TobyBorland/HydroTurbineBlade/docs/20120709_SaleD_pres_HARP_Opt.pdf

## HARP_Opt: An Optimization Code for System Design of Axial Flow Turbines

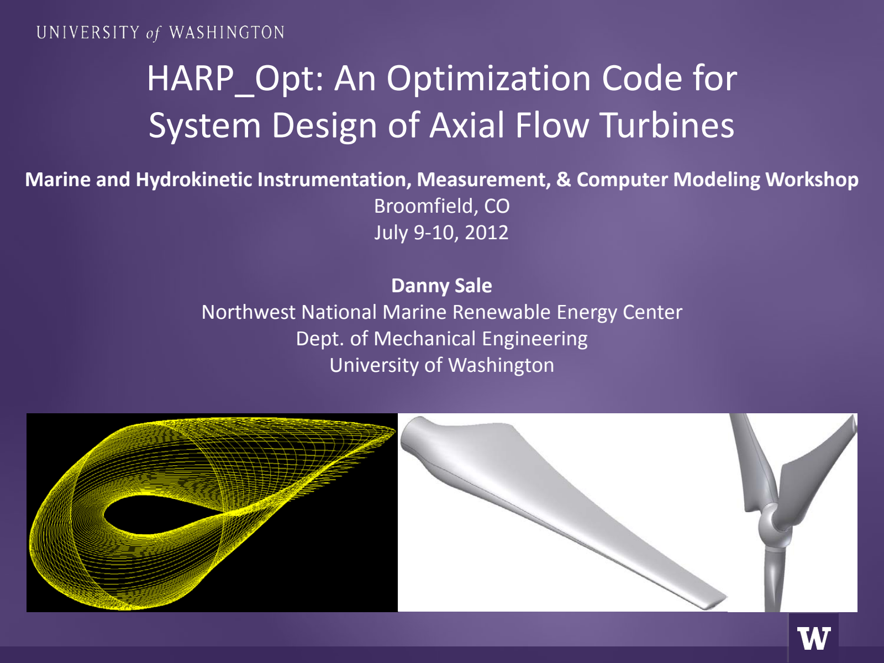
[picture p20: page 1]

Danny Sale
Northwest National Marine Renewable Energy Center Dept. of Mechanical Engineering University of Washington

Marine and Hydrokinetic Instrumentation, Measurement, & Computer Modeling Workshop Broomfield, CO
July 9-10, 2012

Objective
Develop a design tool for wind & hydrokinetic turbines rotors, combining
- aerodynamic models
- structural models
- multi-objective optimization

Motivation
- Difficult problem considering many variables & constraints
- Optimization leads to improved designs beyond our intuition
- Accelerate design process

Applications
- Sizing of new machines
- Modifications to existing designs

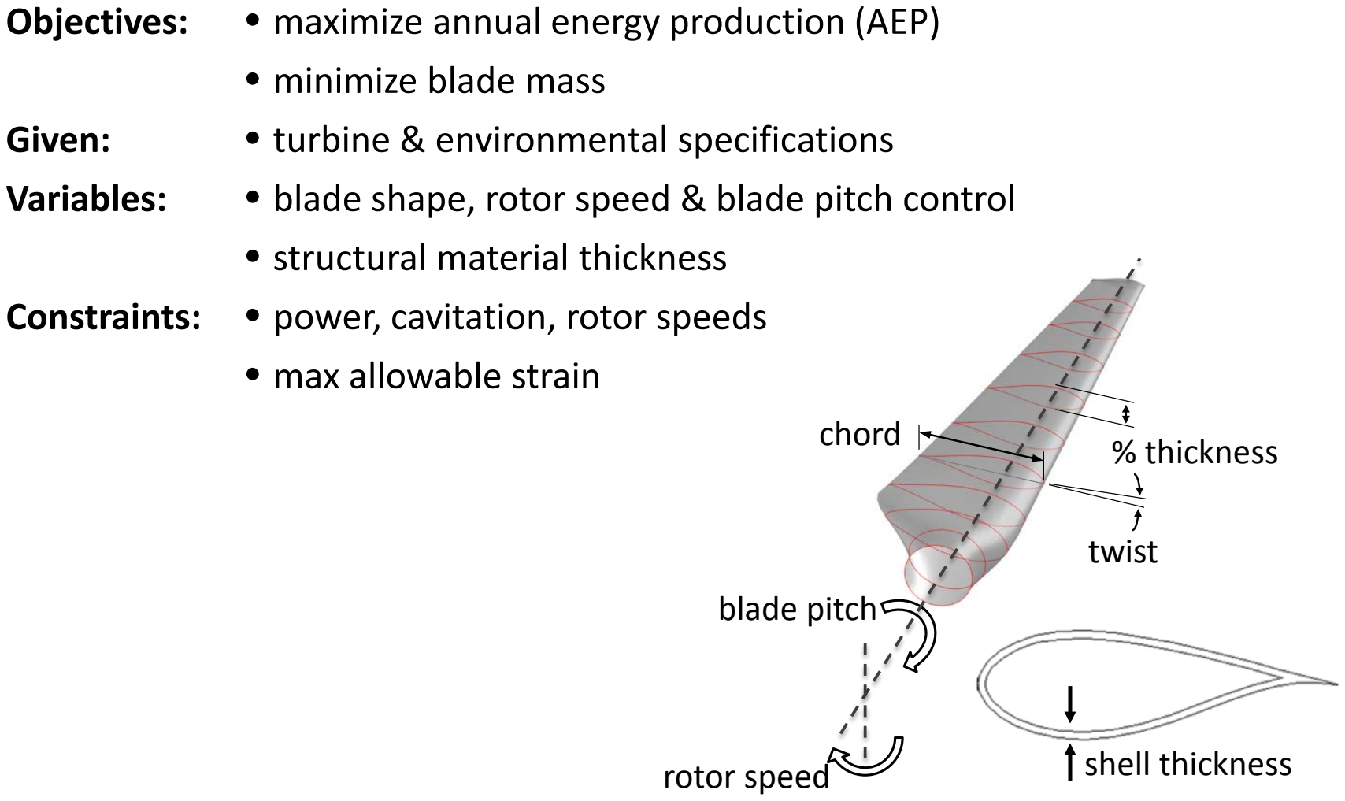
[picture p21: figure]
Objectives:; Given: Variables:; Constraints:; • minimize blade mass • turbine & environmental specifications; • structural material thickness • power, cavitation, rotor speeds • max allowable strain; chord; twist; % thickness; shell thickness; blade pitch; rotor speed

- maximize annual energy production (AEP)
- blade shape, rotor speed & blade pitch control

## Intro: HARP_Opt code

HARP_Opt (Horizontal Axis Rotor Performance Optimization)
An optimization code for the design of horizontal-axis wind and hydrokinetic turbines

## Technical Approach: Hydrodynamics

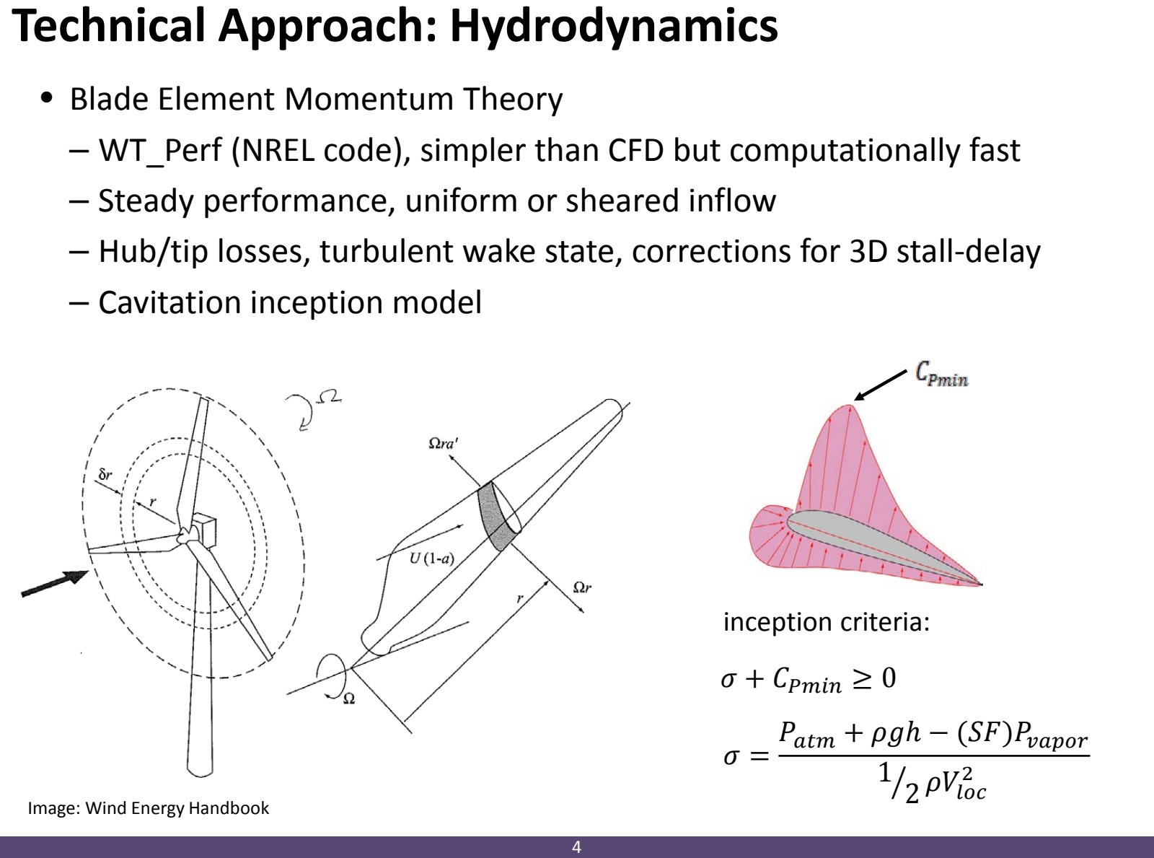
[picture p22: page 4]

Image: Wind Energy Handbook

- Blade Element Momentum Theory
– WT_Perf (NREL code), simpler than CFD but computationally fast – Steady performance, uniform or sheared inflow
– Hub/tip losses, turbulent wake state, corrections for 3D stall-delay – Cavitation inception model

# σ + CPPPP ≥ 0

σ =

# Paa + ρρρ − (SS)Pv vvv

1

# 2 ρρl l

2

inception criteria:

## Technical Approach: Structural Mechanics

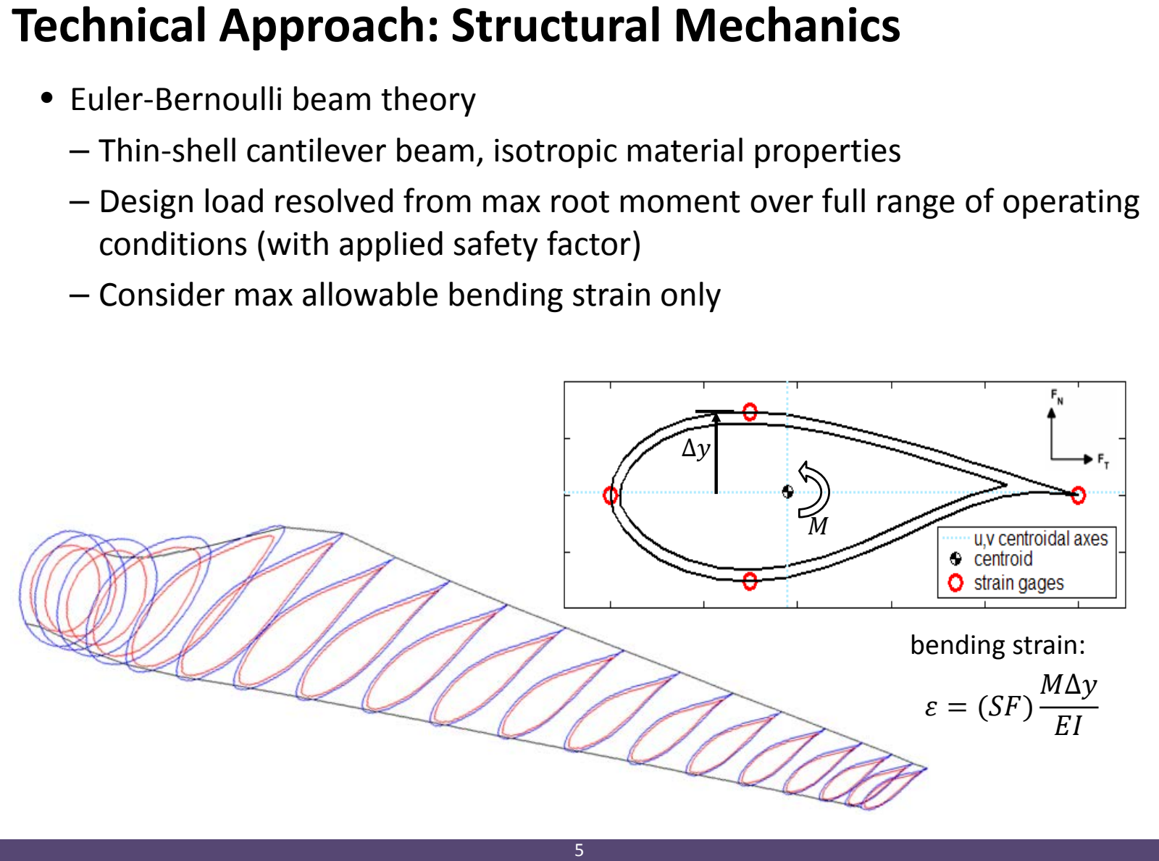
[picture p23: page 5]

bending strain:

# ε = (SS)

# MΔy

EE

M

Δy

- Euler-Bernoulli beam theory
– Thin-shell cantilever beam, isotropic material properties
– Design load resolved from max root moment over full range of operating conditions (with applied safety factor)
– Consider max allowable bending strain only

## Technical Approach: Optimization

Optimization Algorithm
- Multi-Objective Genetic Algorithm
– Mimics biological evolution, i.e. “survival of the fittest”
– Slow convergence, good for multi-optima problems, no gradient info required Objectives and Fitness Function
- Penalty method (a constrained problem becomes unconstrained)

# AAA ∗ p

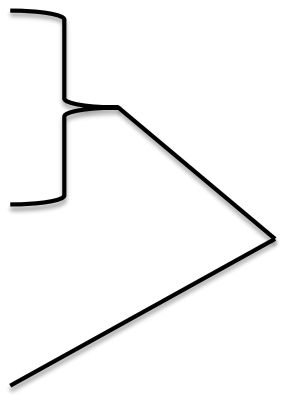
[picture p24: figure]

# bbbbb m mm ∗ p

## p pp

p

# p tt

# p t t tt

Maximize:

Minimize:

Penalty factors are proportional to the violation of constraints

## Technical Approach: Blade Geometry

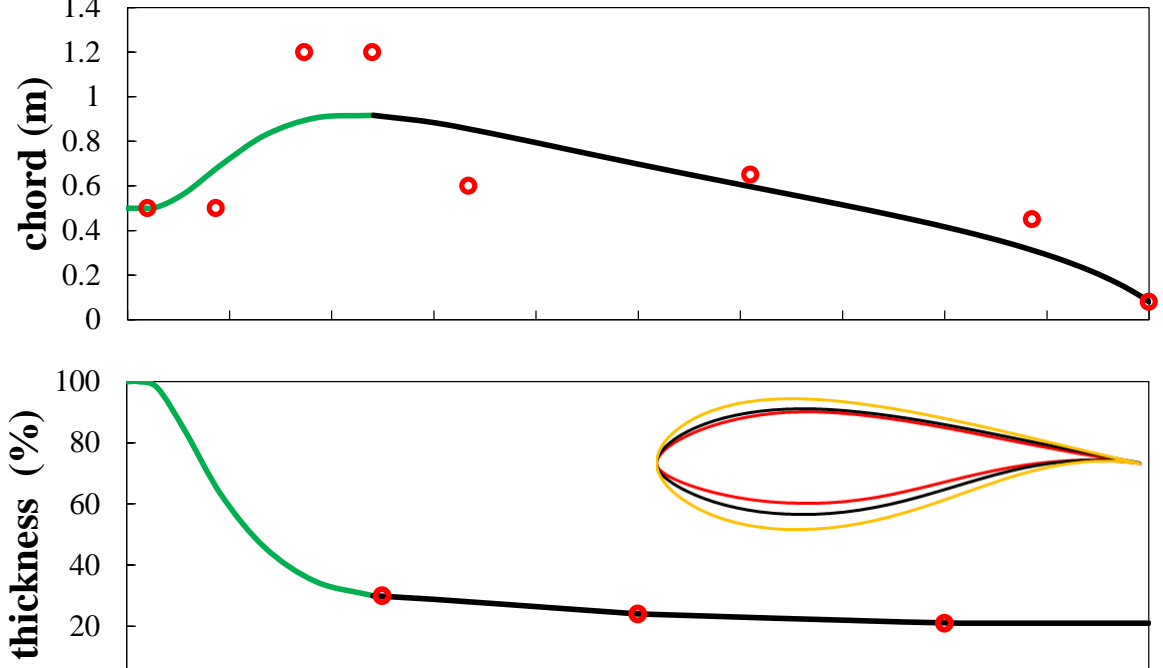
[picture p25: figure]
chord (m); thickness (%)
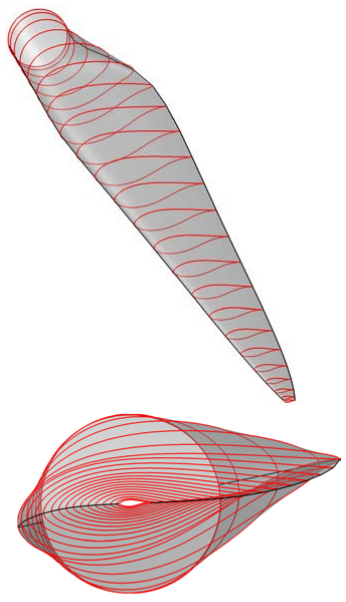
[picture p26: figure]

•Bézier curves define twist and chord distributions
•% thickness denotes airfoil placement
•Great degree of freedom in possible blade shapes

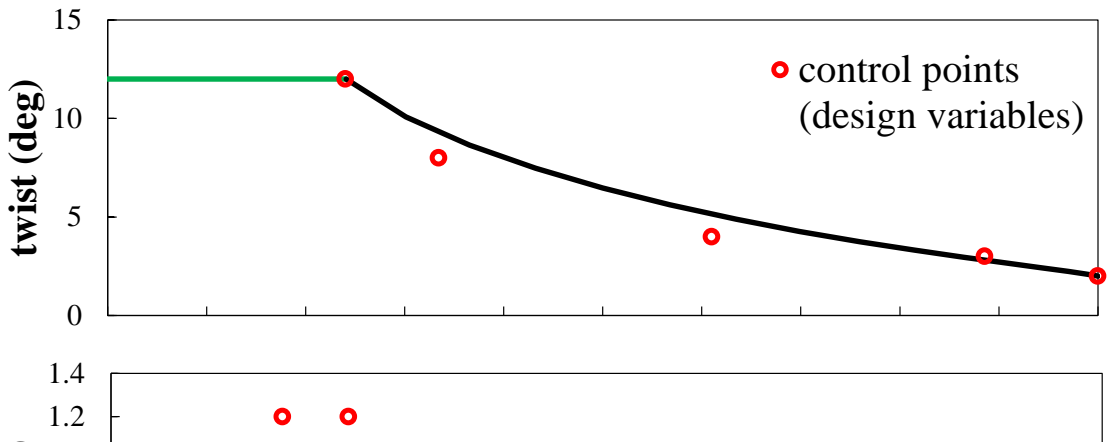
[picture p27: figure]
twist (deg); control points (design variables)
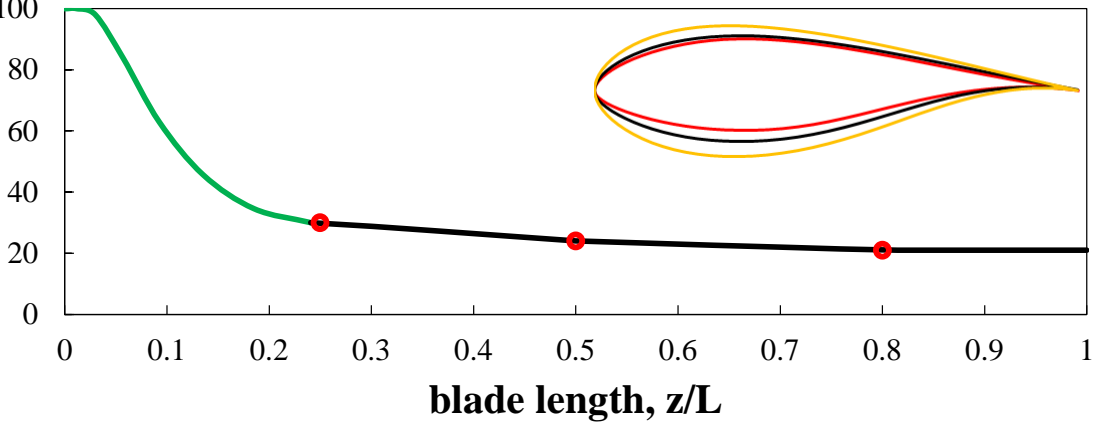
[picture p28: figure]
blade length, z/L

## Technical Approach: Design Algorithm

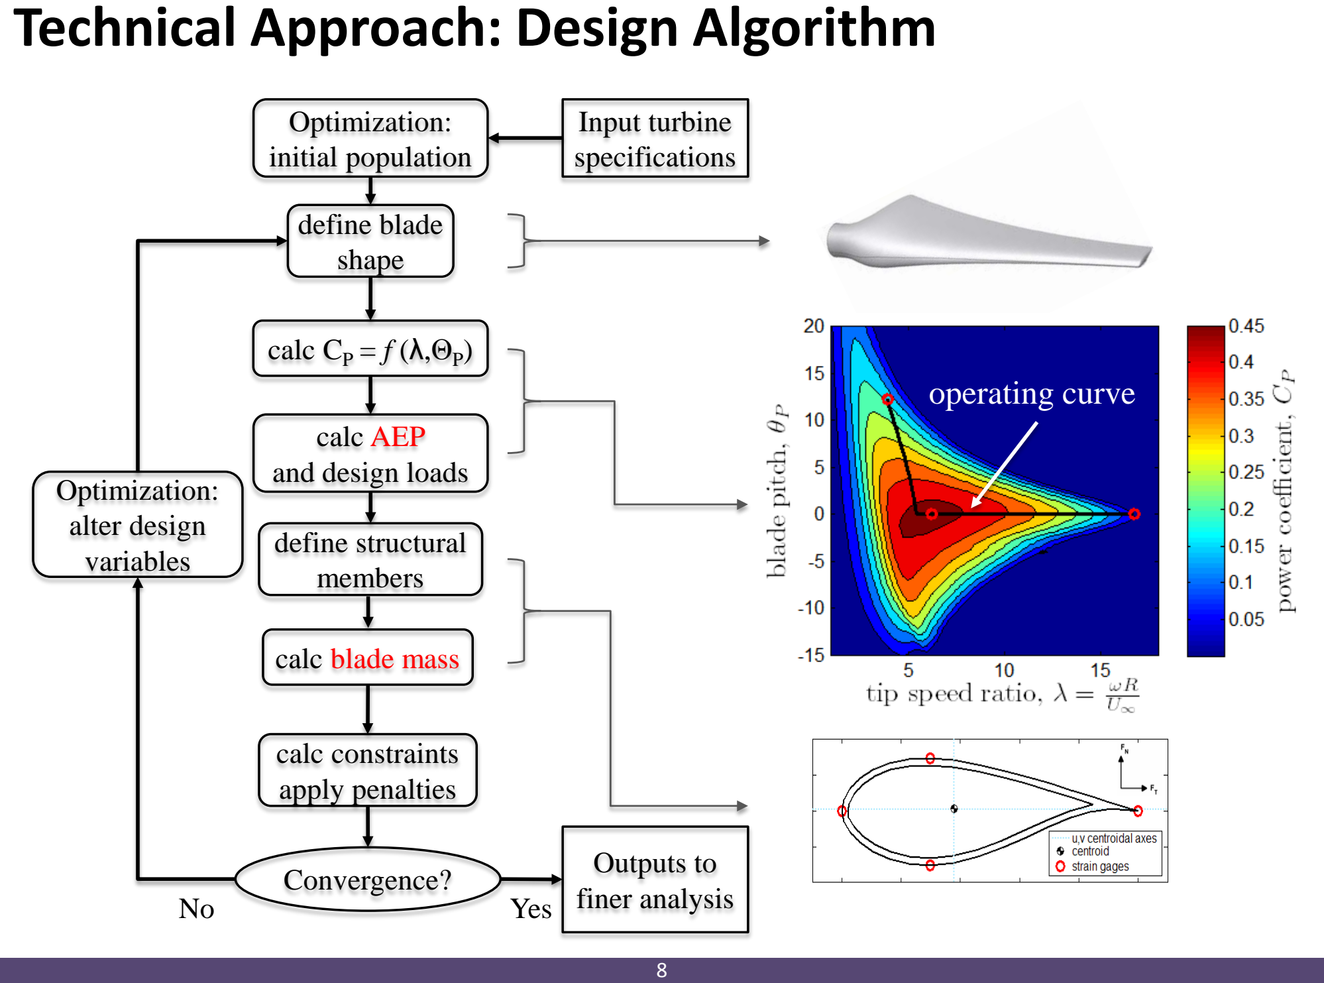
[picture p29: page 8]

Input turbine
specifications

Optimization:
initial population
define blade
shape

calc CP = f (λ,ΘP)

calc AEP
and design loads

define structural
members

calc blade mass

calc constraints
apply penalties

Convergence?

Optimization:
alter design
variables

Outputs to
No | Yes finer analysis

operating curve

## Applications: Example #1

Design of 5m dia., 72 kW MHK turbine: investigate various control schemes
- Fixed-Speed Fixed-Pitch
- Fixed-Speed Variable-Pitch
- Variable-Speed Variable-Pitch
- Variable-Speed Fixed-Pitch

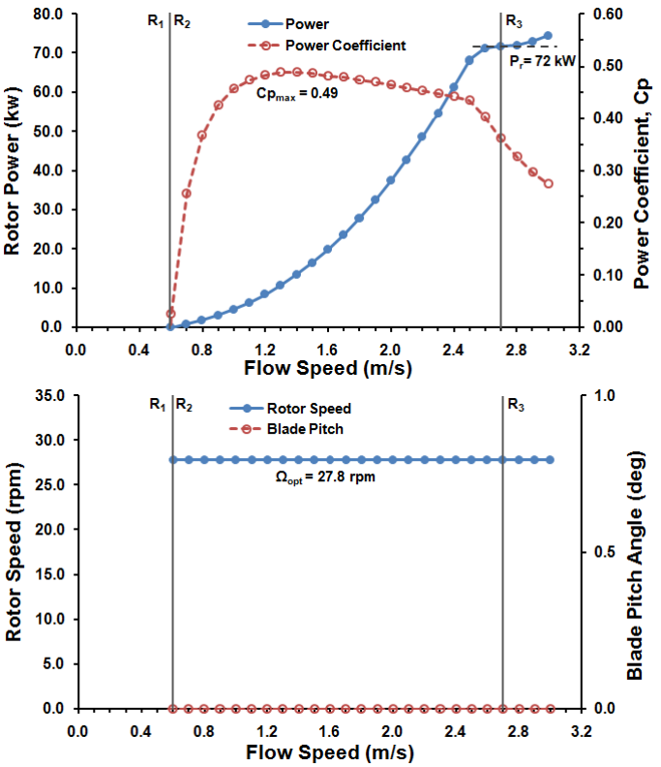
[picture p30: figure]

## Applications: Example #1

Design of 5m dia., 72 kW MHK turbine: investigate various control schemes
- Fixed-Speed Fixed-Pitch
- Fixed-Speed Variable-Pitch
- Variable-Speed Variable-Pitch
- Variable-Speed Fixed-Pitch

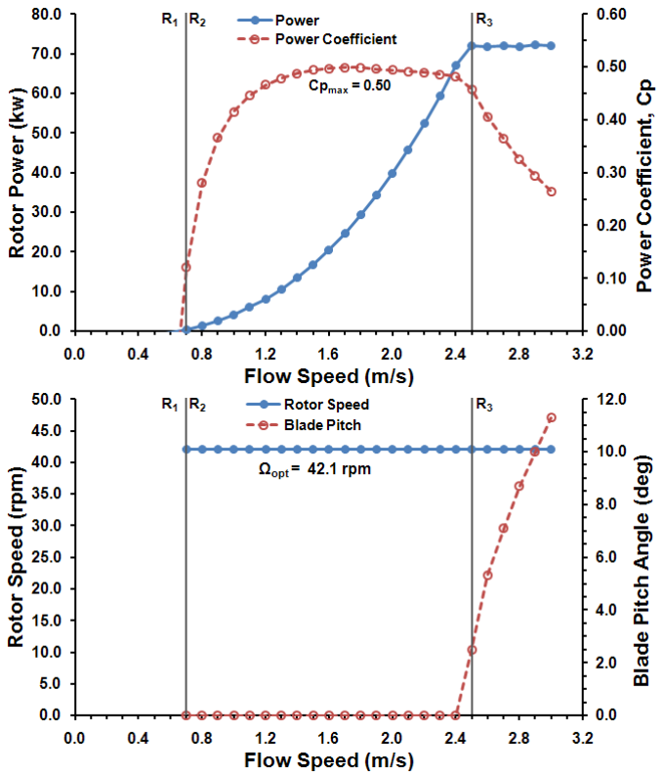
[picture p31: figure]

## Applications: Example #1

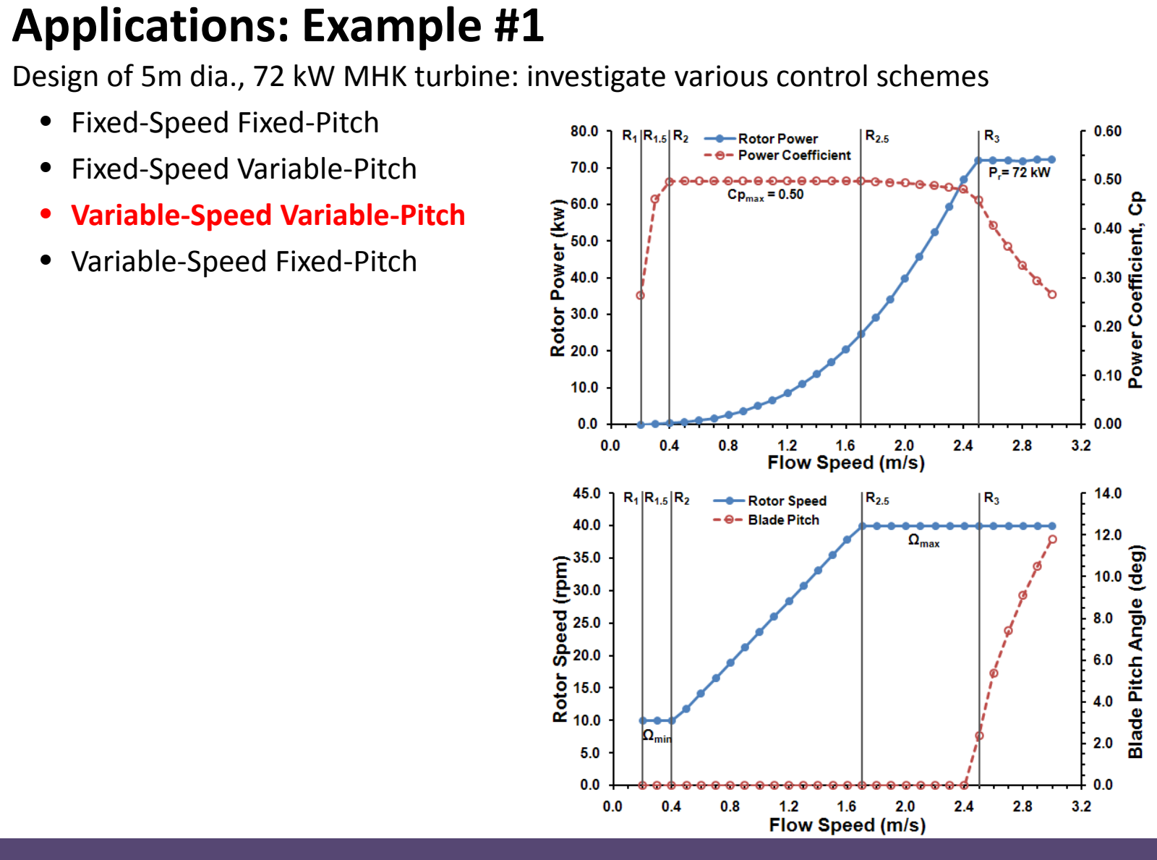
[picture p32: page 11]

Design of 5m dia., 72 kW MHK turbine: investigate various control schemes
- Fixed-Speed Fixed-Pitch
- Fixed-Speed Variable-Pitch
- Variable-Speed Variable-Pitch
- Variable-Speed Fixed-Pitch

## Applications: Example #1

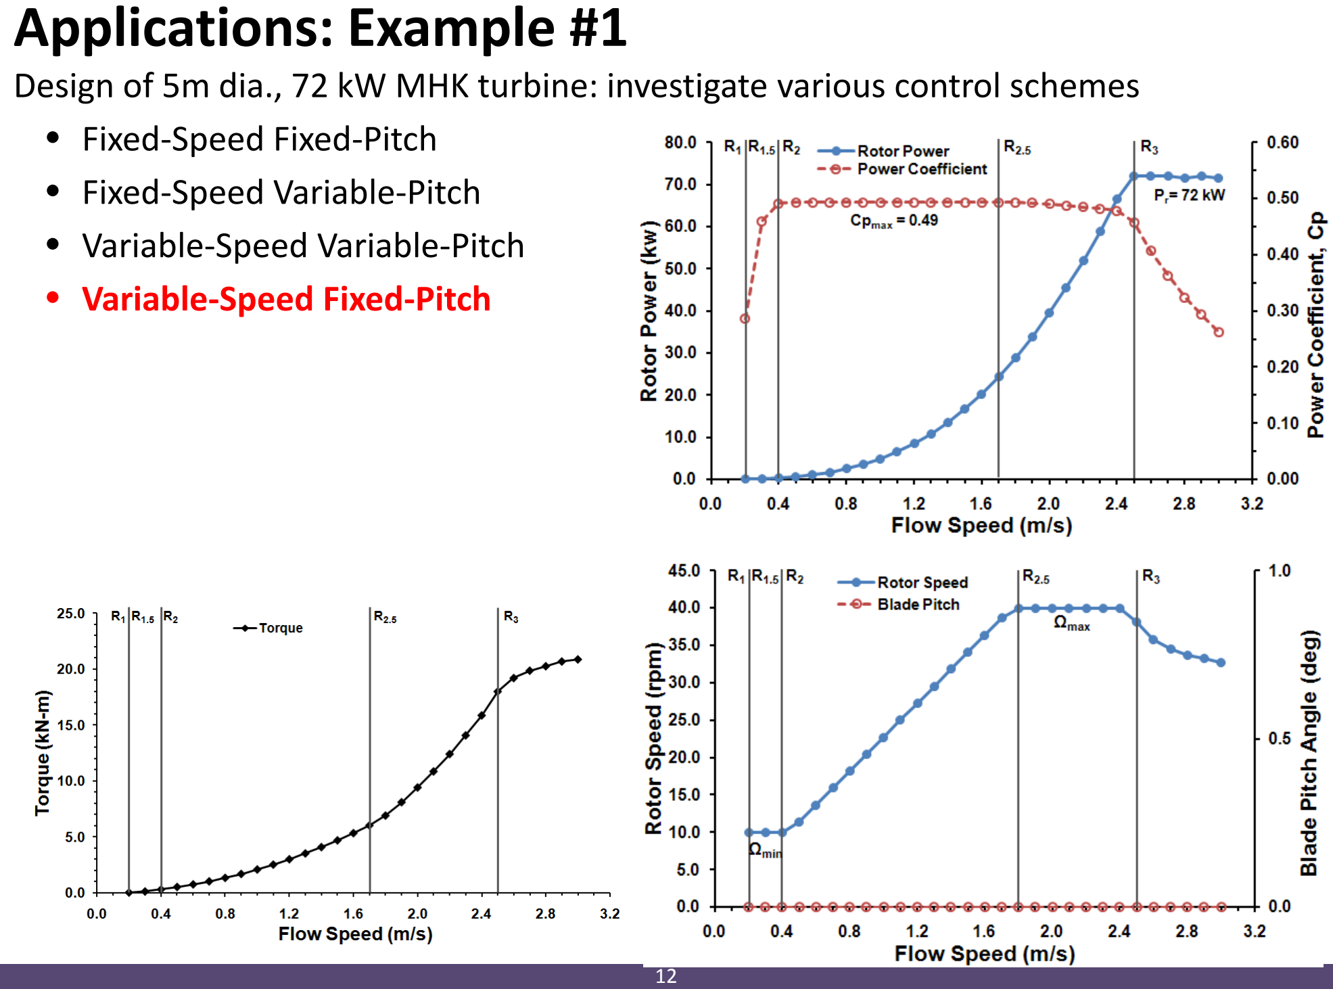
[picture p33: page 12]
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

## Applications: Example #1

Summary of Performance Data
Vrated | Cpmax | AEP | Max Flap | Max Torque | Max Thrust
(m/s) | (-) | (kW-hr/yr) | (kN-m) | (kN-m) | (kN)
FS-FP | 2.7 | 0.49 | 148000 | 21.7 | 25.6 | 47.0
FS-VP | 2.5 | 0.50 | 152000 | 21.4 | 16.4 | 46.0
VS-VP | 2.5 | 0.50 | 155000 | 21.5 | 17.3 | 45.7
VS-FP | 2.5 | 0.49 | 154000 | 22.0 | 20.9 | 45.8

## Applications: Example #2

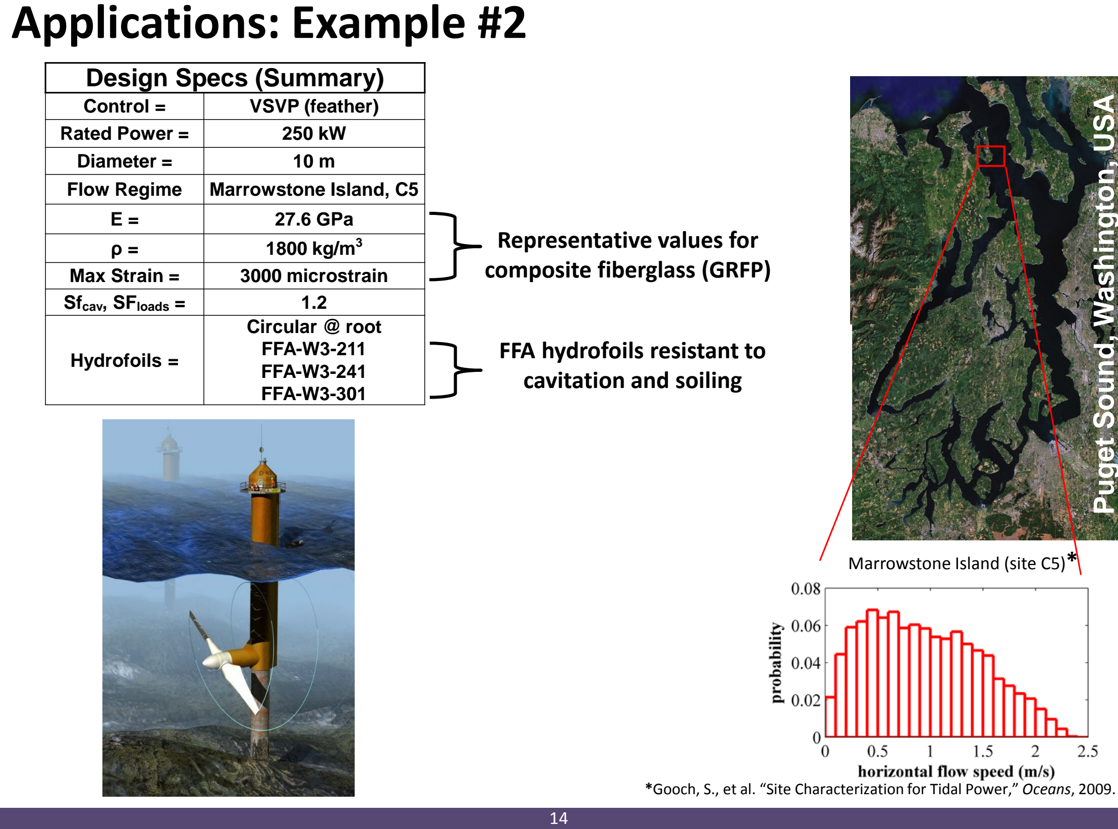
[picture p34: page 14]

Design Specs (Summary)
Control = | VSVP (feather)
Rated Power = | 250 kW
Diameter = | 10 m
Flow Regime | Marrowstone Island, C5
E = | 27.6 GPa
ρ = | 1800 kg/m³
Max Strain = | 3000 microstrain
Sfcav, SFloads = | 1.2
Hydrofoils = | Circular @ root FFA-W3-211 FFA-W3-241 FFA-W3-301

Marrowstone Island (site C5)*

*Gooch, S., et al. “Site Characterization for Tidal Power,” Oceans, 2009.Puget Sound, Washington, USA

Representative values for
composite fiberglass (GRFP)

FFA hydrofoils resistant to cavitation and soiling

## Applications: Example #2

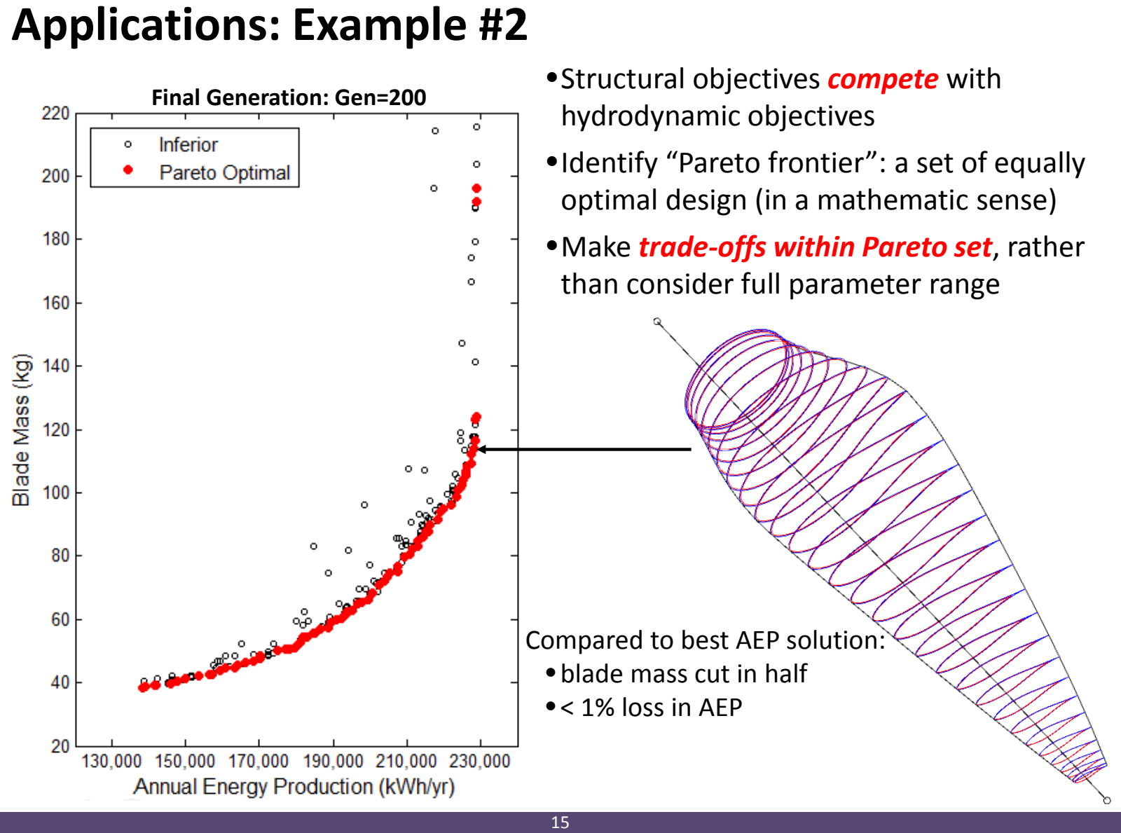
[picture p35: page 15]

•Mass = ? kg
•AEP = ? kWh/yr
•Cost: fiberglass = ? $/kg •Cost = ? $

Final Generation: Gen=200

•Structural objectives compete with hydrodynamic objectives
•Identify “Pareto frontier”: a set of equally optimal design (in a mathematic sense) •Make trade-offs within Pareto set, rather than consider full parameter range

Compared to best AEP solution:
- blade mass cut in half
- < 1% loss in AEP

## Moving Forward:

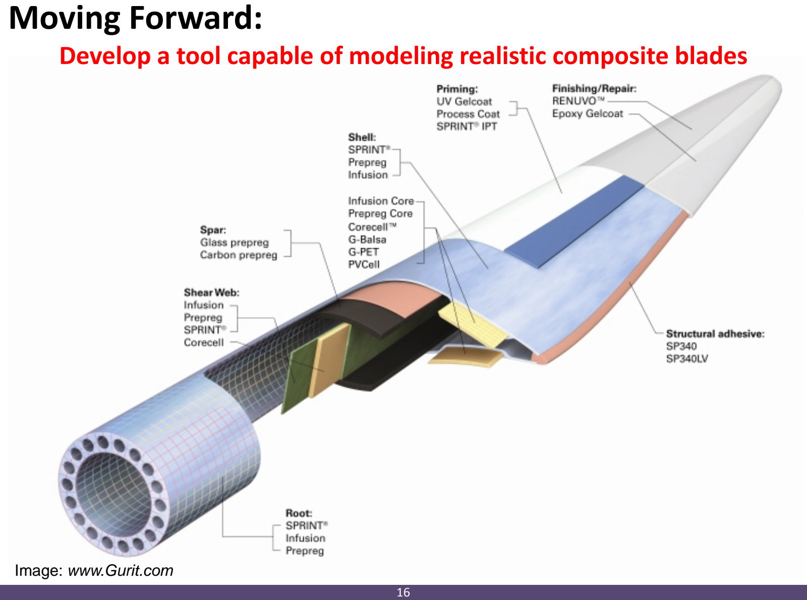
[picture p36: page 16]

### Develop a tool capable of modeling realistic composite blades

Image: www.Gurit.com

## Future Direction: Advanced Structural Optimization

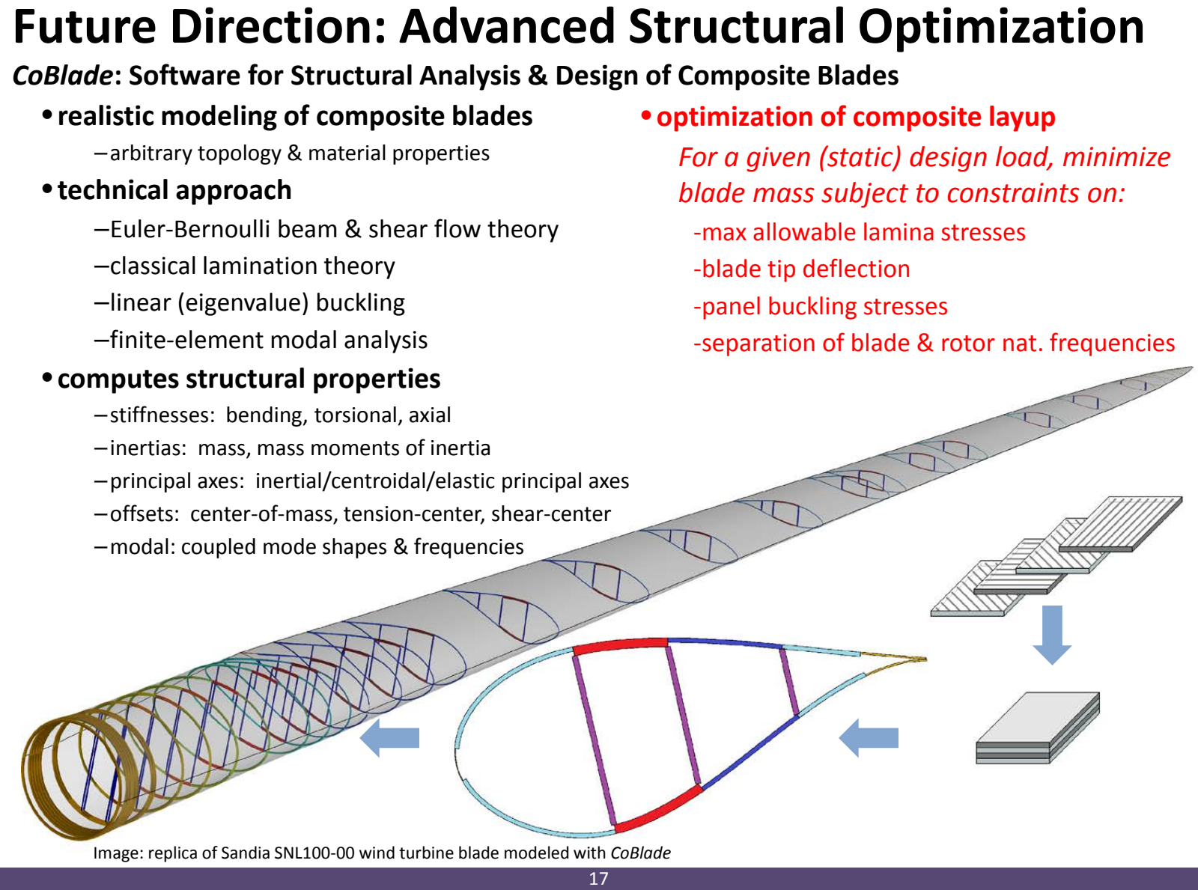
[picture p37: page 17]

CoBlade: Software for Structural Analysis & Design of Composite Blades •realistic modeling of composite blades
–arbitrary topology & material properties
•technical approach
–Euler-Bernoulli beam & shear flow theory –classical lamination theory
–linear (eigenvalue) buckling –finite-element modal analysis
- computes structural properties
–stiffnesses: bending, torsional, axial
–inertias: mass, mass moments of inertia
–principal axes: inertial/centroidal/elastic principal axes –offsets: center-of-mass, tension-center, shear-center –modal: coupled mode shapes & frequencies

Image: replica of Sandia SNL100-00 wind turbine blade modeled with CoBlade

- optimization of composite layup
For a given (static) design load, minimize blade mass subject to constraints on: -max allowable lamina stresses
-blade tip deflection
-panel buckling stresses
-separation of blade & rotor nat. frequencies

## Future Direction: Advanced Structural Optimization

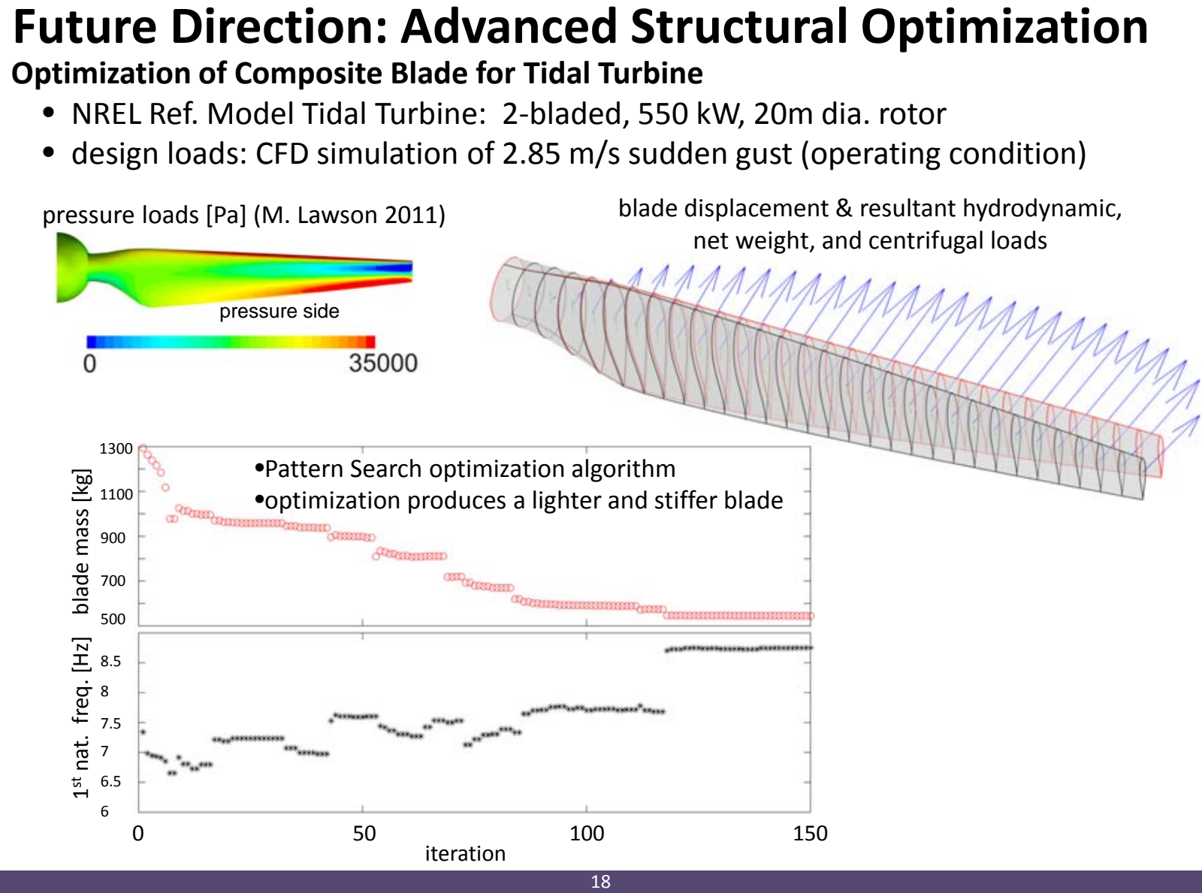
[picture p38: page 18]

Optimization of Composite Blade for Tidal Turbine
- NREL Ref. Model Tidal Turbine: 2-bladed, 550 kW, 20m dia. rotor
- design loads: CFD simulation of 2.85 m/s sudden gust (operating condition) blade mass [kg]

1st nat. freq. [Hz]

1300

1100

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
iteration

0 | 50 | 100 | 150

pressure loads [Pa] (M. Lawson 2011)

pressure side

blade displacement & resultant hydrodynamic, net weight, and centrifugal loads

•Pattern Search optimization algorithm •optimization produces a lighter and stiffer blade

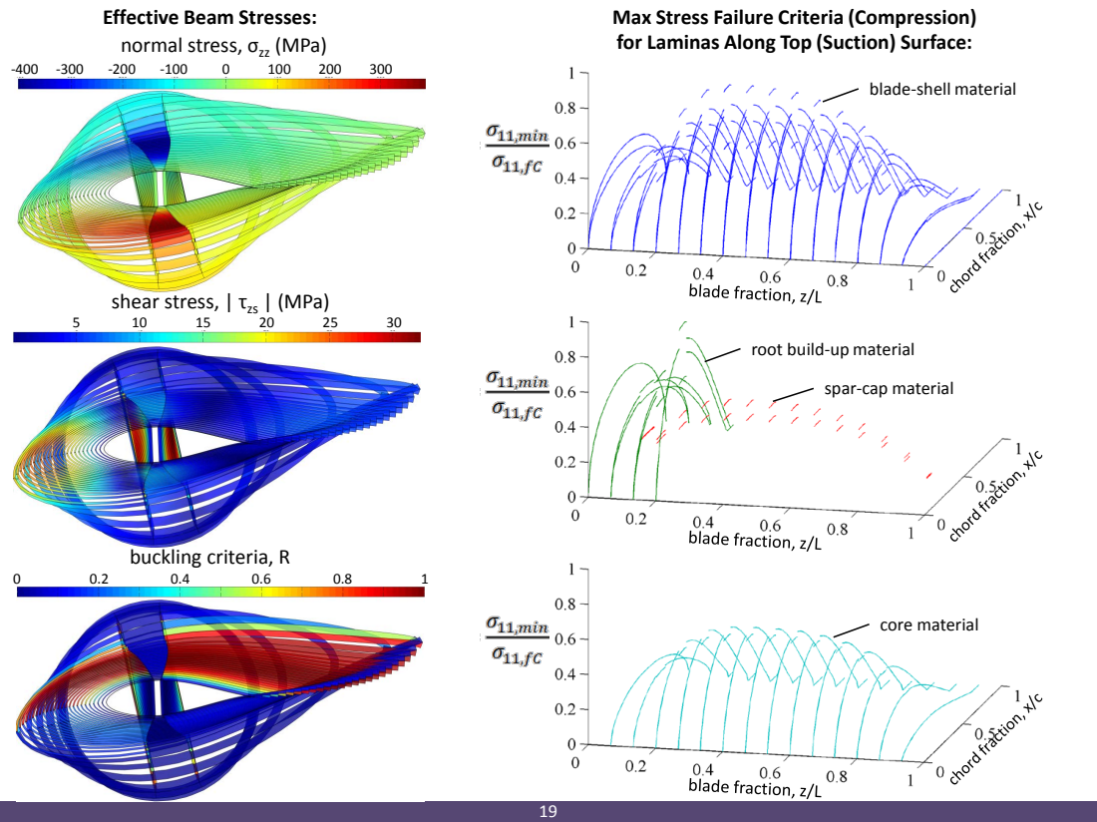
[picture p39: page 19]
buckling criteria, R; core material

Effective Beam Stresses:
normal stress, σzz (MPa)

Max Stress Failure Criteria (Compression)
for Laminas Along Top (Suction) Surface:

blade-shell material

shear stress, | τzs | (MPa)

root build-up material

spar-cap material

## Areas for Refinement

## Progress to-date:

- developed preliminary design tool for axial flow wind & hydrokinetic turbines, method is generalized to a variety of turbine configurations & sizes
- consideration of multiple design criteria & constraints leads to satisfactory design in all areas (hydrodynamics, structures, & controls)
- enabling improved performance & reduced design time

Short-term (Sept. 2012 release)
- implement Pattern Search optimization algorithm (much faster & deterministic)
- improve MATLAB/Fortran interface, allowing for parallel HPC
- make HARP_Opt cross-platform, develop GUI and non-GUI versions for improved usability & interfacing
Longer-term
- consider fatigue as design criteria (hydro-elastic analysis, i.e. FAST code)

# Thank you! Questions?

# Acknowledgements

This work has also been made possible by
- U.S. Department of Energy, National Renewable Energy Laboratory
- University of Washington, Northwest National Marine Renewable Energy Center
- National Science Foundation, Graduate Research Fellowship under Grant No. DGE-0718124 wind.nrel.gov/designcodes/simulators/HARP_Opt/ wind.nrel.gov/designcodes/simulators/WT_Perf/

WT_Perf: Turbine Performance Simulator

HARP_Opt: Optimization Software for Turbine Design

CoBlade: Software for Analysis & Design of Composite Blades
no website yet—contact dsale@uw.edu for source & documentation
Sale & Aliseda (2012) “Structural Design of Composite Blades for Wind &Hydrokinetic Turbines” depts.washington.edu/nnmrec/docs/20120213_SaleD_pres_StructuralDesign.pdf

Special thanks to the crew at NWTC!

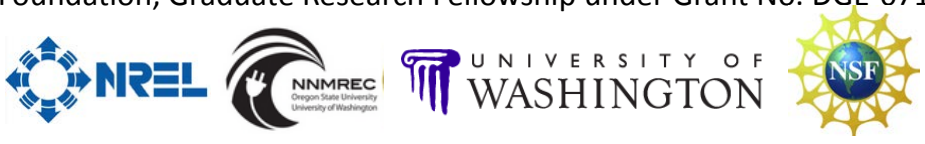
[picture p40: figure]
