TobyBorland/HydroTurbineBlade/SWKS_hydrofoil/bladedesign.xls

blade design spreadsheet
first finding the diameter:
BLUE CELLS FOR DATA ENTRY RED FOR RESULTS
Tip speed ratio | TSR | 7
Diameter (m) | D | 2.00
number of blades ? | B | 3
angle of attack (degrees) | AT | 4
Lift coefficient | Cl | 0.8
No. of stations | STN | 10
 |  |  |  | All dimensions in metres. [0.001m=1mm.]
 |  |  |  | recommended |  | Enter chosen widths
station | radius | angle | angle | Chord | wood width | actual wood width | drop | thickness(m)
 | rad. | AB radians | AB degrees | C | WW | ww2 |  | T
1 | 0.10 | 0.691 | 39.6 | 0.250 | 0.192 | 0.150 | 0.1241045225 | 0.039
2 | 0.20 | 0.375 | 21.5 | 0.194 | 0.181 | 0.150 | 0.05897663736 | 0.024
3 | 0.30 | 0.238 | 13.6 | 0.144 | 0.140 | 0.140 | 0.03393845251 | 0.019
4 | 0.40 | 0.164 | 9.4 | 0.113 | 0.111 | 0.111 | 0.0183864749 | 0.014
5 | 0.50 | 0.118 | 6.8 | 0.092 | 0.091 | 0.091 | 0.01085722461 | 0.011
6 | 0.60 | 0.088 | 5.0 | 0.077 | 0.077 | 0.077 | 0.006773530928 | 0.009
7 | 0.70 | 0.065 | 3.7 | 0.067 | 0.067 | 0.067 | 0.004366082225 | 0.008
8 | 0.80 | 0.049 | 2.8 | 0.059 | 0.059 | 0.059 | 0.002856111792 | 0.007
9 | 0.90 | 0.036 | 2.0 | 0.052 | 0.052 | 0.052 | 0.001863377037 | 0.006
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
