TobyBorland/HydroTurbineBlade/docs/images/1W5_BW3_1m_Input.bmp

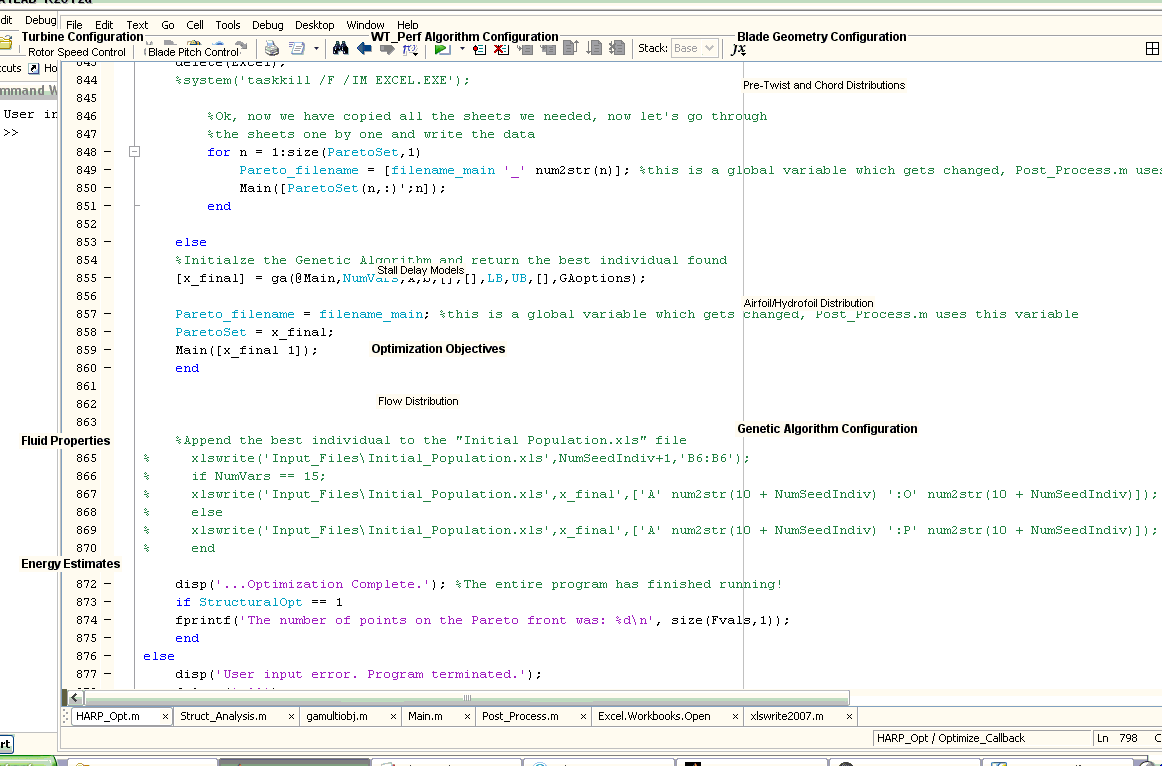
docs/images/1W5_BW3_1m_Input.bmp
