TobyBorland/HydroTurbineBlade/docs/images/BladesX3.JPG

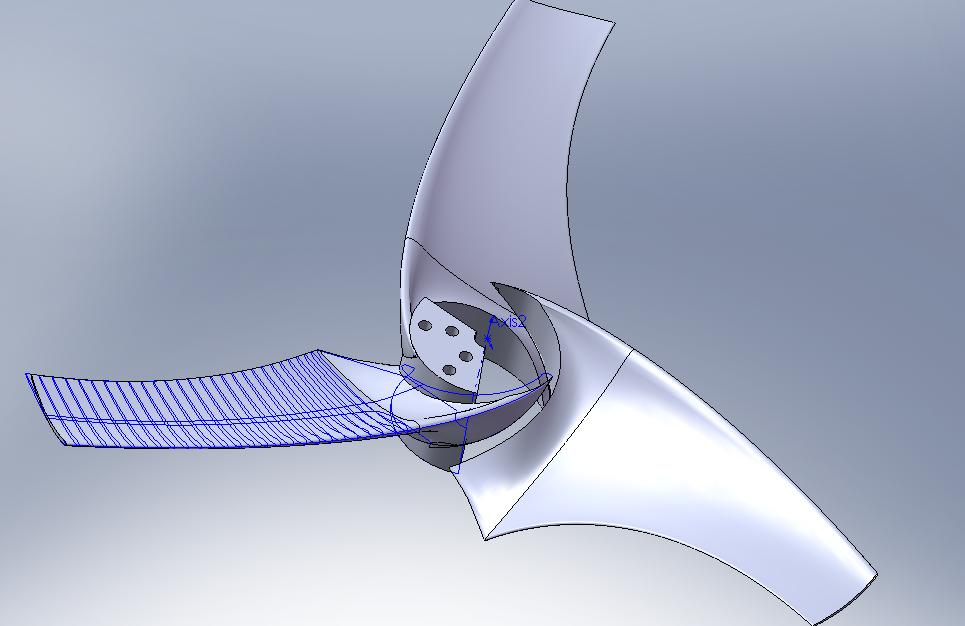
docs/images/BladesX3.JPG
