TobyBorland/HydroTurbineBlade/docs/images/Flange_dims.png

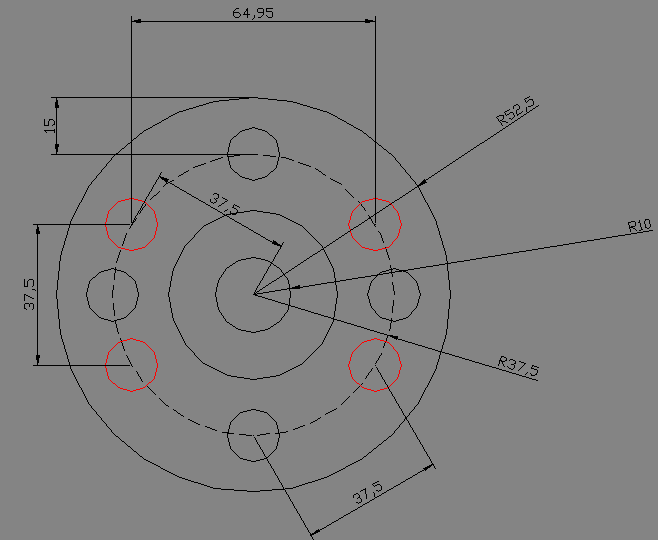
docs/images/Flange_dims.png
