TobyBorland/HydroTurbineBlade/docs/images/foils.JPG

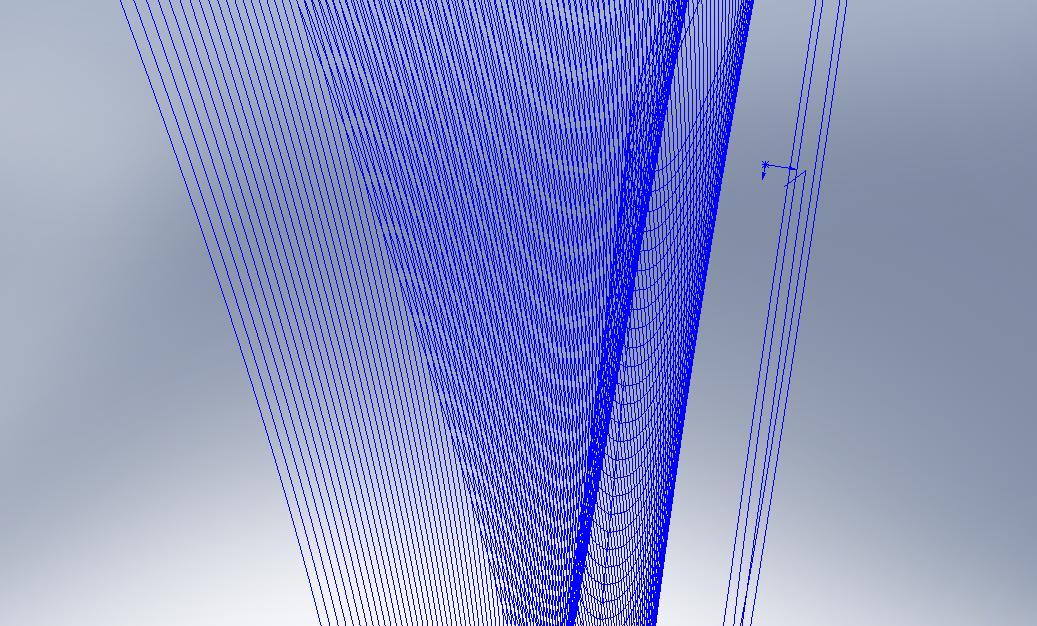
docs/images/foils.JPG
