TobyBorland/HydroTurbineBlade/docs/images/Maidenhead flow rate.png

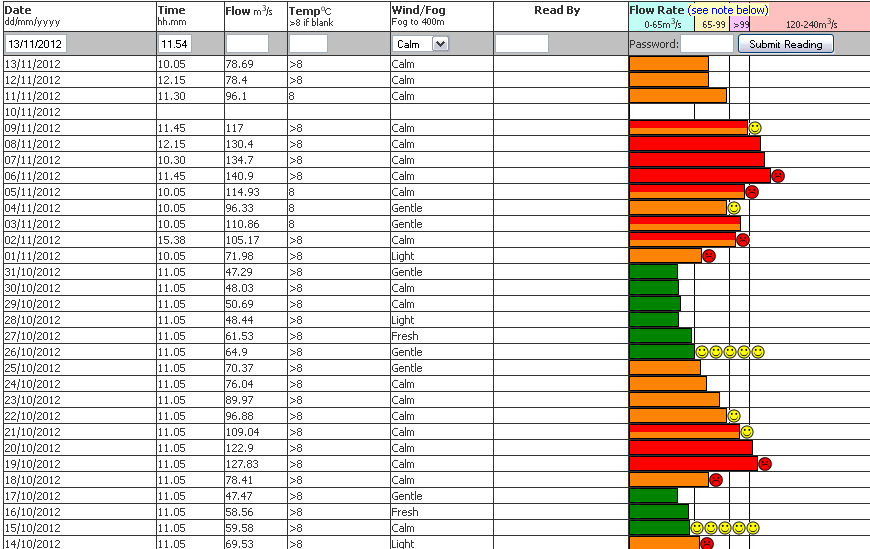
docs/images/Maidenhead flow rate.png
