TobyBorland/HydroTurbineBlade/docs/images/Root_curve2.JPG

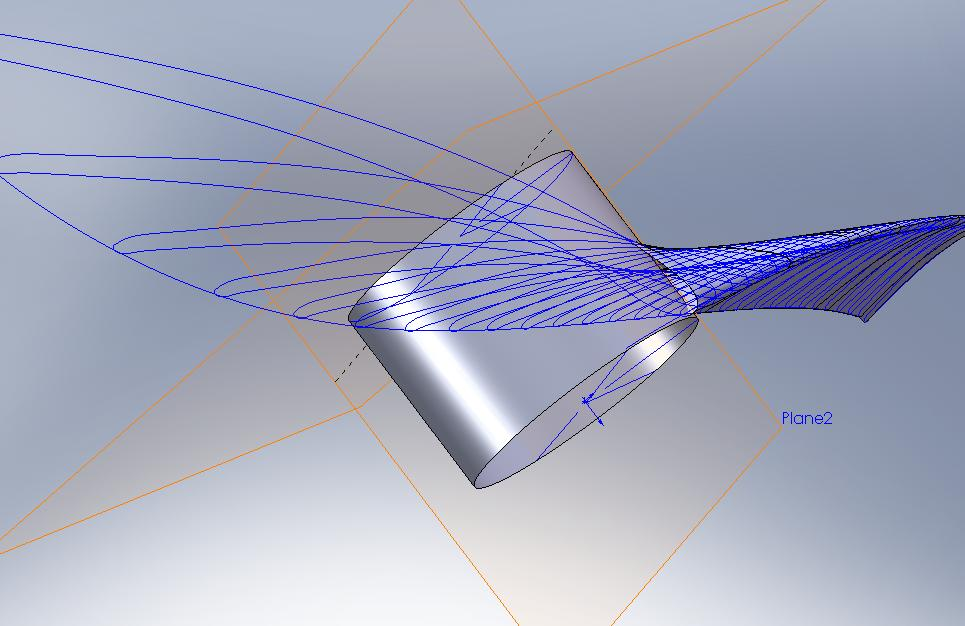
docs/images/Root_curve2.JPG
