TobyBorland/HydroTurbineBlade/docs/images/Spiral curvature.png

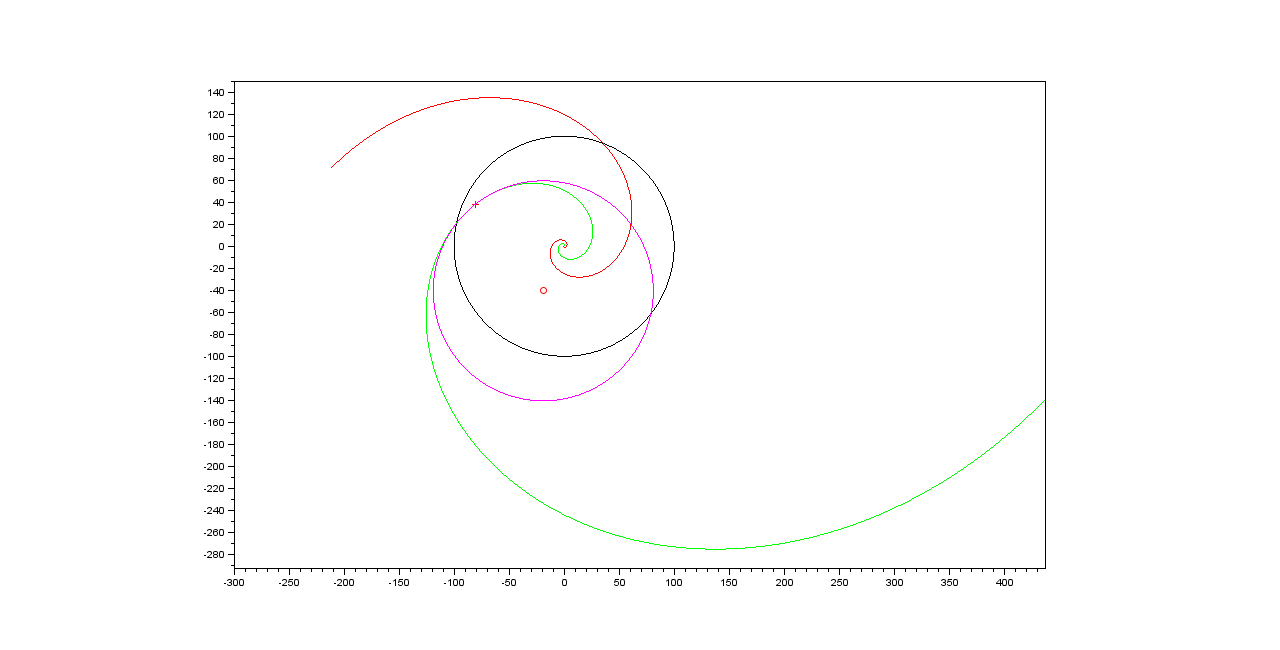
docs/images/Spiral curvature.png
