TobyBorland/HydroTurbineBlade/docs/images/Thames_Tower_level.png

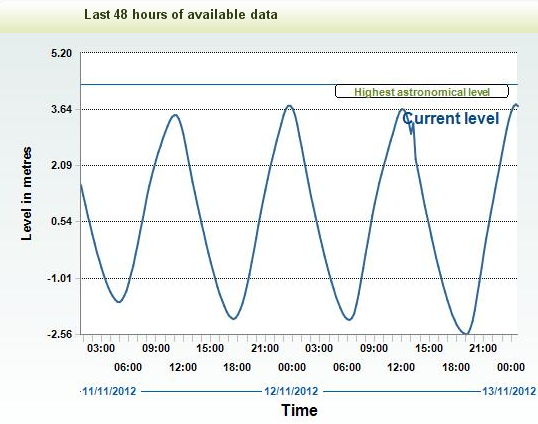
docs/images/Thames_Tower_level.png
