TobyBorland/HydroTurbineBlade/HARP/HARP2SWKS/sweep_log.png

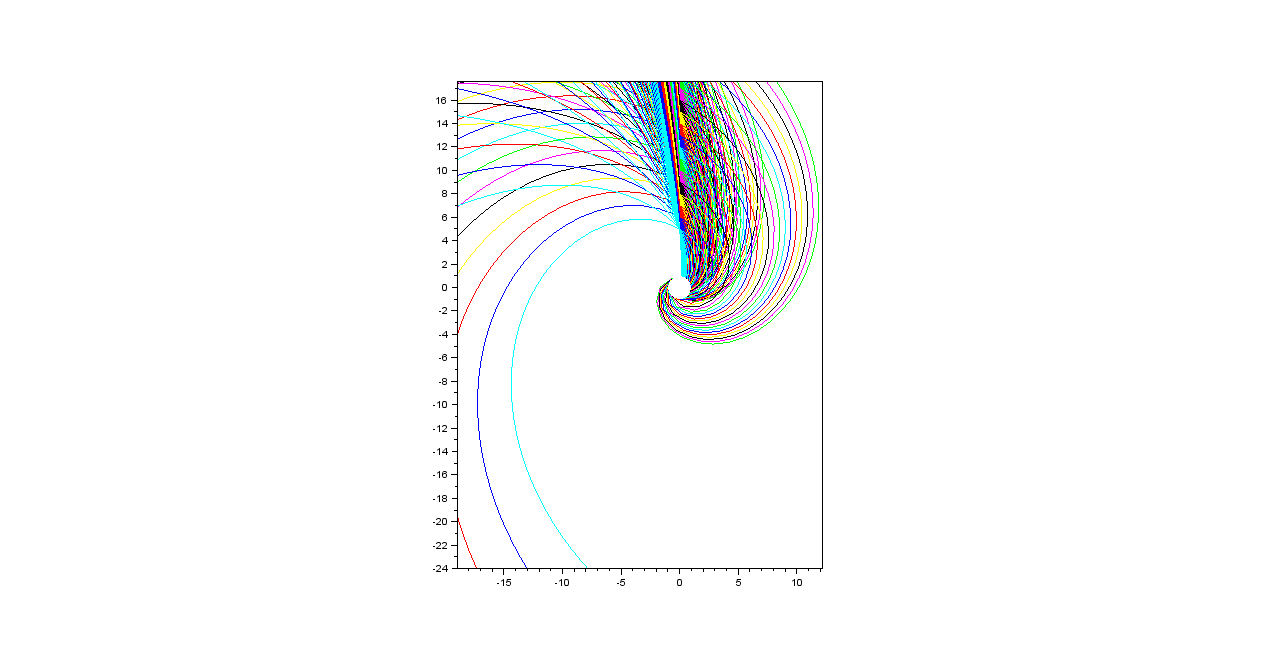
HARP/HARP2SWKS/sweep_log.png
