TobyBorland/HydroTurbineBlade/HARP/Output_Files/1kW_HydroTurbine/1kW_HydroTurbine_Input.bmp

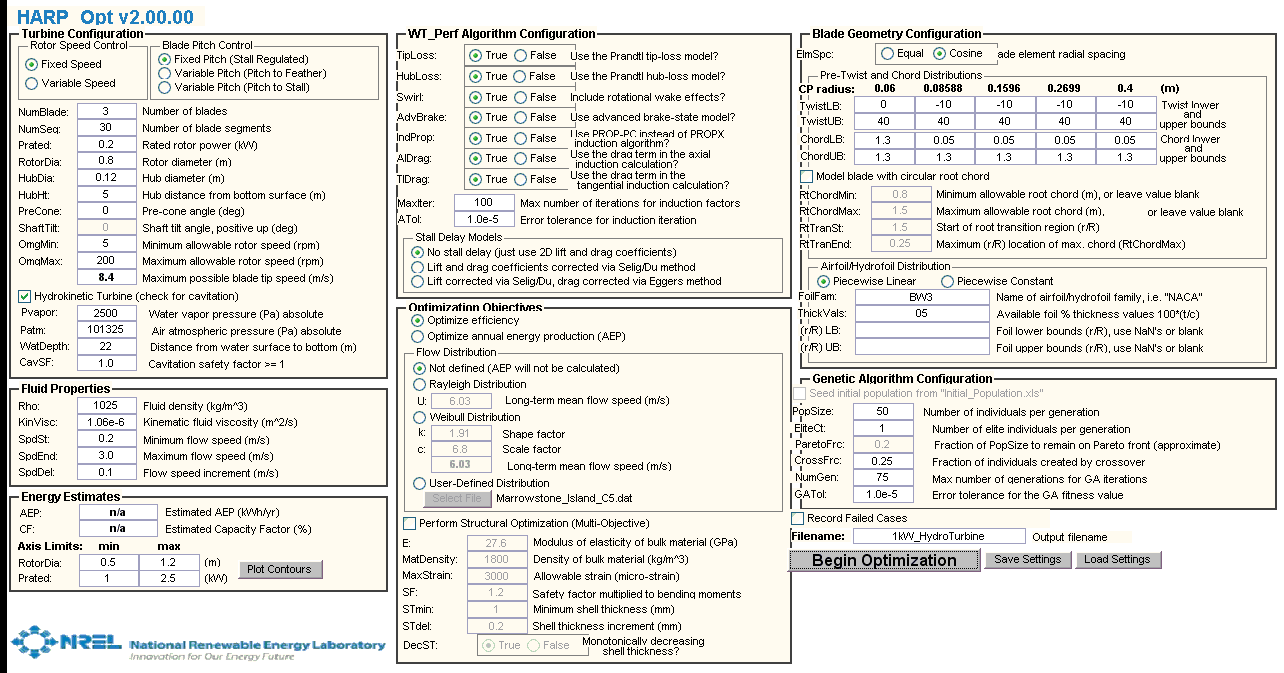
HARP/Output_Files/1kW_HydroTurbine/1kW_HydroTurbine_Input.bmp
