TobyBorland/HydroTurbineBlade/HARP/Output_Files/200kW_HydroTurbine/200kW_HydroTurbine_Pareto.bmp

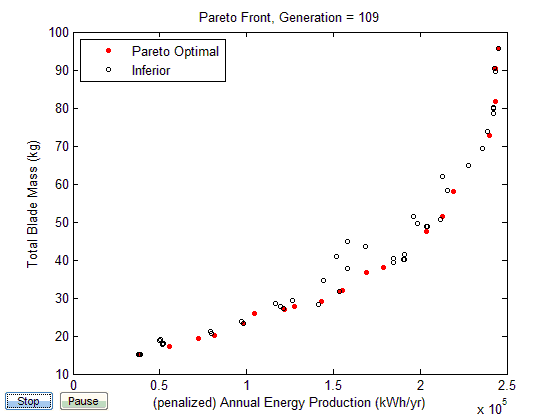
HARP/Output_Files/200kW_HydroTurbine/200kW_HydroTurbine_Pareto.bmp
