TobyBorland/HydroTurbineBlade/Polar_data/7037B.LFT.png

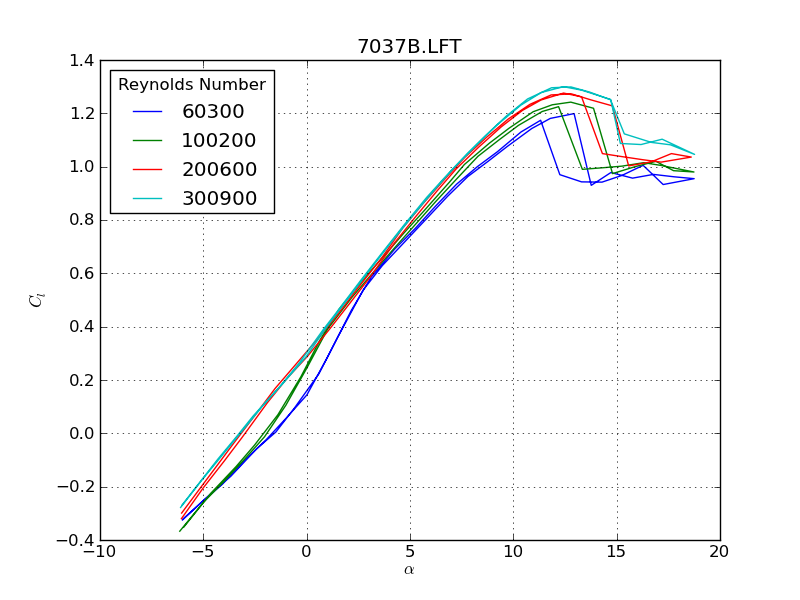
Polar_data/7037B.LFT.png
