TobyBorland/HydroTurbineBlade/Polar_data/7037BF10.LFT.png

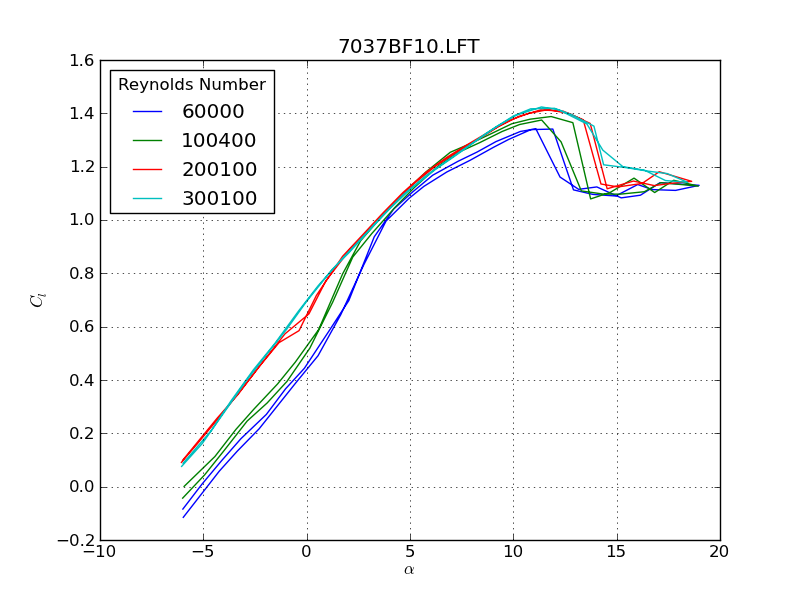
Polar_data/7037BF10.LFT.png
