TobyBorland/HydroTurbineBlade/Polar_data/7037CBF4.LFT.png

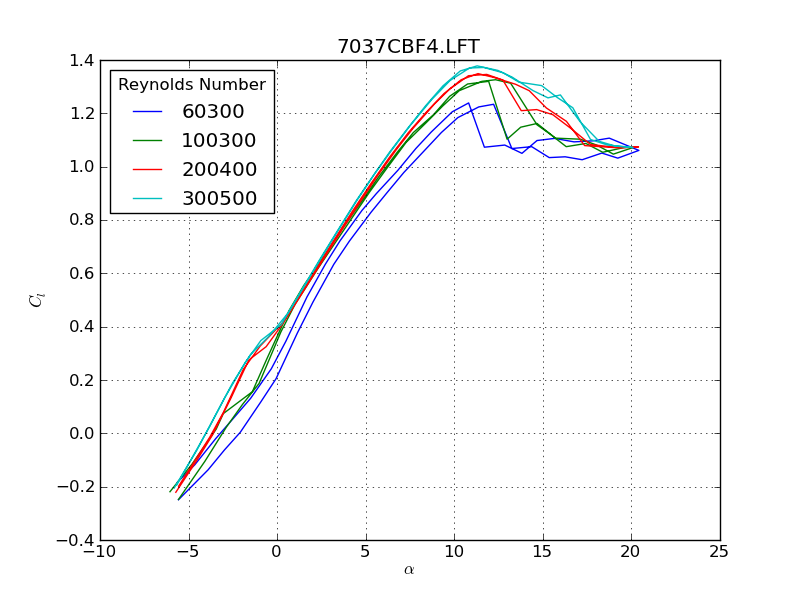
Polar_data/7037CBF4.LFT.png
