TobyBorland/HydroTurbineBlade/Polar_data/Hydrofoil_sweep_model.jpeg

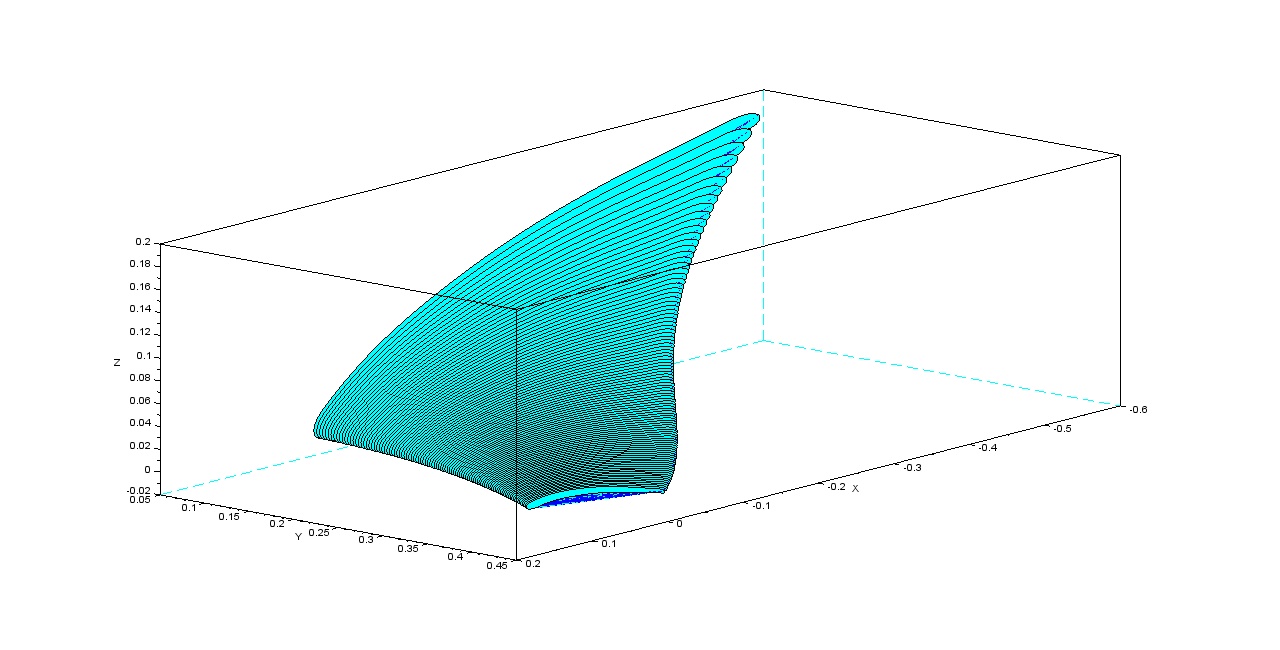
Polar_data/Hydrofoil_sweep_model.jpeg
