TobyBorland/HydroTurbineBlade/Polar_data/SD7037A.DRG.png

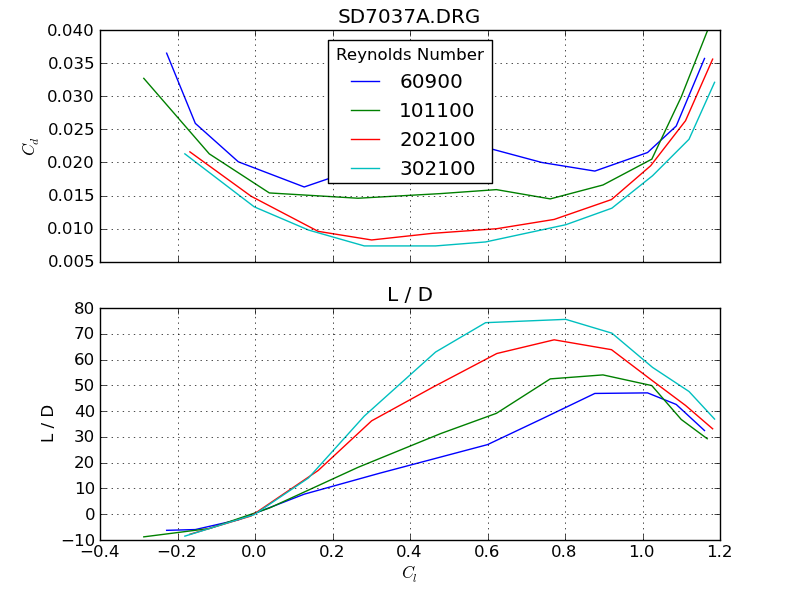
Polar_data/SD7037A.DRG.png
