TobyBorland/HydroTurbineBlade/Polar_data/SD7037A.LFT.png

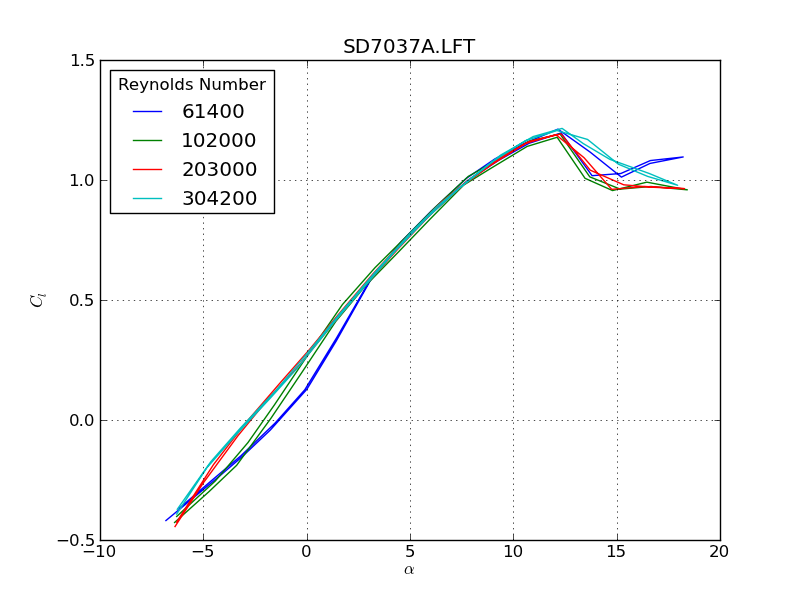
Polar_data/SD7037A.LFT.png
