TobyBorland/HydroTurbineBlade/Polar_data/SD7037B.DRG.png

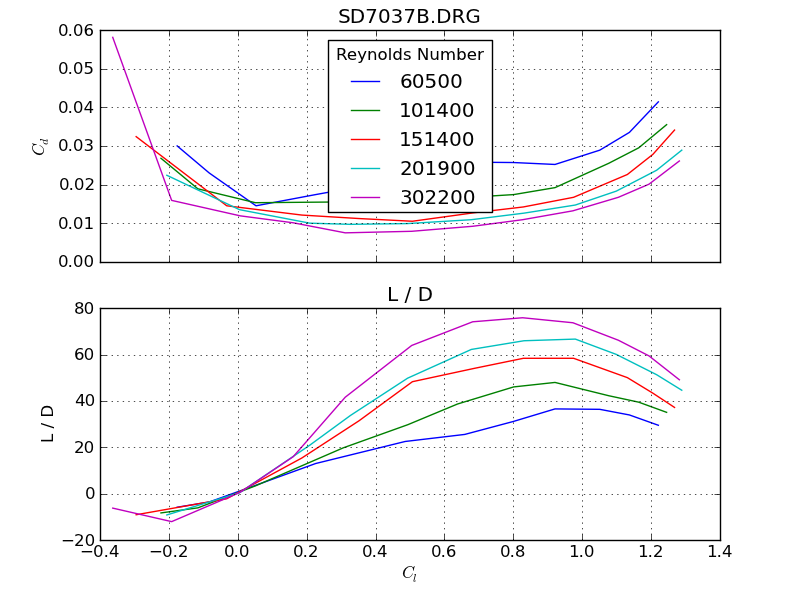
Polar_data/SD7037B.DRG.png
