TobyBorland/HydroTurbineBlade/Polar_data/SD7037B.LFT.png

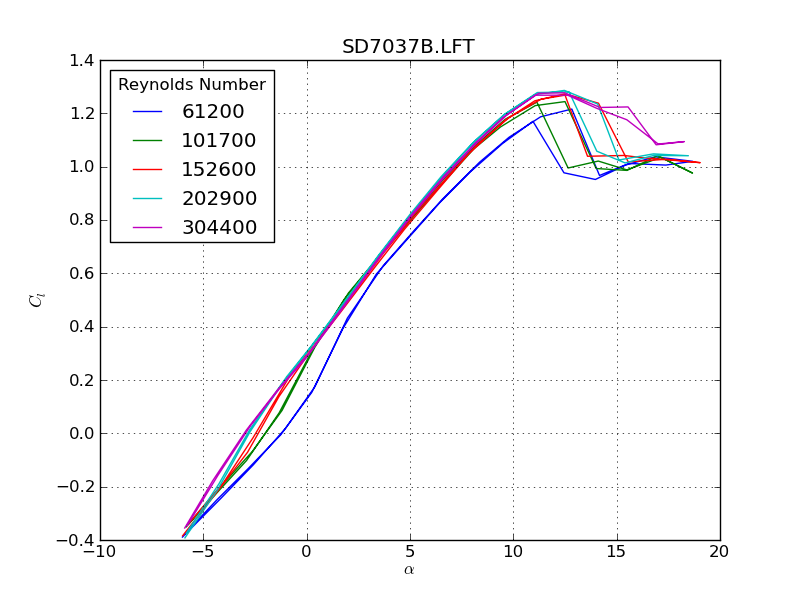
Polar_data/SD7037B.LFT.png
