TobyBorland/HydroTurbineBlade/SWKS_hydrofoil/MouldSlices/Slices_31_34.SLDASM

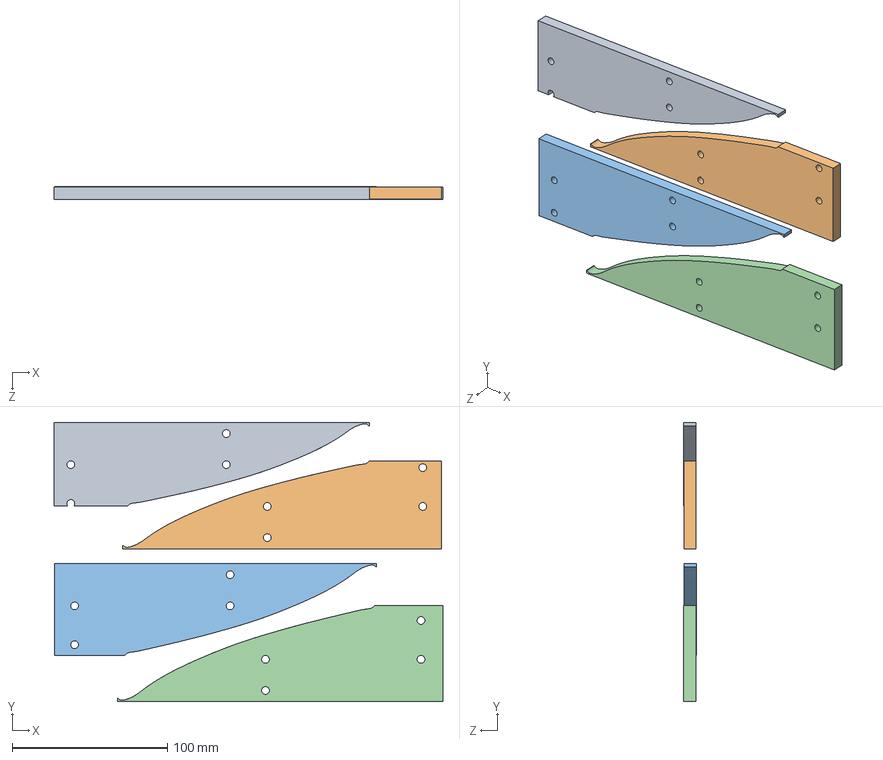
[picture p61: CAD file, 2024-08-06]
SWKS_hydrofoil/MouldSlices/Slices_31_34.SLDASM
250.3 x 179.8 x 8.36 mm
BCRW08_mouldlower-S31
BCRW08_mouldlower-S32
BCRW08_mouldlower-S33
BCRW08_mouldlower-S34
