TobyBorland/HydroTurbineBlade/SWKS_hydrofoil/HubSlices/Hub_17_20.SLDASM

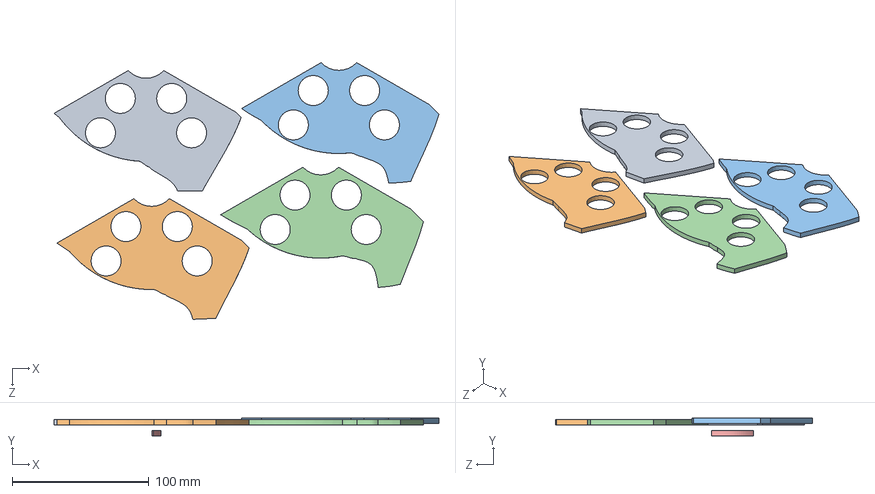
[picture p62: CAD file, 2024-08-06]
SWKS_hydrofoil/HubSlices/Hub_17_20.SLDASM
281.1 x 13.1 x 187.5 mm
BCRW09_hubCore04-H17
BCRW09_hubCore04-H18
BCRW09_hubCore04-H19
BCRW09_hubCore04-H20
BCRW09_hubCore04-H28B x 2
