TobyBorland/HydroTurbineBlade/SWKS_hydrofoil/HubSlices/Hub_21_24.SLDASM

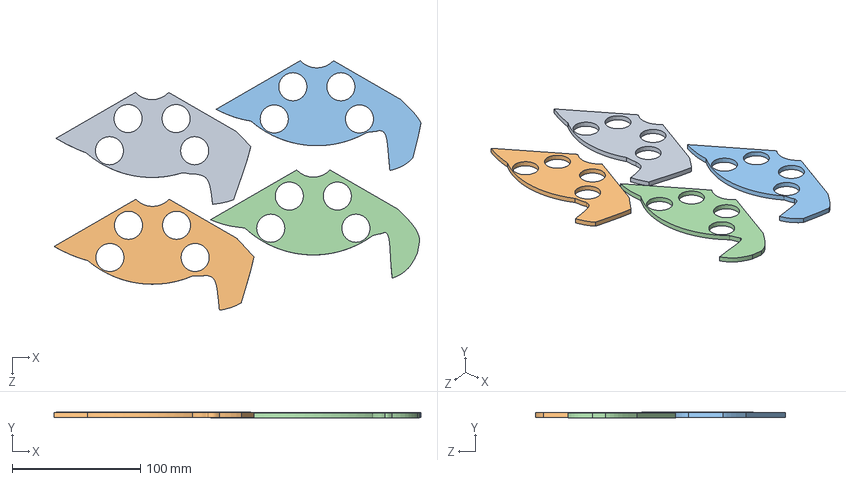
[picture p63: CAD file, 2024-08-06]
SWKS_hydrofoil/HubSlices/Hub_21_24.SLDASM
286.5 x 5.00 x 194.9 mm
BCRW09_hubCore04-H21
BCRW09_hubCore04-H22
BCRW09_hubCore04-H23
BCRW09_hubCore04-H24
