TobyBorland/HydroTurbineBlade/SWKS_hydrofoil/BladeSlices/Blade_48_51.SLDASM

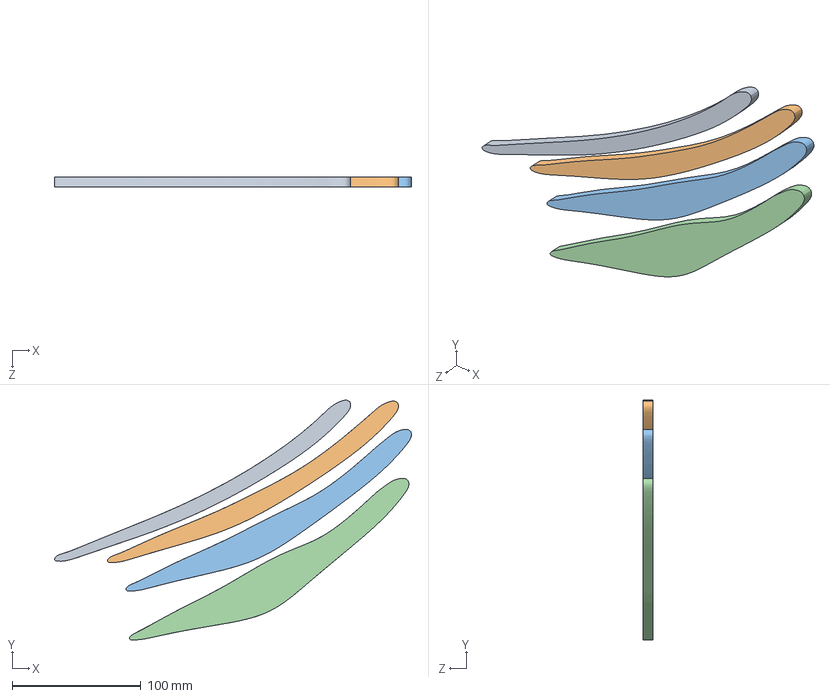
[picture p64: CAD file, 2024-08-06]
SWKS_hydrofoil/BladeSlices/Blade_48_51.SLDASM
277.2 x 186.2 x 8.03 mm
BCRW08_mouldlowerblade-H48
BCRW08_mouldlowerblade-H49
BCRW08_mouldlowerblade-H50
BCRW08_mouldlowerblade-H51
