TobyBorland/HydroTurbineBlade/SWKS_hydrofoil/HubSlices/Hub_5_8.SLDASM

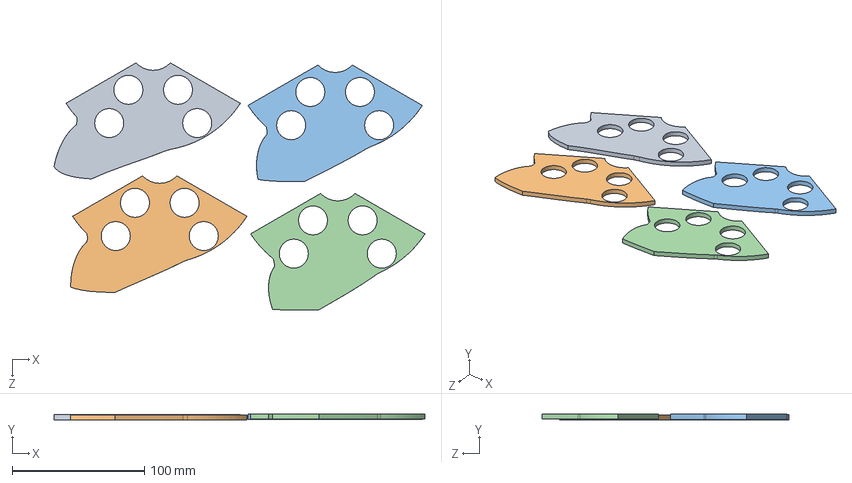
[picture p65: CAD file, 2024-08-06]
SWKS_hydrofoil/HubSlices/Hub_5_8.SLDASM
280.4 x 4.77 x 186.8 mm
BCRW09_hubCore04-H5
BCRW09_hubCore04-H6
BCRW09_hubCore04-H7
BCRW09_hubCore04-H8
