TobyBorland/HydroTurbineBlade/SWKS_hydrofoil/HubSlices/Hub_28_30.SLDASM

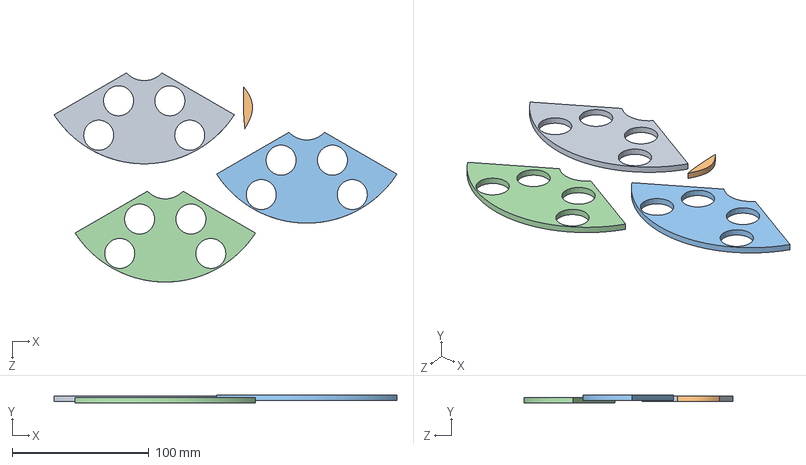
[picture p66: CAD file, 2024-08-06]
SWKS_hydrofoil/HubSlices/Hub_28_30.SLDASM
250.5 x 5.70 x 152.7 mm
BCRW09_hubCore04-H28A
BCRW09_hubCore04-H28B
BCRW09_hubCore04-H30
BCRW09_hubCore04-H29
