TobyBorland/HydroTurbineBlade/SWKS_hydrofoil/MouldSlices/Slices_39_42.SLDASM

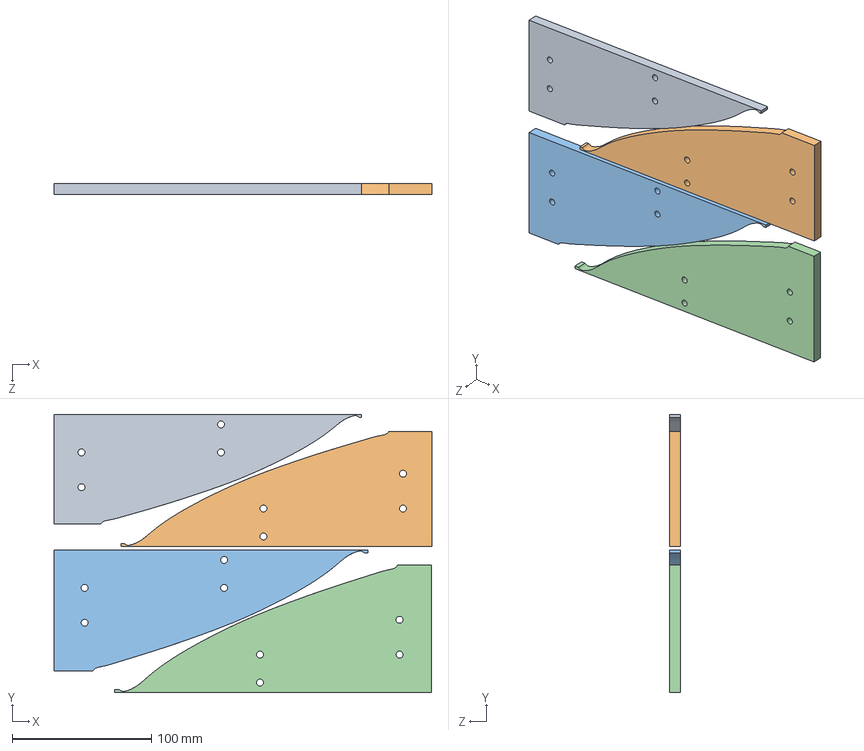
[picture p67: CAD file, 2024-08-06]
SWKS_hydrofoil/MouldSlices/Slices_39_42.SLDASM
271.1 x 199.6 x 8.20 mm
BCRW08_mouldlower-S39
BCRW08_mouldlower-S40
BCRW08_mouldlower-S41
BCRW08_mouldlower-S42
