TobyBorland/HydroTurbineBlade/SWKS_hydrofoil/BladeSlices/Blade_Group1.SLDASM

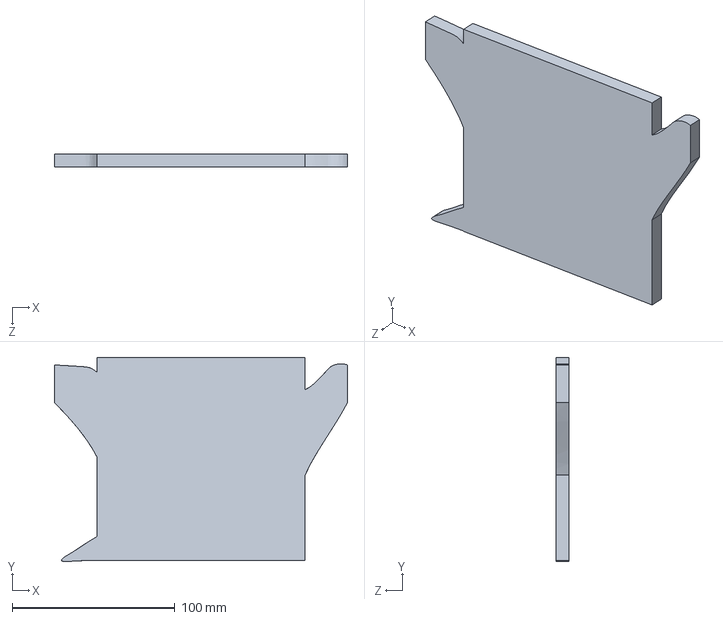
[picture p68: CAD file, 2024-08-06]
SWKS_hydrofoil/BladeSlices/Blade_Group1.SLDASM
180.1 x 125.5 x 8.00 mm
