TobyBorland/HydroTurbineBlade/SWKS_hydrofoil/MouldSlices/Slices_22_26.SLDASM

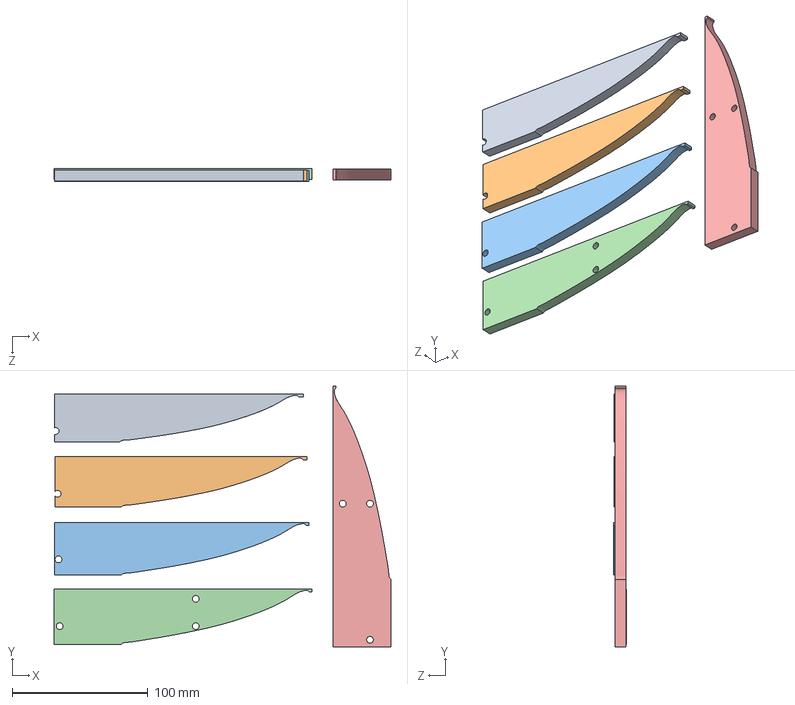
[picture p69: CAD file, 2024-08-06]
SWKS_hydrofoil/MouldSlices/Slices_22_26.SLDASM
247.8 x 191.8 x 9.33 mm
BCRW08_mouldlower-S22
BCRW08_mouldlower-S23
BCRW08_mouldlower-S24
BCRW08_mouldlower-S25
BCRW08_mouldlower-S26
