TobyBorland/HydroTurbineBlade/SWKS_hydrofoil/HubSlices/Hub_13_16.SLDASM

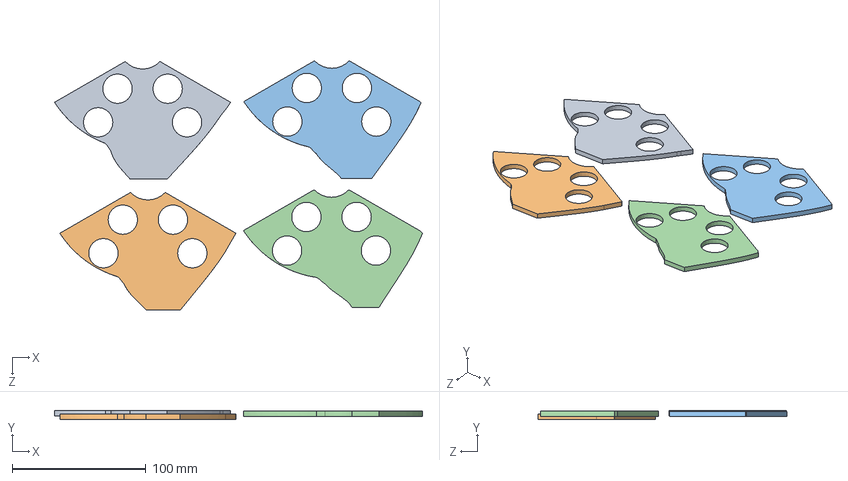
[picture p70: CAD file, 2024-08-06]
SWKS_hydrofoil/HubSlices/Hub_13_16.SLDASM
275.3 x 6.58 x 186.6 mm
BCRW09_hubCore04-H13
BCRW09_hubCore04-H14
BCRW09_hubCore04-H15
BCRW09_hubCore04-H16
