TobyBorland/HydroTurbineBlade/SWKS_hydrofoil/HubSlices/Hub_1_4.SLDASM

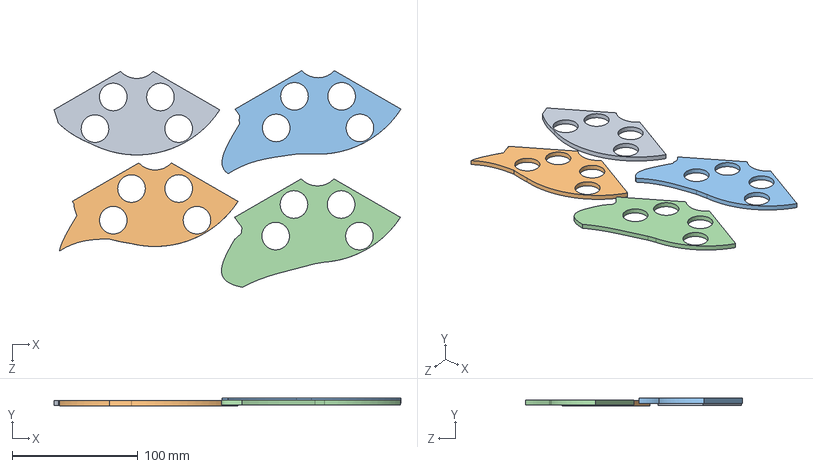
[picture p71: CAD file, 2024-08-06]
SWKS_hydrofoil/HubSlices/Hub_1_4.SLDASM
275.7 x 6.00 x 172.1 mm
BCRW09_hubCore04-H1
BCRW09_hubCore04-H2
BCRW09_hubCore04-H3
BCRW09_hubCore04-H4
