TobyBorland/HydroTurbineBlade/SWKS_hydrofoil/HubSlices/Hub_Group.SLDASM

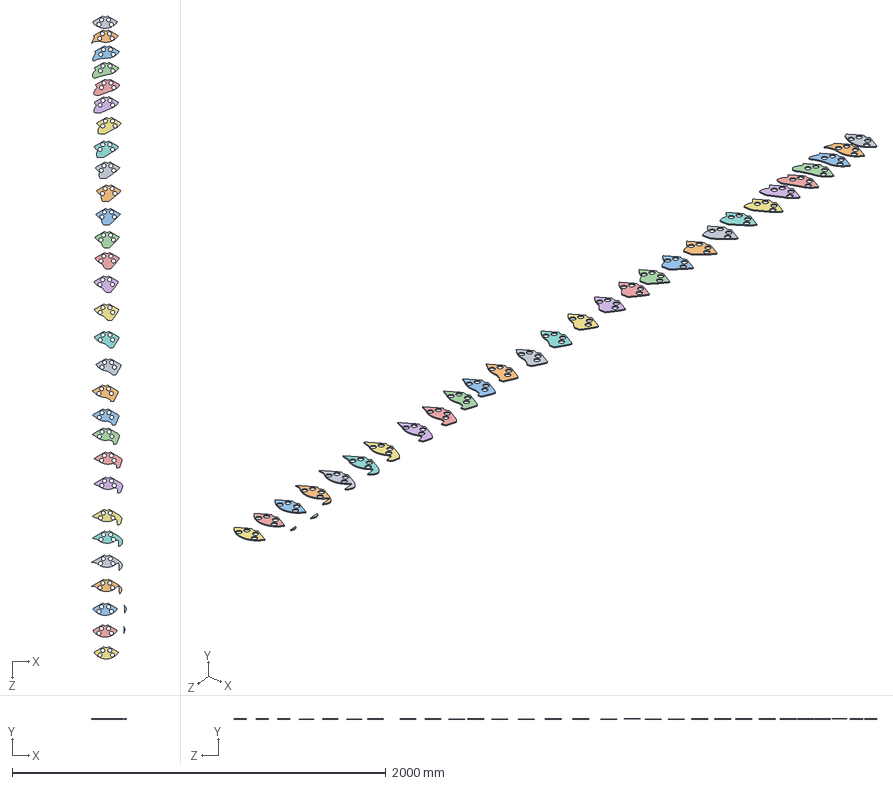
[picture p72: CAD file, 2024-08-06]
SWKS_hydrofoil/HubSlices/Hub_Group.SLDASM
185.8 x 7.31 x 3439.8 mm
BCRW09_hubCore04-H1
BCRW09_hubCore04-H2
BCRW09_hubCore04-H3
BCRW09_hubCore04-H4
BCRW09_hubCore04-H5
BCRW09_hubCore04-H6
BCRW09_hubCore04-H7
BCRW09_hubCore04-H8
BCRW09_hubCore04-H9
BCRW09_hubCore04-H10
BCRW09_hubCore04-H11
BCRW09_hubCore04-H12
BCRW09_hubCore04-H13
BCRW09_hubCore04-H14
BCRW09_hubCore04-H15
BCRW09_hubCore04-H16
BCRW09_hubCore04-H17
BCRW09_hubCore04-H18
BCRW09_hubCore04-H19
BCRW09_hubCore04-H20
BCRW09_hubCore04-H21
BCRW09_hubCore04-H22
BCRW09_hubCore04-H23
BCRW09_hubCore04-H24
BCRW09_hubCore04-H25
BCRW09_hubCore04-H26
BCRW09_hubCore04-H27A
BCRW09_hubCore04-H27B
BCRW09_hubCore04-H28A
BCRW09_hubCore04-H28B
BCRW09_hubCore04-H30
