TobyBorland/HydroTurbineBlade/SWKS_hydrofoil/MouldSlices/Slices_50_51.SLDASM

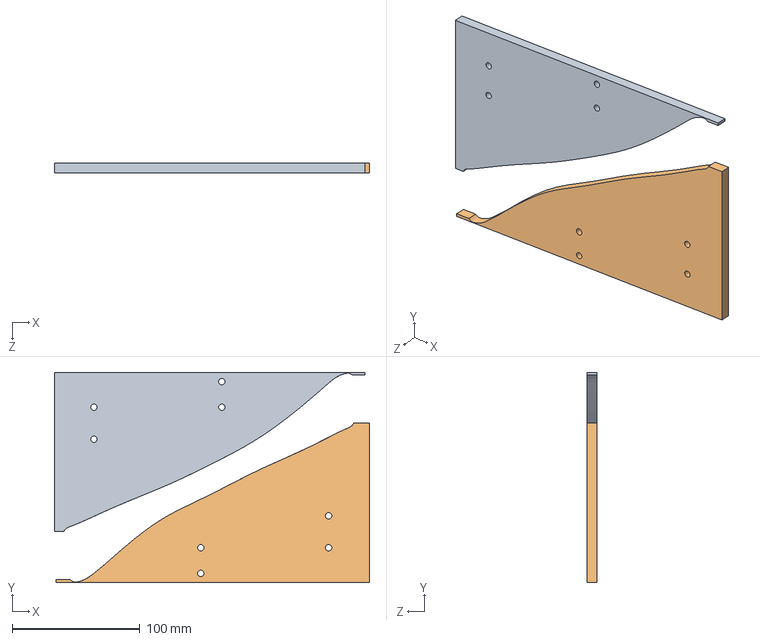
[picture p73: CAD file, 2024-08-06]
SWKS_hydrofoil/MouldSlices/Slices_50_51.SLDASM
246.5 x 164.4 x 8.00 mm
BCRW08_mouldlower-S50
BCRW08_mouldlower-S51
