TobyBorland/HydroTurbineBlade/SWKS_hydrofoil/MouldSlices/Slices_47_48.SLDASM

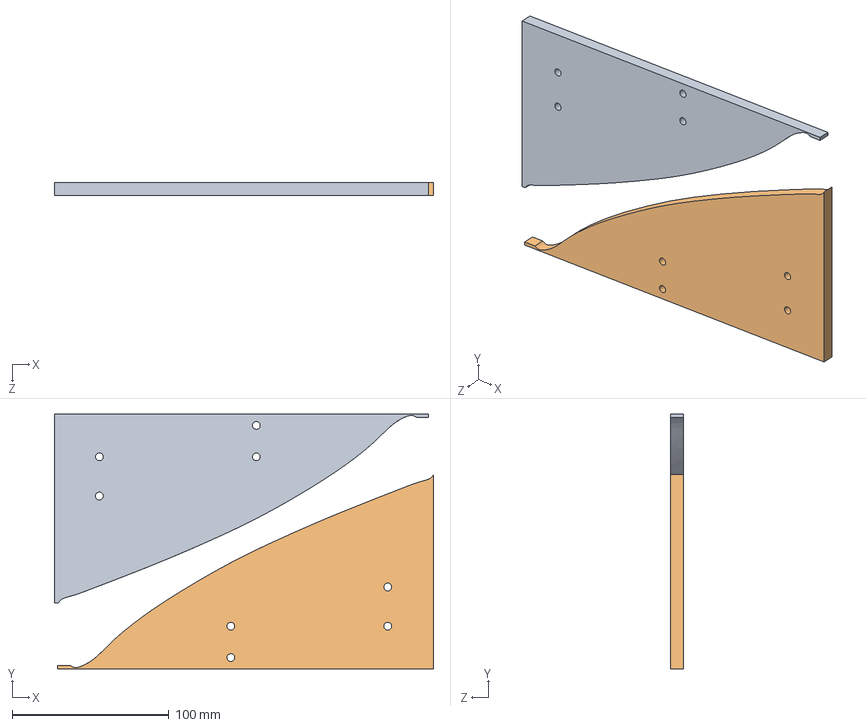
[picture p74: CAD file, 2024-08-06]
SWKS_hydrofoil/MouldSlices/Slices_47_48.SLDASM
241.7 x 162.5 x 8.00 mm
BCRW08_mouldlower-S47
BCRW08_mouldlower-S48
