TobyBorland/HydroTurbineBlade/SWKS_hydrofoil/MouldSlices/Slices_46_47.SLDASM

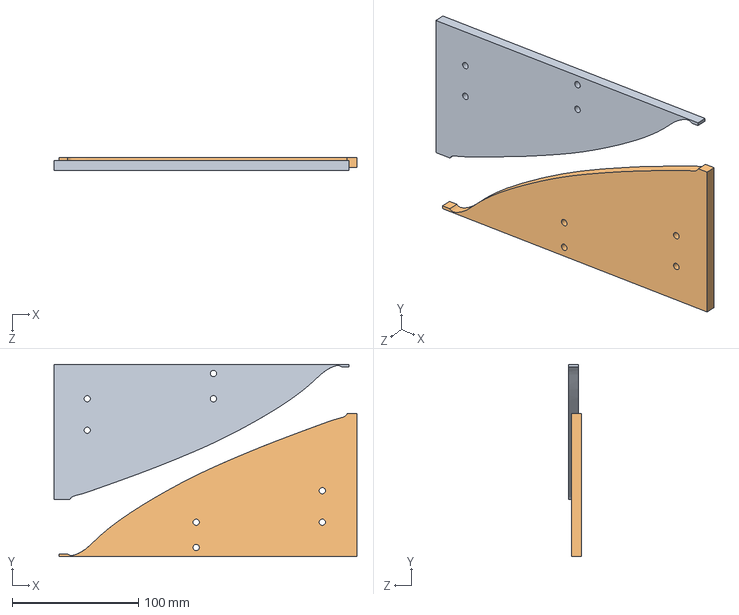
[picture p75: CAD file, 2024-08-06]
SWKS_hydrofoil/MouldSlices/Slices_46_47.SLDASM
240.4 x 152.5 x 10.3 mm
BCRW08_mouldlower-S45
BCRW08_mouldlower-S46
