TobyBorland/HydroTurbineBlade/SWKS_hydrofoil/HubSlices/Hub_9_12.SLDASM

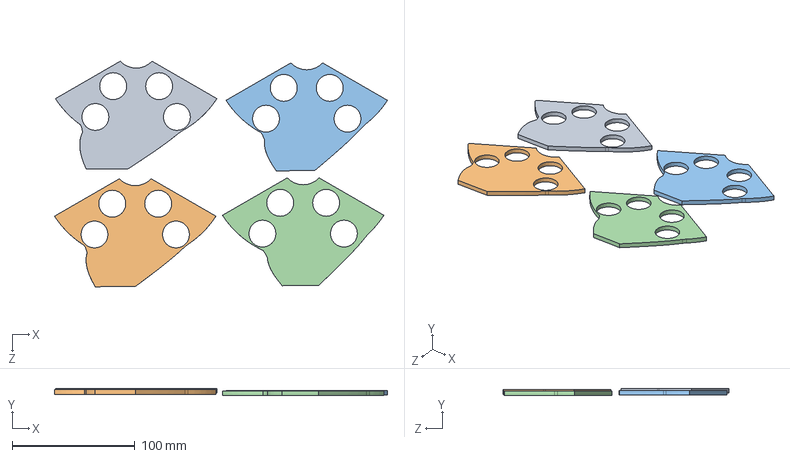
[picture p76: CAD file, 2024-08-06]
SWKS_hydrofoil/HubSlices/Hub_9_12.SLDASM
271.8 x 6.08 x 184.1 mm
BCRW09_hubCore04-H9
BCRW09_hubCore04-H10
BCRW09_hubCore04-H11
BCRW09_hubCore04-H12
