TobyBorland/HydroTurbineBlade/SWKS_hydrofoil/MouldSlices/Slices_35_38.SLDASM

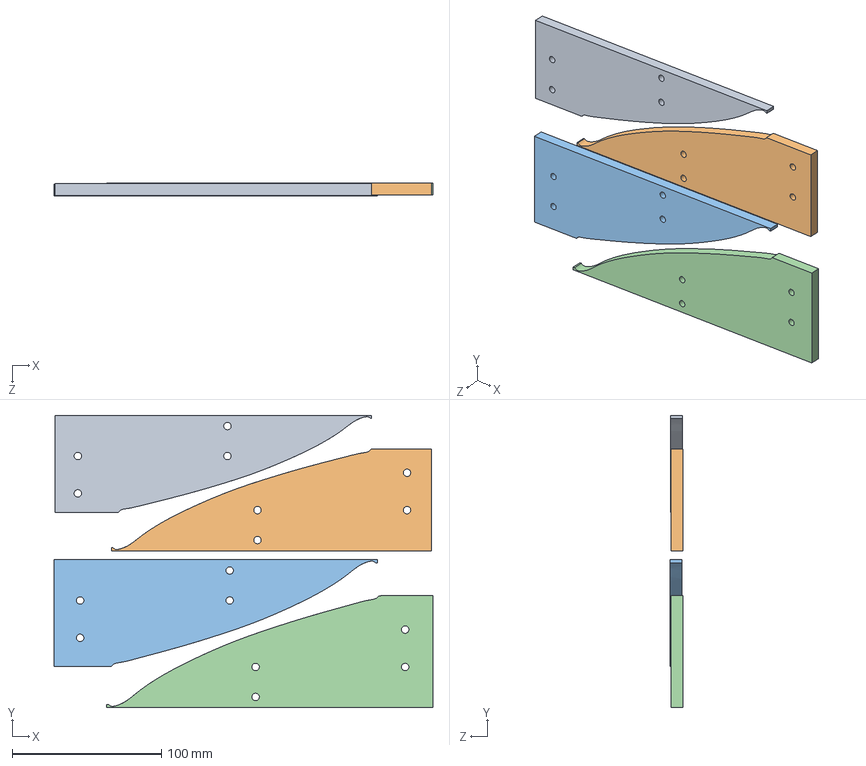
[picture p77: CAD file, 2024-08-06]
SWKS_hydrofoil/MouldSlices/Slices_35_38.SLDASM
253.6 x 195.6 x 8.58 mm
BCRW08_mouldlower-S35
BCRW08_mouldlower-S36
BCRW08_mouldlower-S37
BCRW08_mouldlower-S38
