TobyBorland/HydroTurbineBlade/SWKS_hydrofoil/HubSlices/Hub_25_27.SLDASM

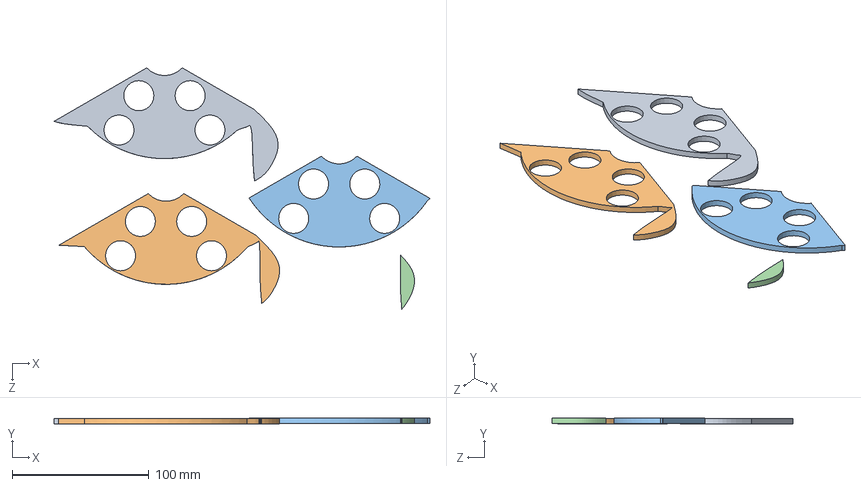
[picture p78: CAD file, 2024-08-06]
SWKS_hydrofoil/HubSlices/Hub_25_27.SLDASM
274.9 x 4.65 x 176.4 mm
BCRW09_hubCore04-H25
BCRW09_hubCore04-H26
BCRW09_hubCore04-H27A
BCRW09_hubCore04-H27B
