TobyBorland/HydroTurbineBlade/SWKS_hydrofoil/MouldSlices/Slices_15_21.SLDASM

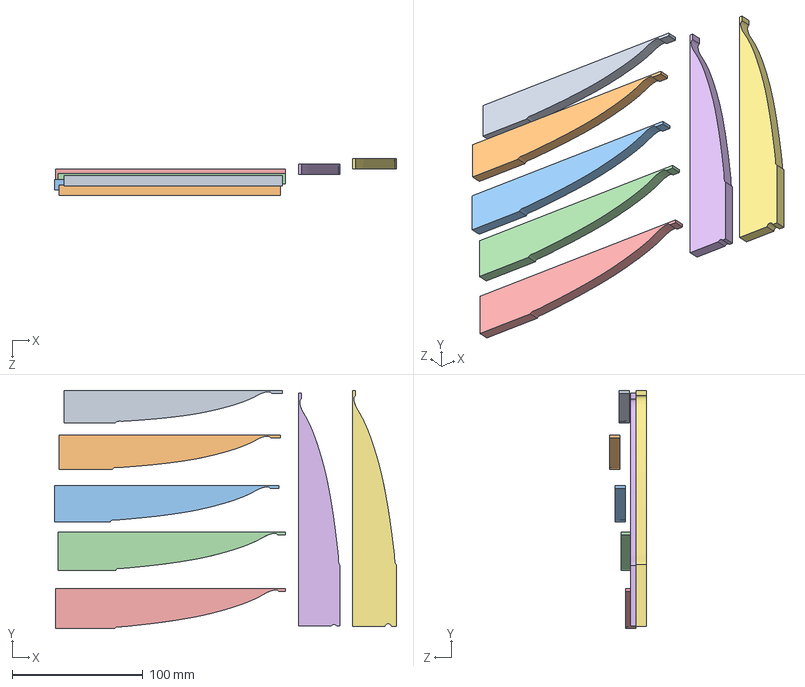
[picture p80: CAD file, 2024-08-06]
SWKS_hydrofoil/MouldSlices/Slices_15_21.SLDASM
261.9 x 182.3 x 28.0 mm
BCRW08_mouldlower-S15
BCRW08_mouldlower-S16
BCRW08_mouldlower-S17
BCRW08_mouldlower-S18
BCRW08_mouldlower-S19
BCRW08_mouldlower-S20
BCRW08_mouldlower-S21
