TobyBorland/HydroTurbineBlade/SWKS_hydrofoil/BladeSlices/Blade_52_53.SLDASM

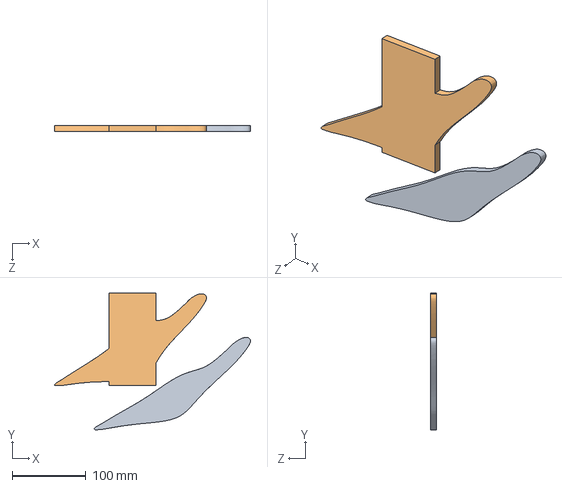
[picture p81: CAD file, 2024-08-06]
SWKS_hydrofoil/BladeSlices/Blade_52_53.SLDASM
265.7 x 185.1 x 8.07 mm
BCRW08_mouldlowerblade-H52
BCRW08_mouldlowerblade-H53
