TobyBorland/HydroTurbineBlade/SWKS_hydrofoil/BladeSlices/Blade_32_41.SLDASM

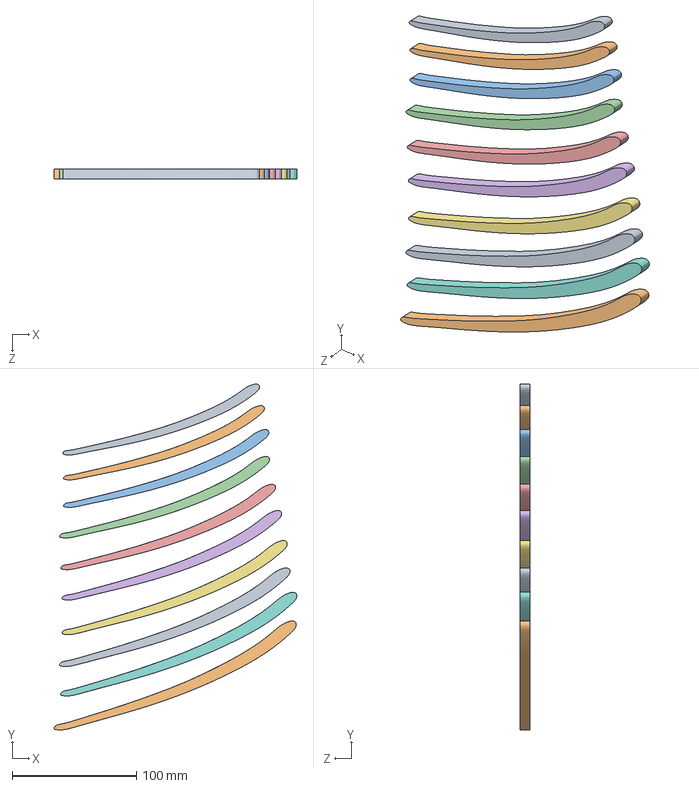
[picture p82: CAD file, 2024-08-06]
SWKS_hydrofoil/BladeSlices/Blade_32_41.SLDASM
195.3 x 278.2 x 8.13 mm
BCRW08_mouldlowerblade-H32
BCRW08_mouldlowerblade-H33
BCRW08_mouldlowerblade-H34
BCRW08_mouldlowerblade-H35
BCRW08_mouldlowerblade-H36
BCRW08_mouldlowerblade-H37
BCRW08_mouldlowerblade-H38
BCRW08_mouldlowerblade-H40
BCRW08_mouldlowerblade-H39
BCRW08_mouldlowerblade-H41
