TobyBorland/HydroTurbineBlade/SWKS_hydrofoil/BladeSlices/Blade_17_n.SLDASM

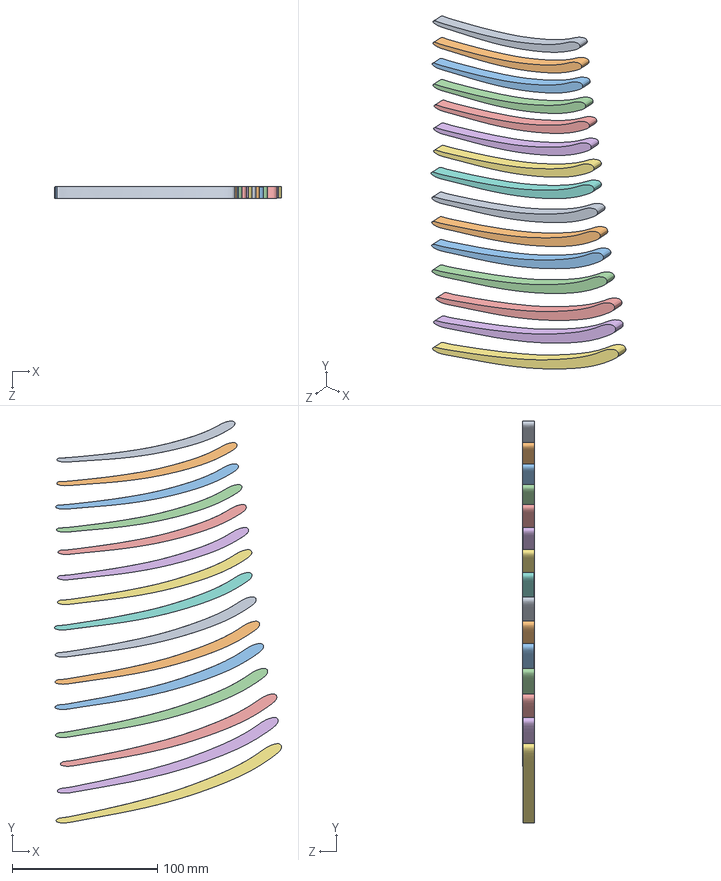
[picture p83: CAD file, 2024-08-06]
SWKS_hydrofoil/BladeSlices/Blade_17_n.SLDASM
156.1 x 276.3 x 8.12 mm
BCRW08_mouldlowerblade-H17
BCRW08_mouldlowerblade-H18
BCRW08_mouldlowerblade-H19
BCRW08_mouldlowerblade-H20
BCRW08_mouldlowerblade-H21
BCRW08_mouldlowerblade-H22
BCRW08_mouldlowerblade-H23
BCRW08_mouldlowerblade-H24
BCRW08_mouldlowerblade-H25
BCRW08_mouldlowerblade-H26
BCRW08_mouldlowerblade-H27
BCRW08_mouldlowerblade-H28
BCRW08_mouldlowerblade-H29
BCRW08_mouldlowerblade-H30
BCRW08_mouldlowerblade-H31
