TobyBorland/HydroTurbineBlade/SWKS_hydrofoil/MouldSlices/Slices_48_49.SLDASM

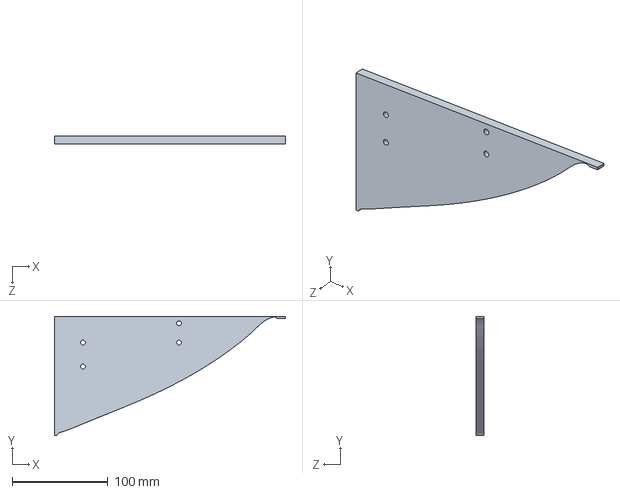
[picture p84: CAD file, 2024-08-06]
SWKS_hydrofoil/MouldSlices/Slices_48_49.SLDASM
240.7 x 124.3 x 8.00 mm
