TobyBorland/HydroTurbineBlade/SWKS_hydrofoil/BladeSlices/Blade_42_47.SLDASM

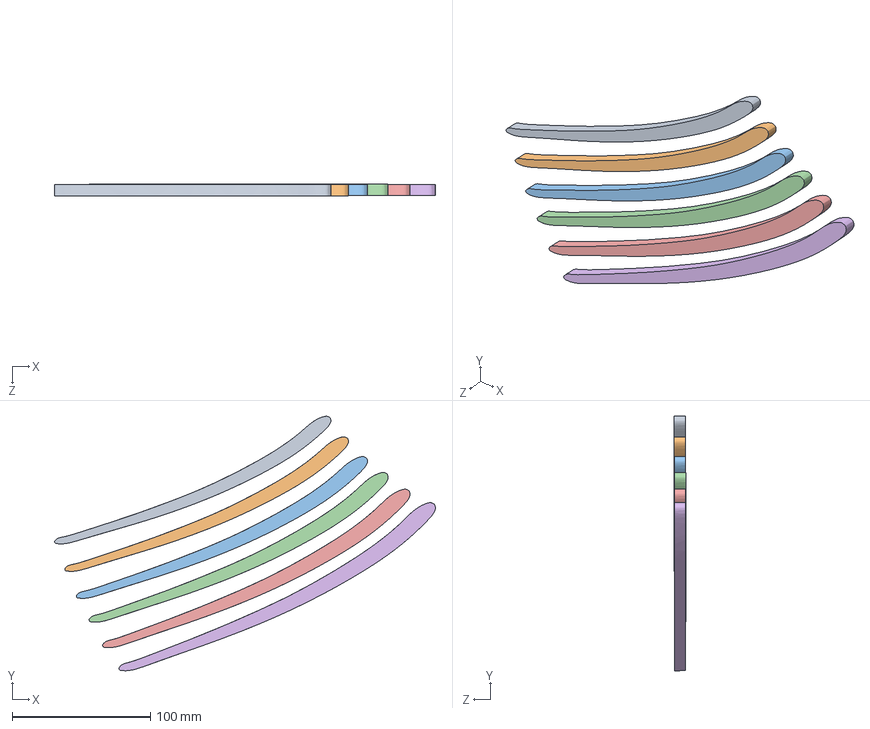
[picture p85: CAD file, 2024-08-06]
SWKS_hydrofoil/BladeSlices/Blade_42_47.SLDASM
275.3 x 184.0 x 8.41 mm
BCRW08_mouldlowerblade-H42
BCRW08_mouldlowerblade-H43
BCRW08_mouldlowerblade-H44
BCRW08_mouldlowerblade-H45
BCRW08_mouldlowerblade-H46
BCRW08_mouldlowerblade-H47
