TobyBorland/HydroTurbineBlade/SWKS_hydrofoil/BladeSlices/Blade_1_16.SLDASM

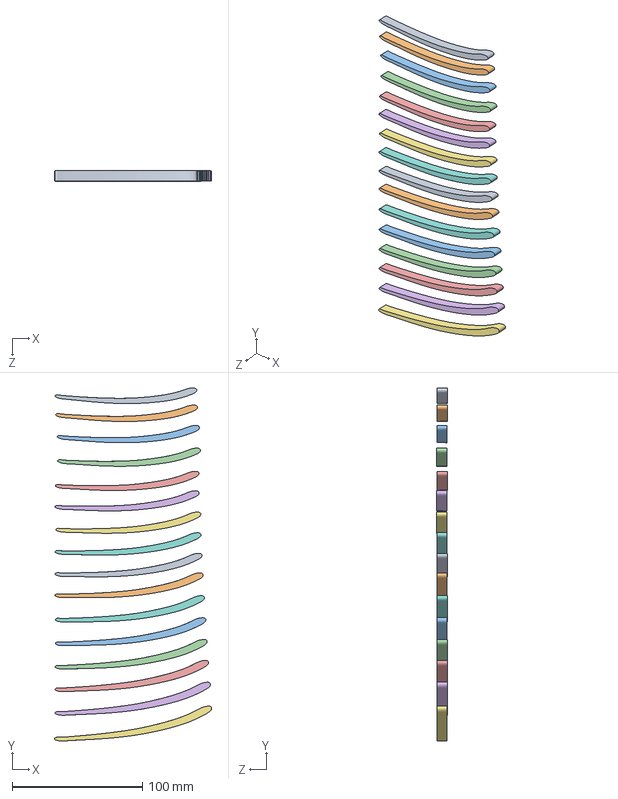
[picture p86: CAD file, 2024-08-06]
SWKS_hydrofoil/BladeSlices/Blade_1_16.SLDASM
120.8 x 271.3 x 8.20 mm
BCRW08_mouldlowerblade-H1
BCRW08_mouldlowerblade-H2
BCRW08_mouldlowerblade-H3
BCRW08_mouldlowerblade-H4
BCRW08_mouldlowerblade-H5
BCRW08_mouldlowerblade-H6
BCRW08_mouldlowerblade-H7
BCRW08_mouldlowerblade-H8
BCRW08_mouldlowerblade-H9
BCRW08_mouldlowerblade-H10
BCRW08_mouldlowerblade-H12
BCRW08_mouldlowerblade-H13
BCRW08_mouldlowerblade-H14
BCRW08_mouldlowerblade-H15
BCRW08_mouldlowerblade-H16
BCRW08_mouldlowerblade-H11
