TobyBorland/HydroTurbineBlade/SWKS_hydrofoil/MouldSlices/Slices_group1.SLDASM

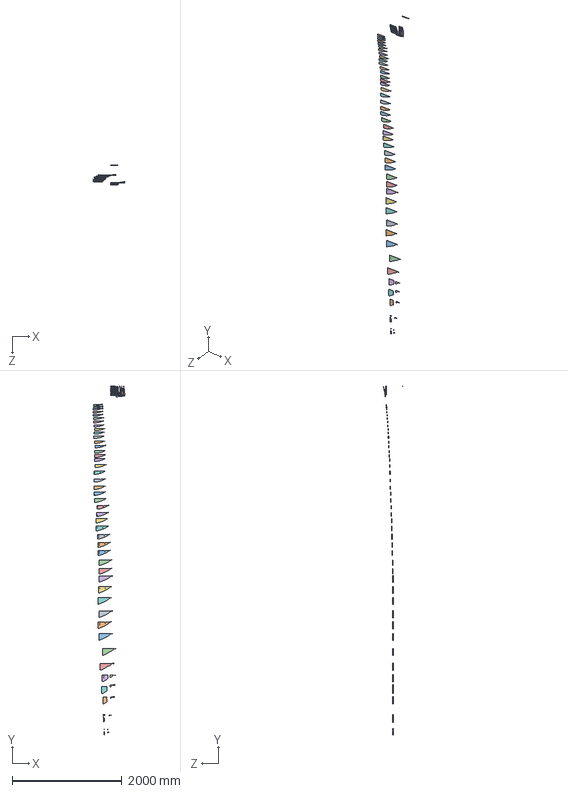
[picture p87: CAD file, 2024-08-06]
SWKS_hydrofoil/MouldSlices/Slices_group1.SLDASM
580.4 x 6366.6 x 356.7 mm
BCRW08_mouldlower-S1
BCRW08_mouldlower-S2
BCRW08_mouldlower-S3
BCRW08_mouldlower-S4
BCRW08_mouldlower-S5
BCRW08_mouldlower-S6
BCRW08_mouldlower-S7
BCRW08_mouldlower-S8
BCRW08_mouldlower-S9
BCRW08_mouldlower-S10
BCRW08_mouldlower-S11
BCRW08_mouldlower-S12
BCRW08_mouldlower-S13
BCRW08_mouldlower-S14
BCRW08_mouldlower-S15
BCRW08_mouldlower-S16
BCRW08_mouldlower-S17
BCRW08_mouldlower-S18
BCRW08_mouldlower-S19
BCRW08_mouldlower-S20
BCRW08_mouldlower-S21
BCRW08_mouldlower-S22
BCRW08_mouldlower-S23
BCRW08_mouldlower-S24
BCRW08_mouldlower-S25
BCRW08_mouldlower-S26
BCRW08_mouldlower-S27
BCRW08_mouldlower-S28
BCRW08_mouldlower-S29
BCRW08_mouldlower-S30
BCRW08_mouldlower-S31
BCRW08_mouldlower-S32
BCRW08_mouldlower-S33
BCRW08_mouldlower-S34
BCRW08_mouldlower-S35
BCRW08_mouldlower-S36
BCRW08_mouldlower-S37
BCRW08_mouldlower-S38
BCRW08_mouldlower-S39
BCRW08_mouldlower-S40
BCRW08_mouldlower-S41
BCRW08_mouldlower-S42
BCRW08_mouldlower-S43
BCRW08_mouldlower-S44
BCRW08_mouldlower-S45
BCRW08_mouldlower-S46
BCRW08_mouldlower-S47
BCRW08_mouldlower-S48
BCRW08_mouldlower-S49
BCRW08_mouldlower-S50
BCRW08_mouldlower-S51
BCRW08_mouldlower-S52
BCRW08_mouldlower-S53
BCRW08_mouldlower-S54P
BCRW08_mouldlower-S54S
BCRW08_mouldlower-S55P
BCRW08_mouldlower-S55S
BCRW08_mouldlower-S56P
BCRW08_mouldlower-S56S
BCRW08_mouldlower-S57LP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
