TobyBorland/HydroTurbineBlade/SWKS_hydrofoil/BladeSlices/Blade_55.SLDASM

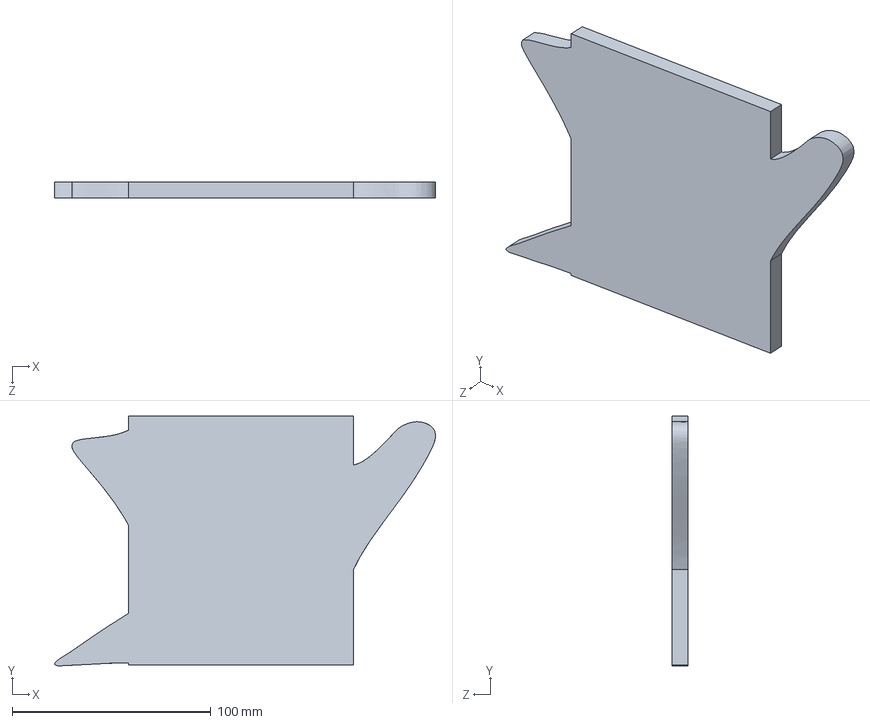
[picture p88: CAD file, 2024-08-06]
SWKS_hydrofoil/BladeSlices/Blade_55.SLDASM
191.5 x 125.5 x 8.00 mm
