TobyBorland/HydroTurbineBlade/SWKS_hydrofoil/MouldSlices/Slices_27_30.SLDASM

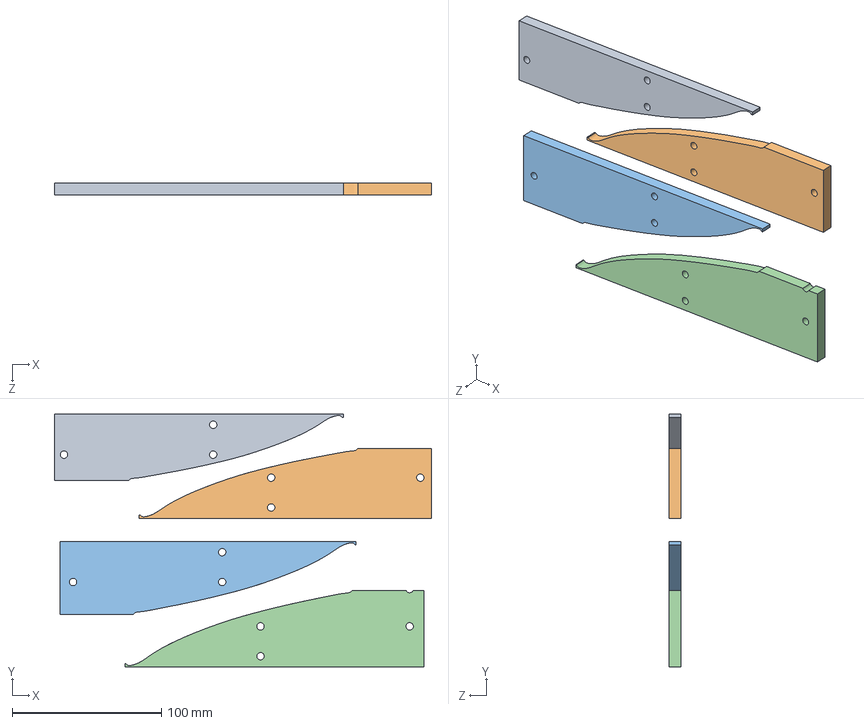
[picture p89: CAD file, 2024-08-06]
SWKS_hydrofoil/MouldSlices/Slices_27_30.SLDASM
252.9 x 169.7 x 8.23 mm
BCRW08_mouldlower-S27
BCRW08_mouldlower-S28
BCRW08_mouldlower-S29
BCRW08_mouldlower-S30
