TobyBorland/HydroTurbineBlade/SWKS_hydrofoil/MouldSlices/Slices_54_54.SLDASM

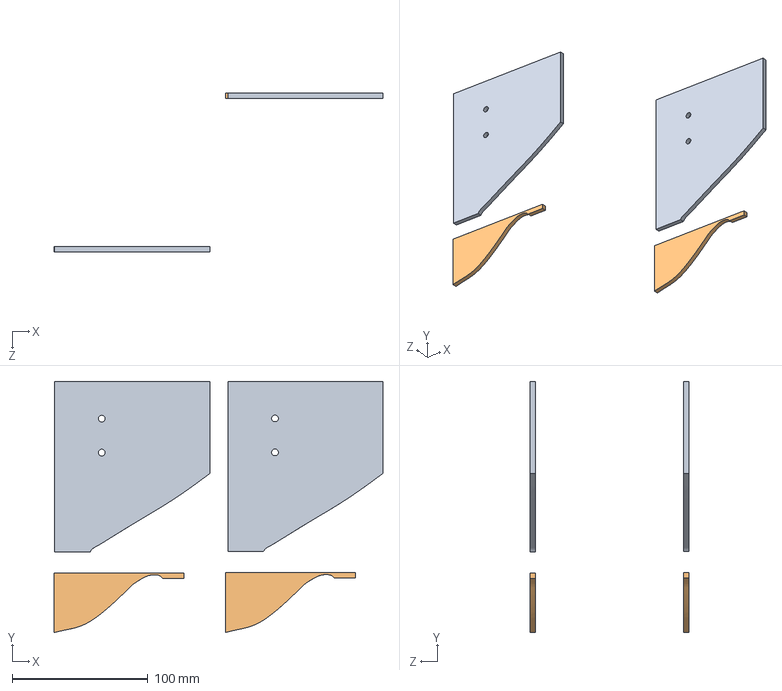
[picture p90: CAD file, 2024-08-06]
SWKS_hydrofoil/MouldSlices/Slices_54_54.SLDASM
242.0 x 184.9 x 117.0 mm
BCRW08_mouldlower-S54P x 2
BCRW08_mouldlower-S54S x 2
