TobyBorland/HydroTurbineBlade/SWKS_hydrofoil/MouldSlices/Slices_52_53.SLDASM

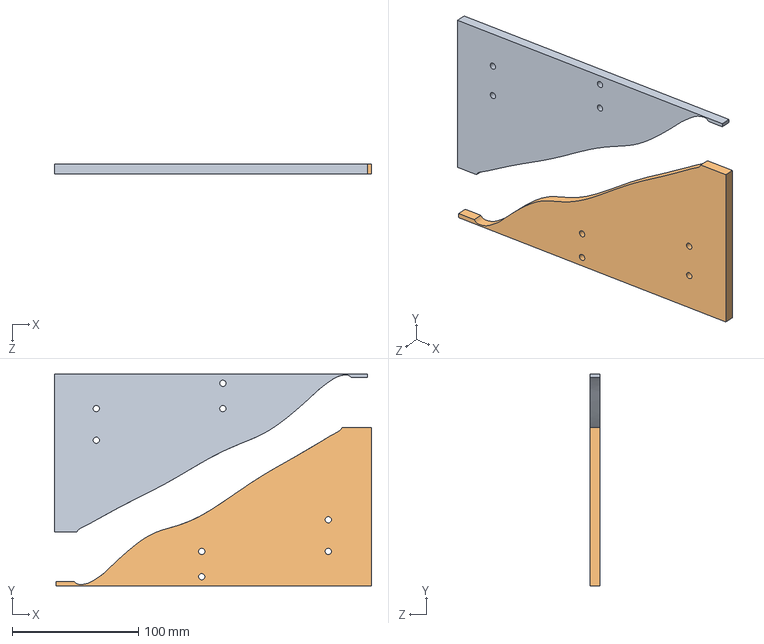
[picture p91: CAD file, 2024-08-06]
SWKS_hydrofoil/MouldSlices/Slices_52_53.SLDASM
250.7 x 167.4 x 8.00 mm
BCRW08_mouldlower-S52
BCRW08_mouldlower-S53
