TobyBorland/HydroTurbineBlade/SWKS_hydrofoil/MouldSlices/Slices_56_59.SLDASM

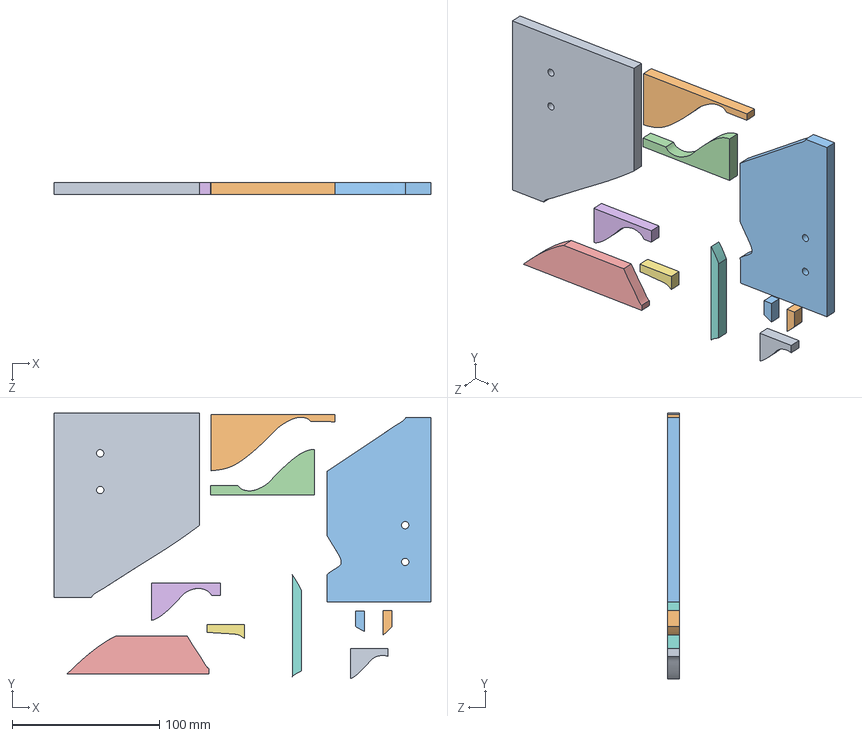
[picture p92: CAD file, 2024-08-06]
SWKS_hydrofoil/MouldSlices/Slices_56_59.SLDASM
256.4 x 180.7 x 8.00 mm
BCRW08_mouldlower-S55P
BCRW08_mouldlower-S55S
BCRW08_mouldlower-S56P
BCRW08_mouldlower-S56S
BCRW08_mouldlower-S57LP
BCRW08_mouldlower-S57S
BCRW08_mouldlower-S57UP
BCRW08_mouldlower-S58LP
BCRW08_mouldlower-S58S
BCRW08_mouldlower-S58US
BCRW08_mouldlower-S58UP
