TobyBorland/HydroTurbineBlade/SWKS_hydrofoil/MouldSlices/Slices_43_44.SLDASM

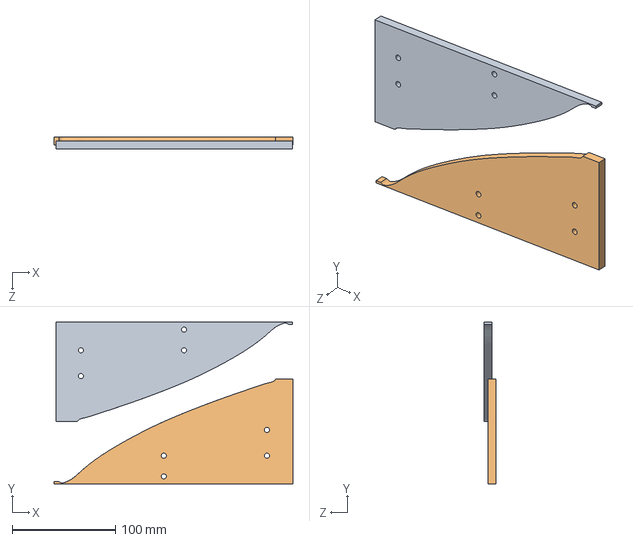
[picture p93: CAD file, 2024-08-06]
SWKS_hydrofoil/MouldSlices/Slices_43_44.SLDASM
231.8 x 156.8 x 12.0 mm
BCRW08_mouldlower-S43
BCRW08_mouldlower-S44
