TobyBorland/HydroTurbineBlade/SWKS_hydrofoil/MouldSlices/Slices_1_14.SLDASM

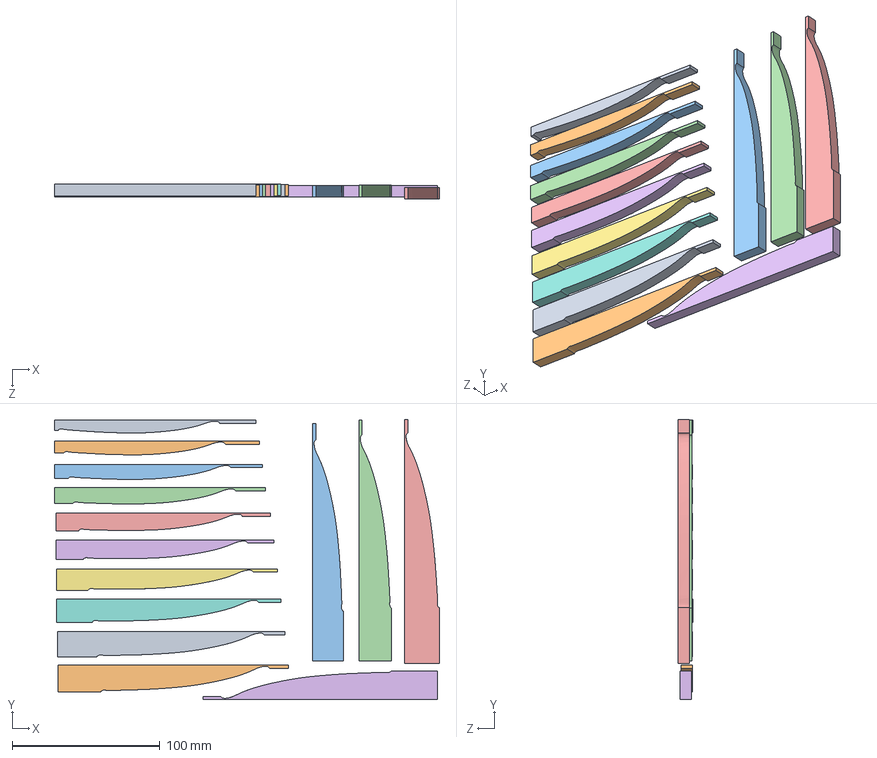
[picture p94: CAD file, 2024-08-06]
SWKS_hydrofoil/MouldSlices/Slices_1_14.SLDASM
260.5 x 189.8 x 10.3 mm
BCRW08_mouldlower-S1
BCRW08_mouldlower-S2
BCRW08_mouldlower-S3
BCRW08_mouldlower-S4
BCRW08_mouldlower-S5
BCRW08_mouldlower-S6
BCRW08_mouldlower-S7
BCRW08_mouldlower-S8
BCRW08_mouldlower-S9
BCRW08_mouldlower-S10
BCRW08_mouldlower-S12
BCRW08_mouldlower-S13
BCRW08_mouldlower-S14
BCRW08_mouldlower-S11
