TobyBorland/HydroTurbineBlade/SWKS_hydrofoil/6_hole_flange.dxf

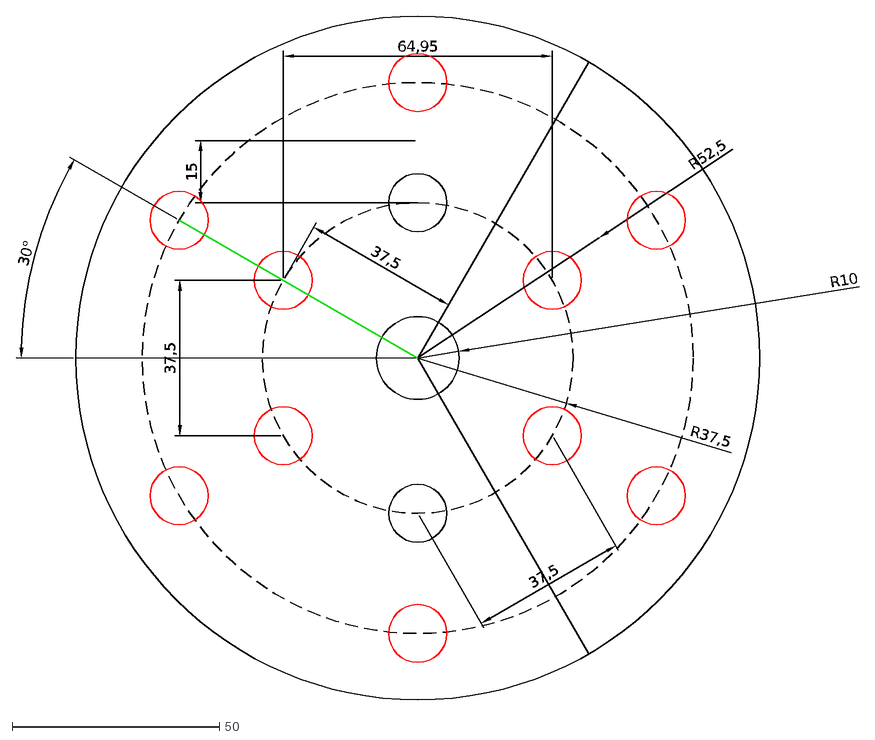
[picture p95: CAD file, 2024-08-06]
SWKS_hydrofoil/6_hole_flange.dxf
37,5
64,95
15
R52,5
R37,5
R10
30°
