TobyBorland/HydroTurbineBlade/SWKS_hydrofoil/BladeSlices/BCRW08_mouldlowerblade-H34.SLDPRT

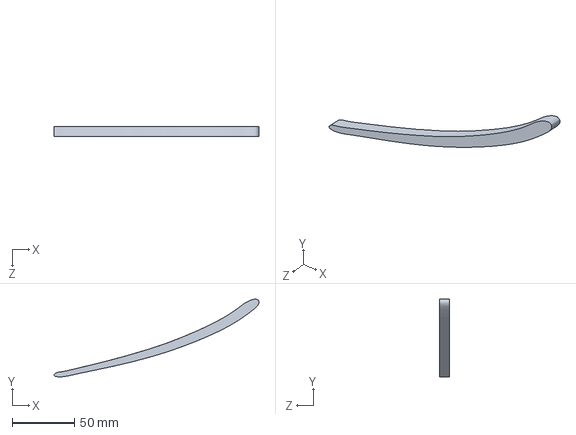
[picture p96: CAD file, 2024-08-06]
SWKS_hydrofoil/BladeSlices/BCRW08_mouldlowerblade-H34.SLDPRT
165.2 x 62.7 x 8.00 mm
