TobyBorland/HydroTurbineBlade/SWKS_hydrofoil/HubSlices/BCRW09_hubCore04-H6.SLDPRT

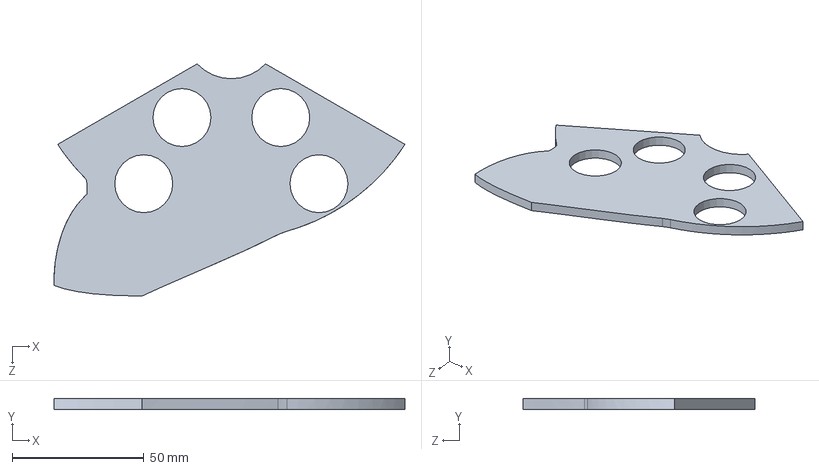
[picture p97: CAD file, 2024-08-06]
SWKS_hydrofoil/HubSlices/BCRW09_hubCore04-H6.SLDPRT
133.2 x 4.00 x 88.1 mm
