TobyBorland/HydroTurbineBlade/SWKS_hydrofoil/MouldSlices/BCRW08_mouldlower-S41.SLDPRT

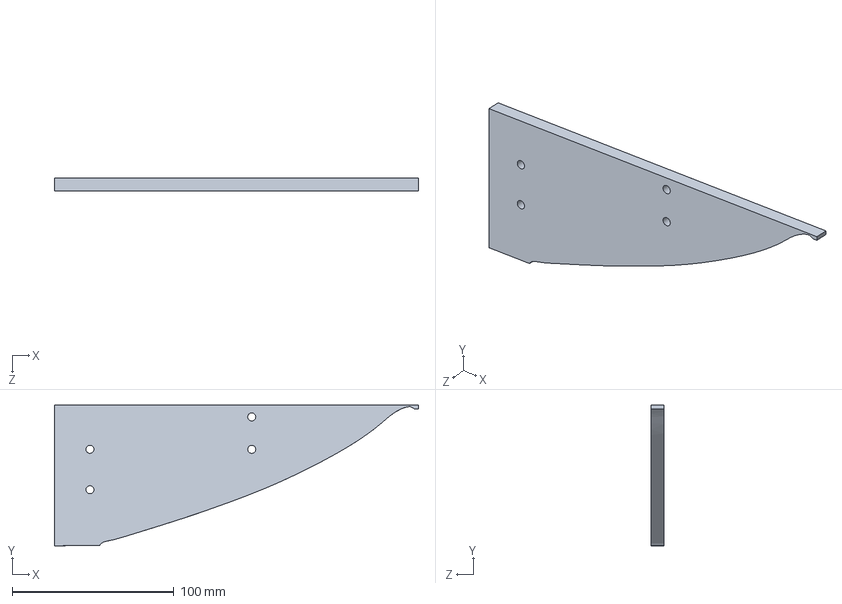
[picture p98: CAD file, 2024-08-06]
SWKS_hydrofoil/MouldSlices/BCRW08_mouldlower-S41.SLDPRT
225.2 x 86.9 x 8.00 mm
