TobyBorland/HydroTurbineBlade/SWKS_hydrofoil/Blade_i00.sldprt

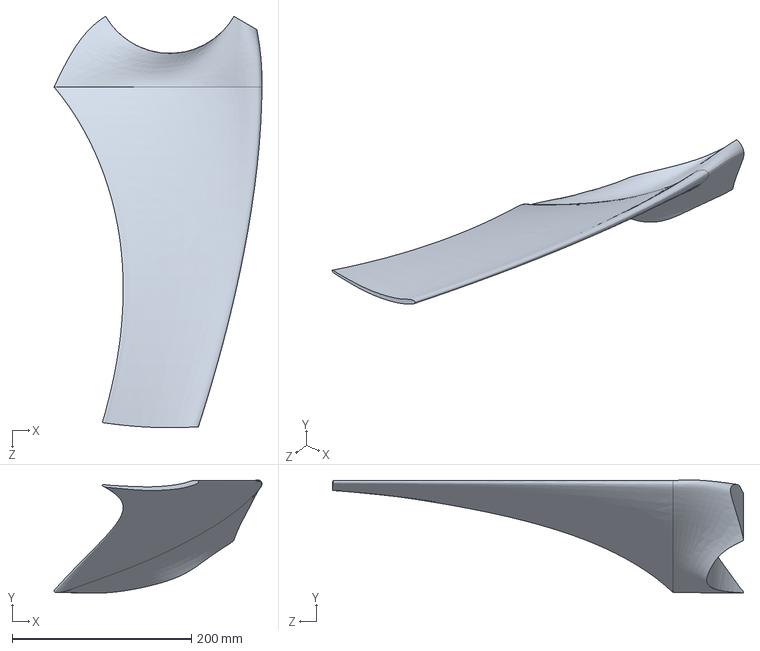
[picture p99: CAD file, 2024-08-06]
SWKS_hydrofoil/Blade_i00.sldprt
232.0 x 126.0 x 458.8 mm
