TobyBorland/HydroTurbineBlade/SWKS_hydrofoil/BladeSlices/BCRW08_mouldlowerblade-H7.SLDPRT

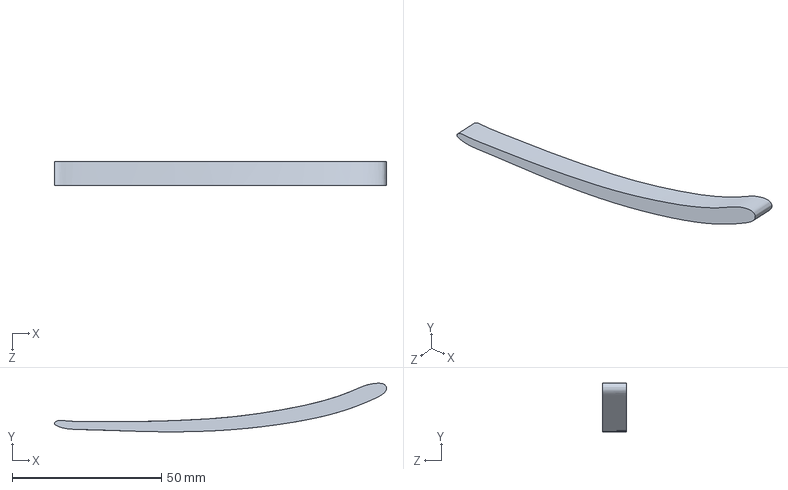
[picture p100: CAD file, 2024-08-06]
SWKS_hydrofoil/BladeSlices/BCRW08_mouldlowerblade-H7.SLDPRT
111.4 x 16.3 x 8.00 mm
