TobyBorland/HydroTurbineBlade/SWKS_hydrofoil/HubSlices/BCRW09_hubCore04-H25.SLDPRT

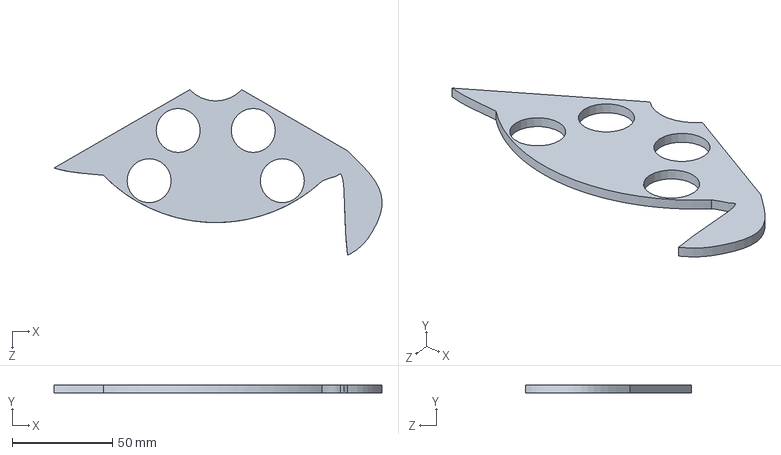
[picture p101: CAD file, 2024-08-06]
SWKS_hydrofoil/HubSlices/BCRW09_hubCore04-H25.SLDPRT
163.8 x 4.00 x 82.7 mm
