TobyBorland/HydroTurbineBlade/SWKS_hydrofoil/MouldSlices/BCRW08_mouldlower-S58US.SLDPRT

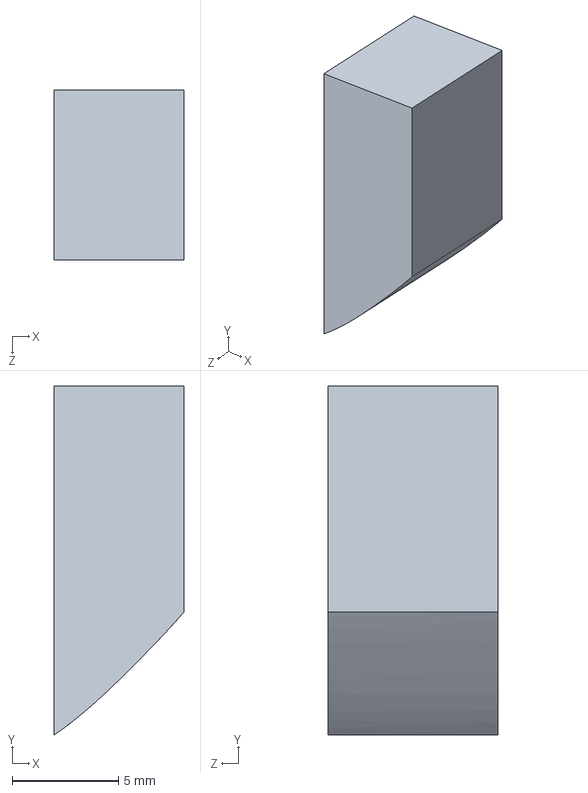
[picture p102: CAD file, 2024-08-06]
SWKS_hydrofoil/MouldSlices/BCRW08_mouldlower-S58US.SLDPRT
6.11 x 16.4 x 8.00 mm
