TobyBorland/HydroTurbineBlade/SWKS_hydrofoil/BladeSlices/BCRW08_mouldlowerblade-H16.SLDPRT

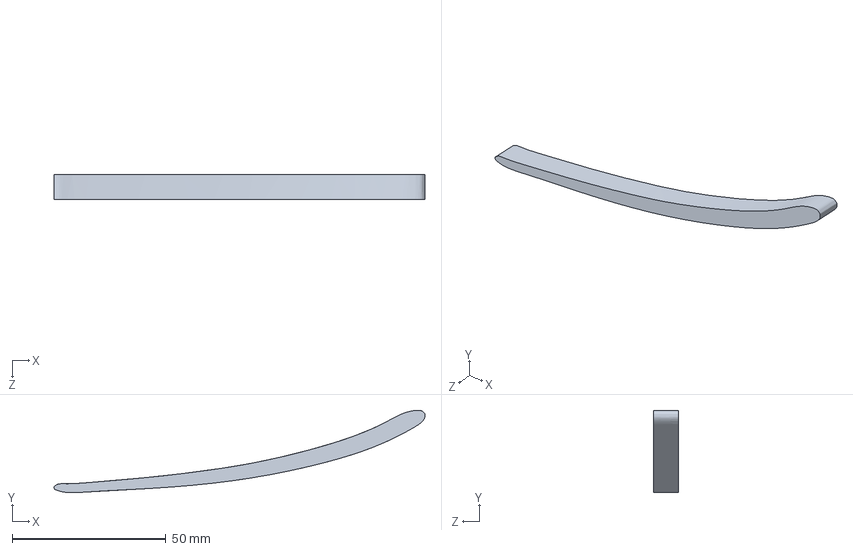
[picture p103: CAD file, 2024-08-06]
SWKS_hydrofoil/BladeSlices/BCRW08_mouldlowerblade-H16.SLDPRT
120.8 x 26.8 x 8.00 mm
