TobyBorland/HydroTurbineBlade/SWKS_hydrofoil/HubSlices/BCRW09_hubCore04-H19.SLDPRT

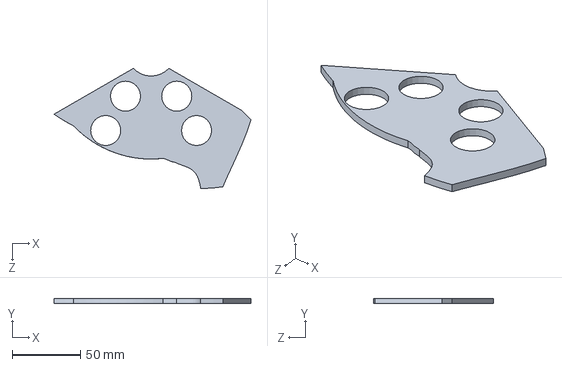
[picture p104: CAD file, 2024-08-06]
SWKS_hydrofoil/HubSlices/BCRW09_hubCore04-H19.SLDPRT
144.2 x 4.00 x 88.0 mm
