TobyBorland/HydroTurbineBlade/SWKS_hydrofoil/BCRW08_mouldlowerblade-hubface2.SLDPRT

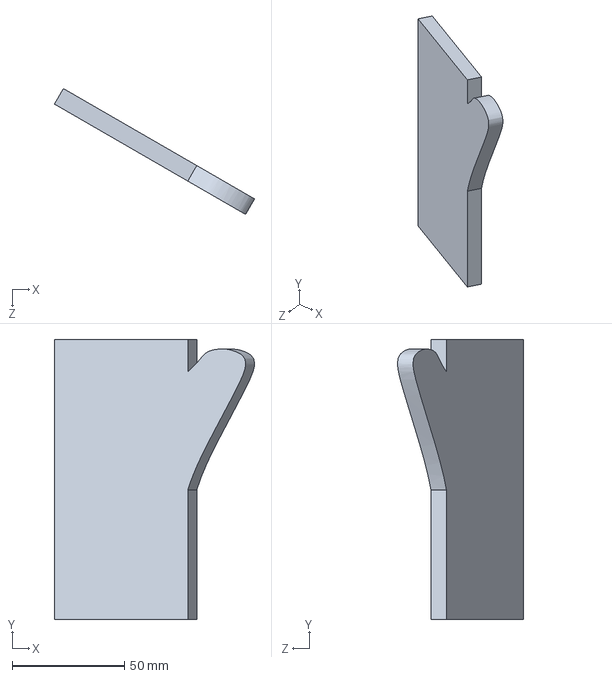
[picture p105: CAD file, 2024-08-06]
SWKS_hydrofoil/BCRW08_mouldlowerblade-hubface2.SLDPRT
89.4 x 125.0 x 56.2 mm
