TobyBorland/HydroTurbineBlade/SWKS_hydrofoil/BladeSlices/BCRW08_mouldlowerblade-H24.SLDPRT

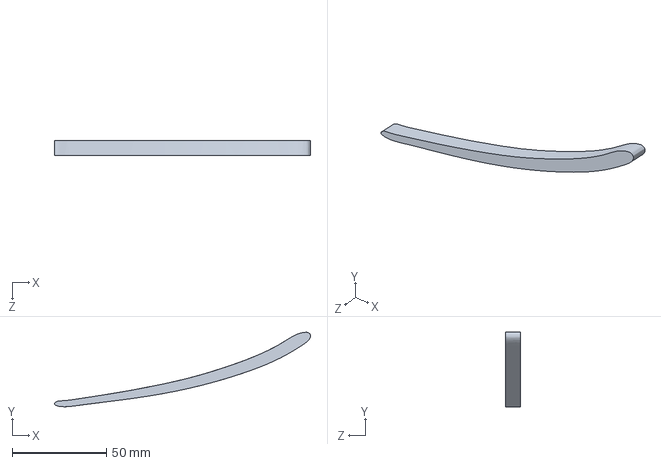
[picture p106: CAD file, 2024-08-06]
SWKS_hydrofoil/BladeSlices/BCRW08_mouldlowerblade-H24.SLDPRT
135.8 x 39.6 x 8.00 mm
