TobyBorland/HydroTurbineBlade/SWKS_hydrofoil/MouldSlices/BCRW08_mouldlower-S6.SLDPRT

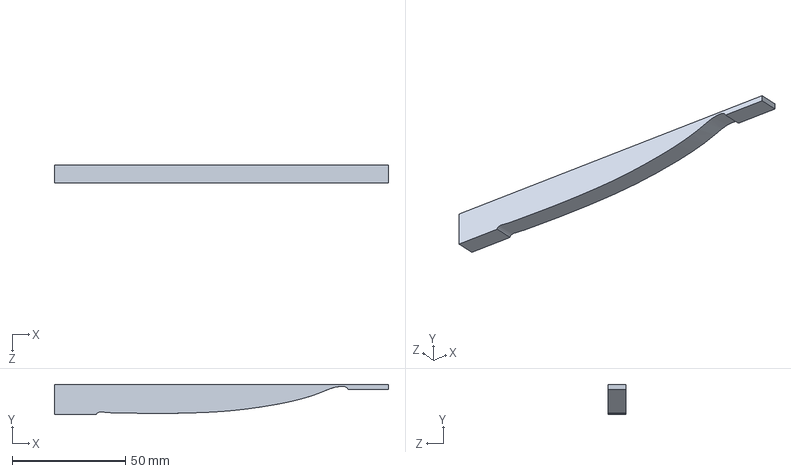
[picture p107: CAD file, 2024-08-06]
SWKS_hydrofoil/MouldSlices/BCRW08_mouldlower-S6.SLDPRT
147.4 x 13.3 x 8.00 mm
