TobyBorland/HydroTurbineBlade/SWKS_hydrofoil/BCRW08_mouldlowerblade-hubface1.SLDPRT

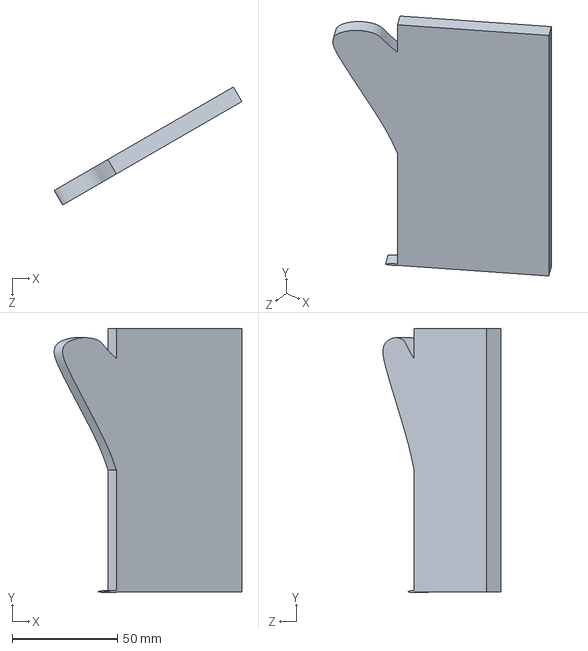
[picture p108: CAD file, 2024-08-06]
SWKS_hydrofoil/BCRW08_mouldlowerblade-hubface1.SLDPRT
89.0 x 125.2 x 56.0 mm
