TobyBorland/HydroTurbineBlade/SWKS_hydrofoil/BladeSlices/BCRW08_mouldlowerblade-H45.SLDPRT

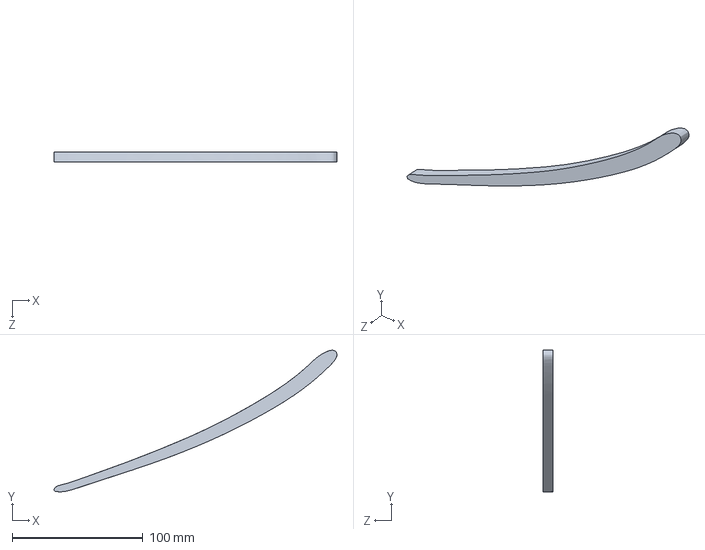
[picture p109: CAD file, 2024-08-06]
SWKS_hydrofoil/BladeSlices/BCRW08_mouldlowerblade-H45.SLDPRT
216.2 x 108.2 x 8.00 mm
