TobyBorland/HydroTurbineBlade/SWKS_hydrofoil/HubSlices/BCRW09_hubCore04-H16.SLDPRT

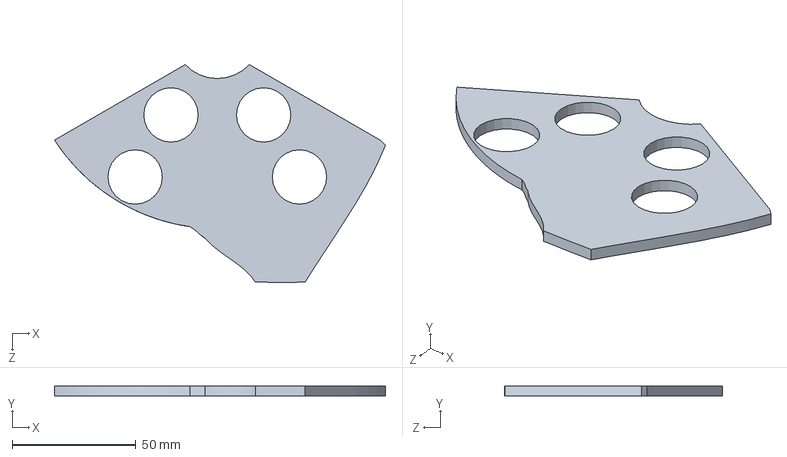
[picture p110: CAD file, 2024-08-06]
SWKS_hydrofoil/HubSlices/BCRW09_hubCore04-H16.SLDPRT
134.0 x 4.00 x 88.1 mm
