TobyBorland/HydroTurbineBlade/SWKS_hydrofoil/MouldSlices/BCRW08_mouldlower-S57P.SLDPRT

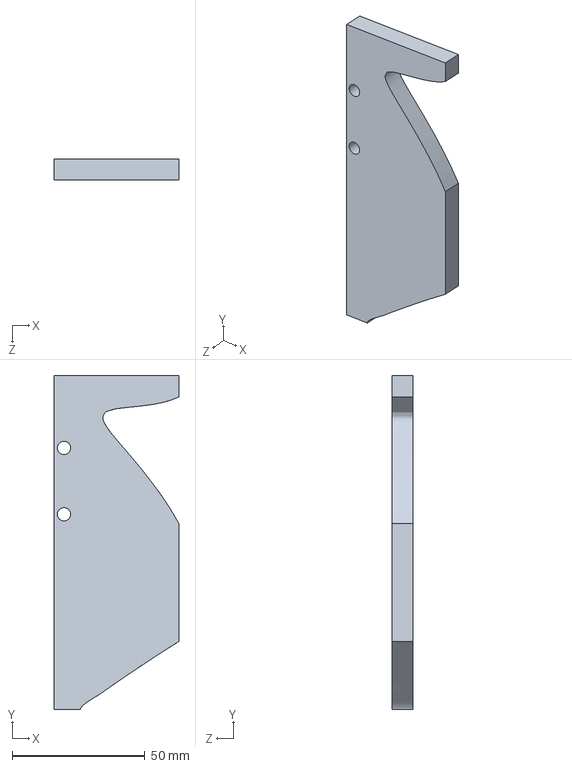
[picture p111: CAD file, 2024-08-06]
SWKS_hydrofoil/MouldSlices/BCRW08_mouldlower-S57P.SLDPRT
46.9 x 125.8 x 8.00 mm
