TobyBorland/HydroTurbineBlade/SWKS_hydrofoil/HubSlices/BCRW09_hubCore04-H23.SLDPRT

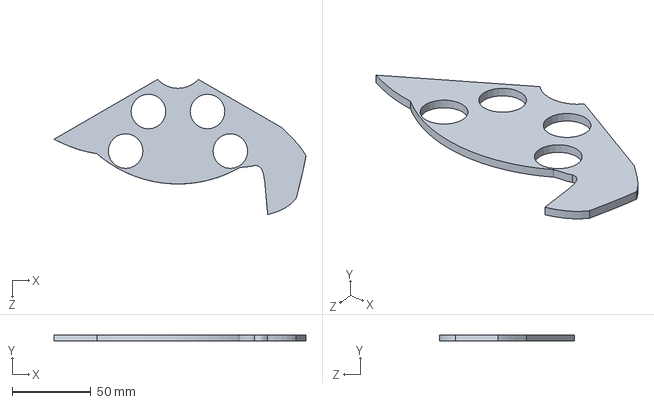
[picture p113: CAD file, 2024-08-06]
SWKS_hydrofoil/HubSlices/BCRW09_hubCore04-H23.SLDPRT
160.0 x 4.00 x 85.8 mm
