TobyBorland/HydroTurbineBlade/SWKS_hydrofoil/MouldSlices/BCRW08_mouldlower-S55S.SLDPRT

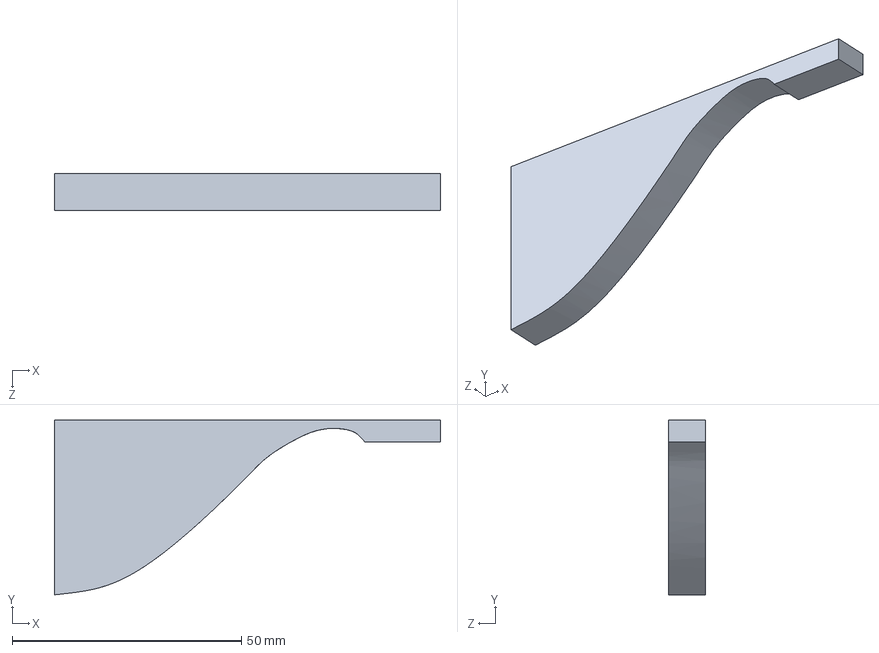
[picture p114: CAD file, 2024-08-06]
SWKS_hydrofoil/MouldSlices/BCRW08_mouldlower-S55S.SLDPRT
84.2 x 38.1 x 8.00 mm
