TobyBorland/HydroTurbineBlade/SWKS_hydrofoil/Solo_Hub_chords.SLDPRT

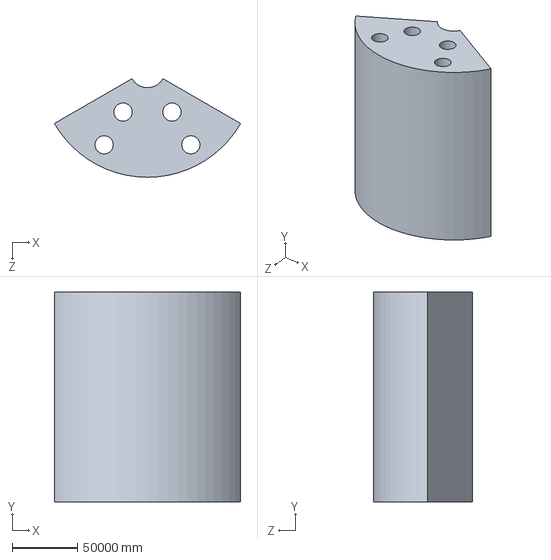
[picture p115: CAD file, 2024-08-06]
SWKS_hydrofoil/Solo_Hub_chords.SLDPRT
142894.2 x 161065.4 x 75625.0 mm
