TobyBorland/HydroTurbineBlade/SWKS_hydrofoil/HubSlices/BCRW09_hubCore04-H21.SLDPRT

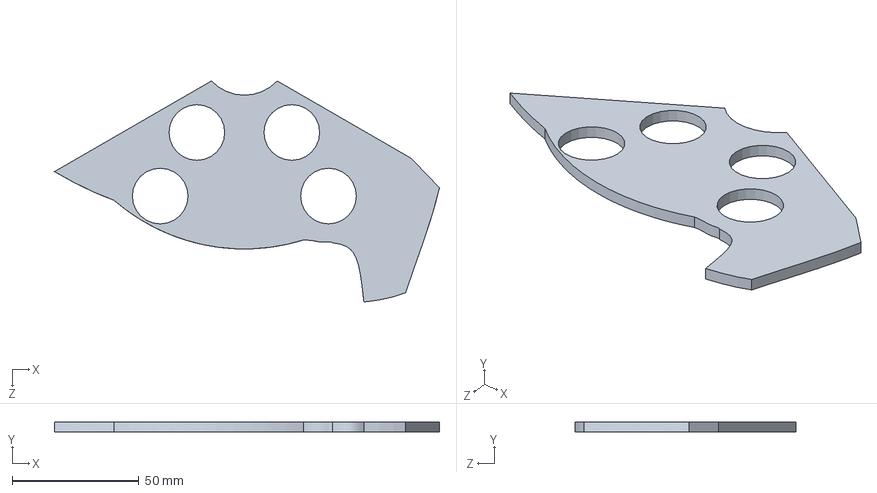
[picture p117: CAD file, 2024-08-06]
SWKS_hydrofoil/HubSlices/BCRW09_hubCore04-H21.SLDPRT
152.1 x 4.00 x 87.4 mm
