TobyBorland/HydroTurbineBlade/SWKS_hydrofoil/MouldSlices/BCRW08_mouldlower-S19.SLDPRT

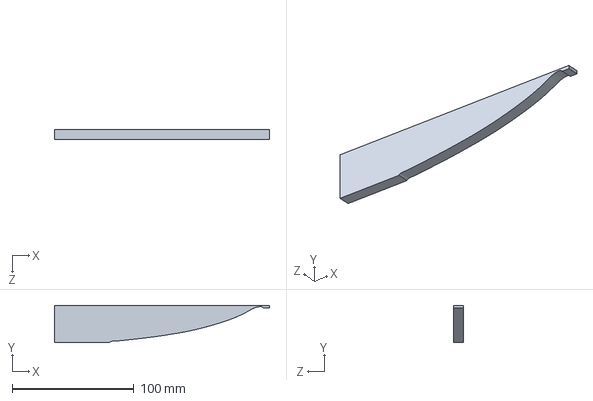
[picture p118: CAD file, 2024-08-06]
SWKS_hydrofoil/MouldSlices/BCRW08_mouldlower-S19.SLDPRT
176.3 x 30.5 x 8.00 mm
