TobyBorland/HydroTurbineBlade/SWKS_hydrofoil/Bottom of Die 2_AMW.SLDPRT

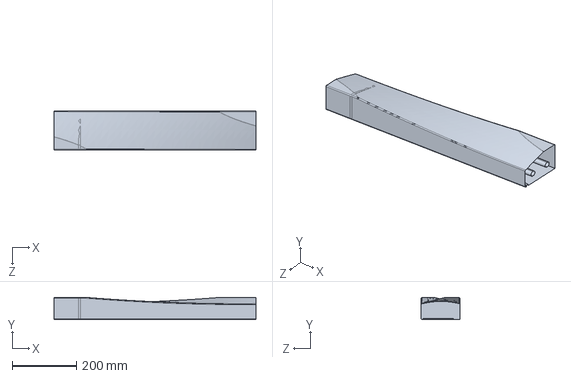
[picture p120: CAD file, 2024-08-06]
SWKS_hydrofoil/Bottom of Die 2_AMW.SLDPRT
628.7 x 69.0 x 120.7 mm
