TobyBorland/HydroTurbineBlade/SWKS_hydrofoil/HubSlices/BCRW09_hubCore04-H29.SLDPRT

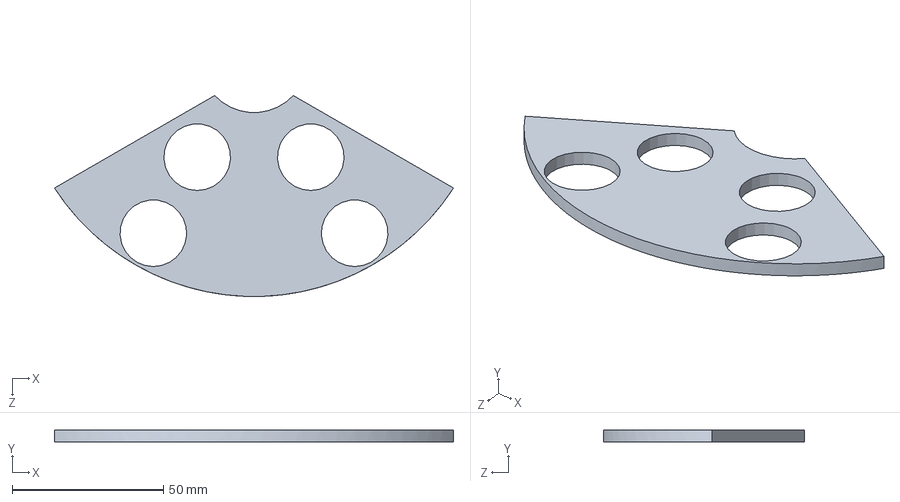
[picture p121: CAD file, 2024-08-06]
SWKS_hydrofoil/HubSlices/BCRW09_hubCore04-H29.SLDPRT
131.8 x 4.00 x 66.4 mm
