TobyBorland/HydroTurbineBlade/SWKS_hydrofoil/MouldSlices/BCRW08_mouldlower-S33.SLDPRT

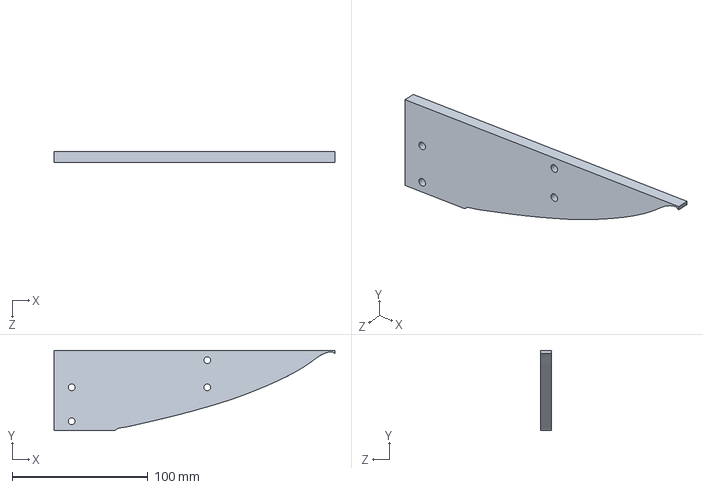
[picture p122: CAD file, 2024-08-06]
SWKS_hydrofoil/MouldSlices/BCRW08_mouldlower-S33.SLDPRT
207.4 x 59.1 x 8.00 mm
