TobyBorland/HydroTurbineBlade/SWKS_hydrofoil/MouldSlices/BCRW08_mouldlower-S54P.SLDPRT

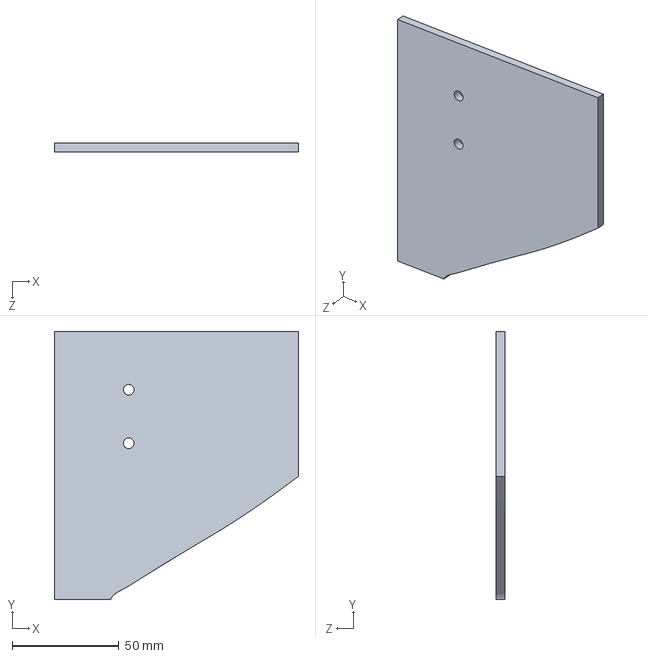
[picture p124: CAD file, 2024-08-06]
SWKS_hydrofoil/MouldSlices/BCRW08_mouldlower-S54P.SLDPRT
114.2 x 125.3 x 4.00 mm
