TobyBorland/HydroTurbineBlade/SWKS_hydrofoil/Hub_i00.sldprt

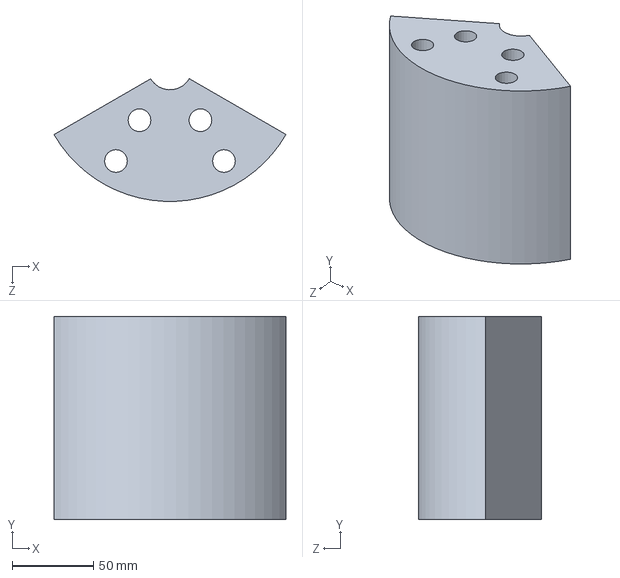
[picture p126: CAD file, 2024-08-06]
SWKS_hydrofoil/Hub_i00.sldprt
142.8 x 125.0 x 75.5 mm
