TobyBorland/HydroTurbineBlade/SWKS_hydrofoil/HubSlices/BCRW09_hubCore04-H28B.SLDPRT

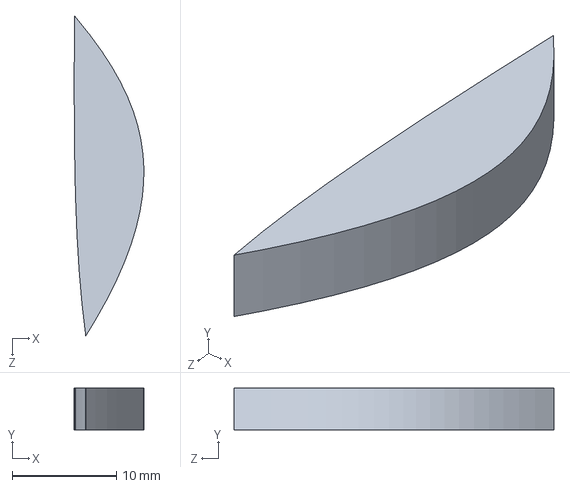
[picture p127: CAD file, 2024-08-06]
SWKS_hydrofoil/HubSlices/BCRW09_hubCore04-H28B.SLDPRT
6.67 x 4.00 x 30.6 mm
