TobyBorland/HydroTurbineBlade/SWKS_hydrofoil/MouldSlices/BCRW08_mouldlower-S13.SLDPRT

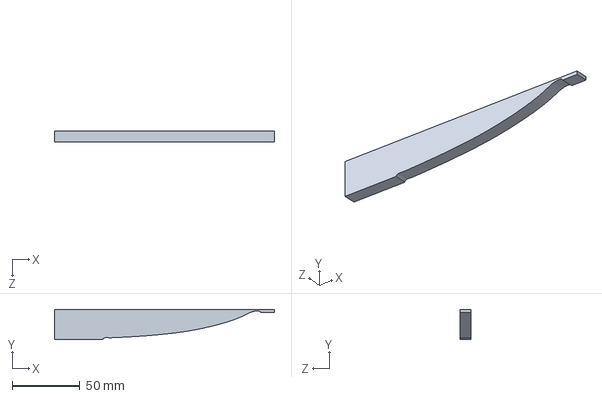
[picture p128: CAD file, 2024-08-06]
SWKS_hydrofoil/MouldSlices/BCRW08_mouldlower-S13.SLDPRT
162.9 x 22.3 x 8.00 mm
