TobyBorland/HydroTurbineBlade/SWKS_hydrofoil/BladeRevolve_i00.sldprt

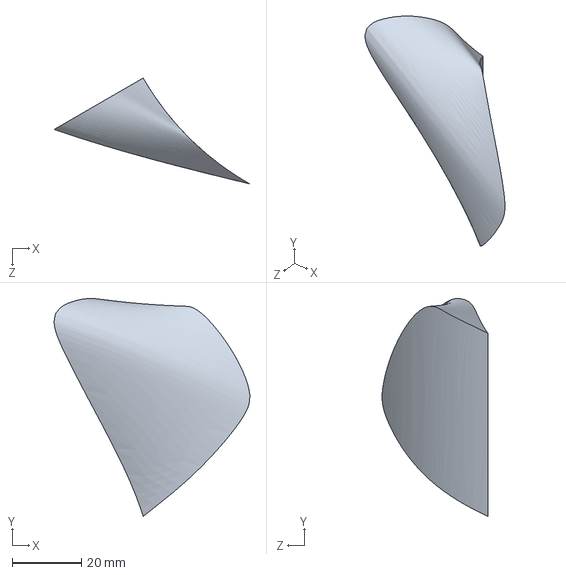
[picture p129: CAD file, 2024-08-06]
SWKS_hydrofoil/BladeRevolve_i00.sldprt
56.4 x 62.8 x 30.5 mm
