TobyBorland/HydroTurbineBlade/SWKS_hydrofoil/BladeSlices/BCRW08_mouldlowerblade-H56S.SLDPRT

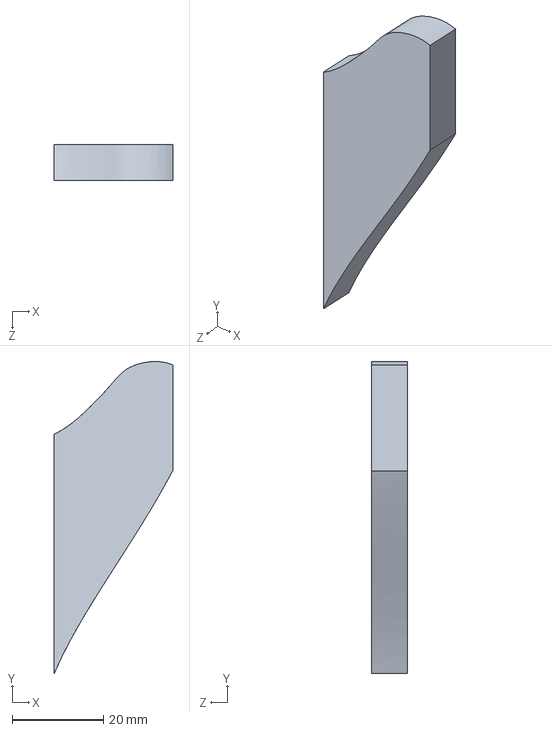
[picture p130: CAD file, 2024-08-06]
SWKS_hydrofoil/BladeSlices/BCRW08_mouldlowerblade-H56S.SLDPRT
26.0 x 68.4 x 8.00 mm
