TobyBorland/HydroTurbineBlade/SWKS_hydrofoil/MouldSlices/BCRW08_mouldlower-S29.SLDPRT

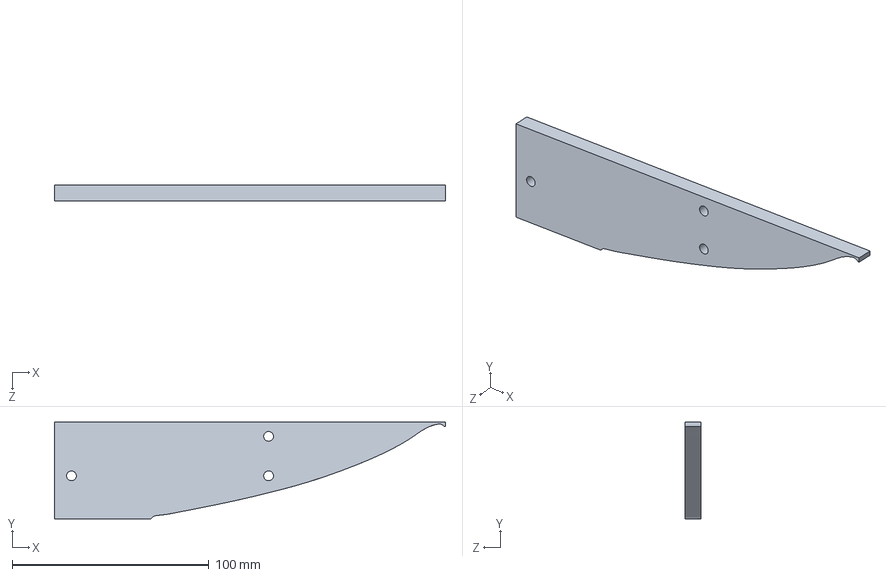
[picture p131: CAD file, 2024-08-06]
SWKS_hydrofoil/MouldSlices/BCRW08_mouldlower-S29.SLDPRT
198.5 x 49.1 x 8.00 mm
