TobyBorland/HydroTurbineBlade/SWKS_hydrofoil/MouldSlices/BCRW08_mouldlower-S47.SLDPRT

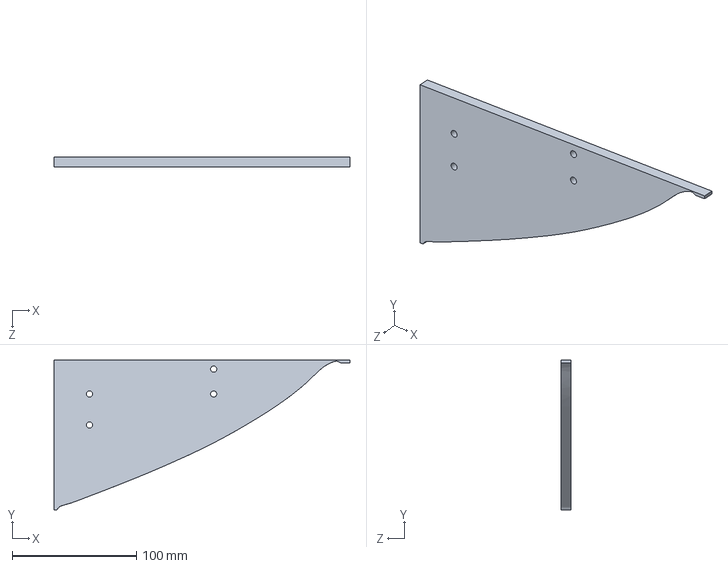
[picture p133: CAD file, 2024-08-06]
SWKS_hydrofoil/MouldSlices/BCRW08_mouldlower-S47.SLDPRT
238.5 x 120.6 x 8.00 mm
