TobyBorland/HydroTurbineBlade/SWKS_hydrofoil/HubSlices/BCRW09_hubCore04-H17.SLDPRT

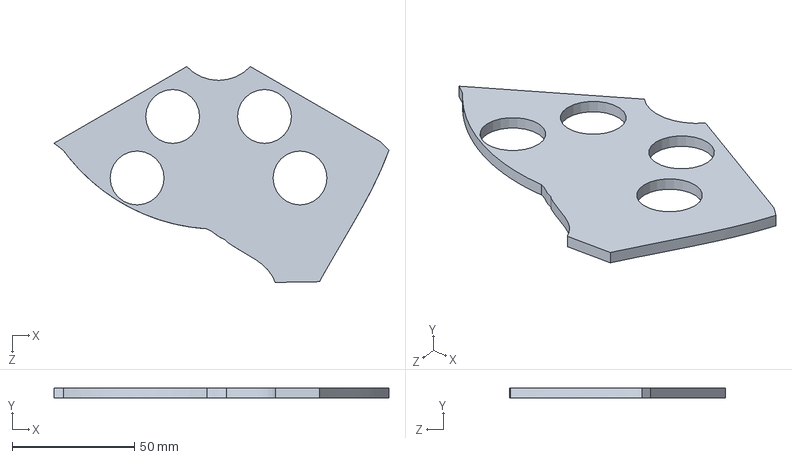
[picture p135: CAD file, 2024-08-06]
SWKS_hydrofoil/HubSlices/BCRW09_hubCore04-H17.SLDPRT
136.8 x 4.00 x 88.1 mm
