TobyBorland/HydroTurbineBlade/SWKS_hydrofoil/MouldSlices/BCRW08_mouldlower-S24.SLDPRT

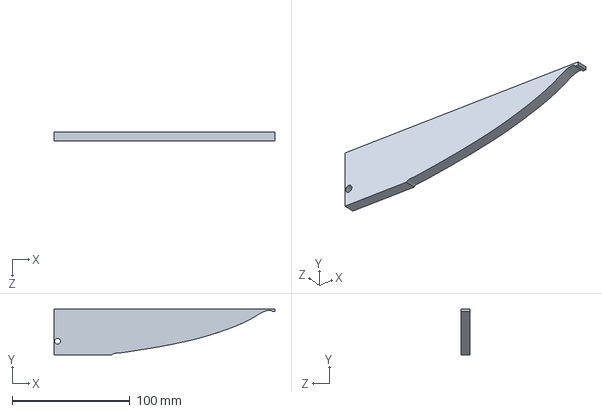
[picture p136: CAD file, 2024-08-06]
SWKS_hydrofoil/MouldSlices/BCRW08_mouldlower-S24.SLDPRT
187.4 x 38.9 x 8.00 mm
