TobyBorland/HydroTurbineBlade/SWKS_hydrofoil/BCRW08_mouldlowerblade-hubface.SLDPRT

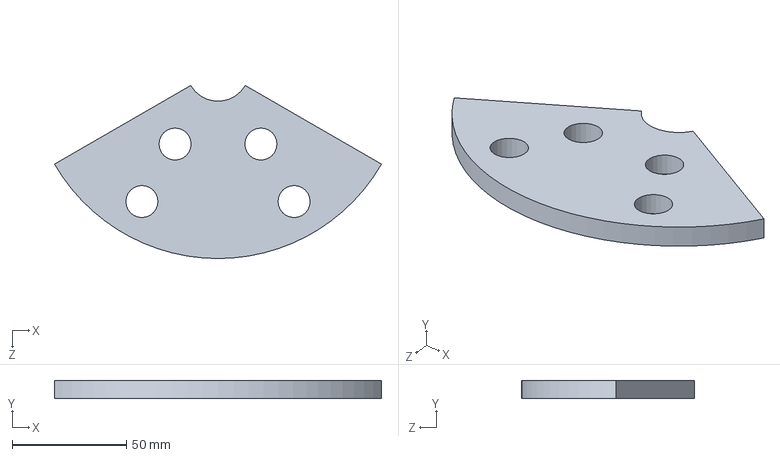
[picture p137: CAD file, 2024-08-06]
SWKS_hydrofoil/BCRW08_mouldlowerblade-hubface.SLDPRT
142.9 x 8.00 x 75.6 mm
