TobyBorland/HydroTurbineBlade/SWKS_hydrofoil/MouldSlices/BCRW08_mouldlower-S46.SLDPRT

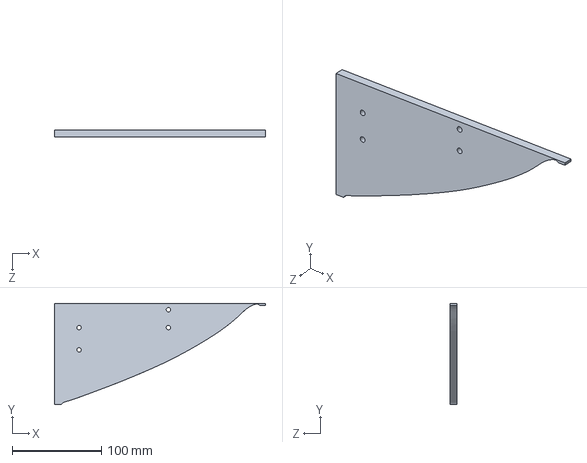
[picture p139: CAD file, 2024-08-06]
SWKS_hydrofoil/MouldSlices/BCRW08_mouldlower-S46.SLDPRT
236.3 x 113.6 x 8.00 mm
