TobyBorland/HydroTurbineBlade/SWKS_hydrofoil/MouldSlices/BCRW08_mouldlower-S9.SLDPRT

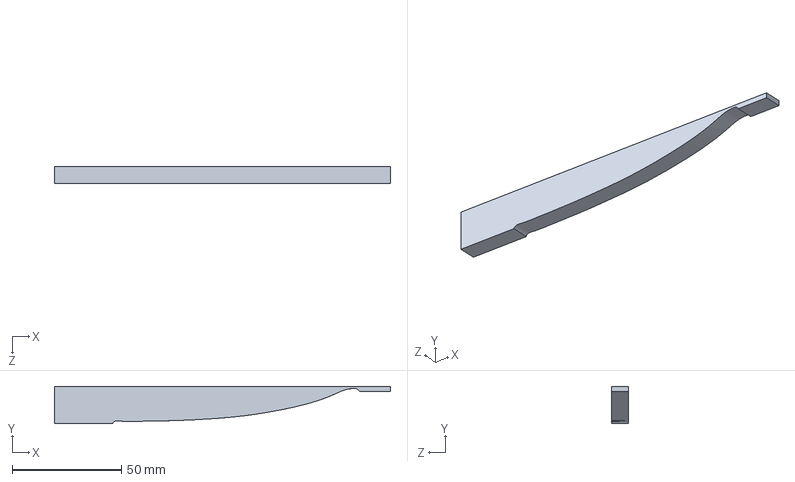
[picture p140: CAD file, 2024-08-06]
SWKS_hydrofoil/MouldSlices/BCRW08_mouldlower-S9.SLDPRT
154.0 x 17.1 x 8.00 mm
