TobyBorland/HydroTurbineBlade/SWKS_hydrofoil/BladeSlices/BCRW08_mouldlowerblade-H53P.SLDPRT

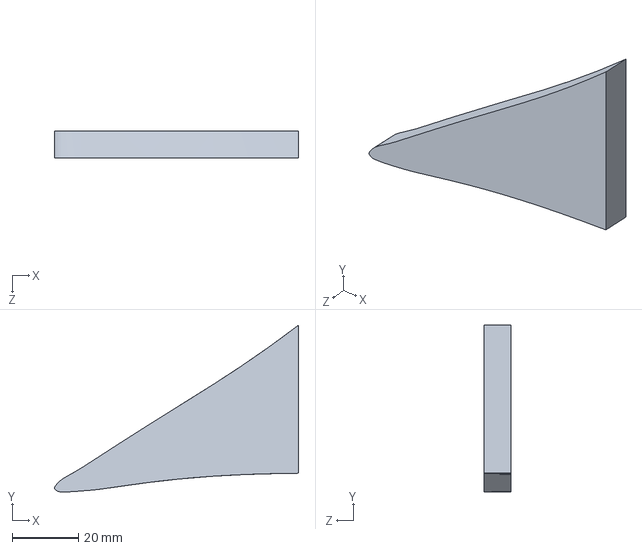
[picture p141: CAD file, 2024-08-06]
SWKS_hydrofoil/BladeSlices/BCRW08_mouldlowerblade-H53P.SLDPRT
73.6 x 50.3 x 8.00 mm
