TobyBorland/HydroTurbineBlade/SWKS_hydrofoil/MouldSlices/BCRW08_mouldlower-S43.SLDPRT

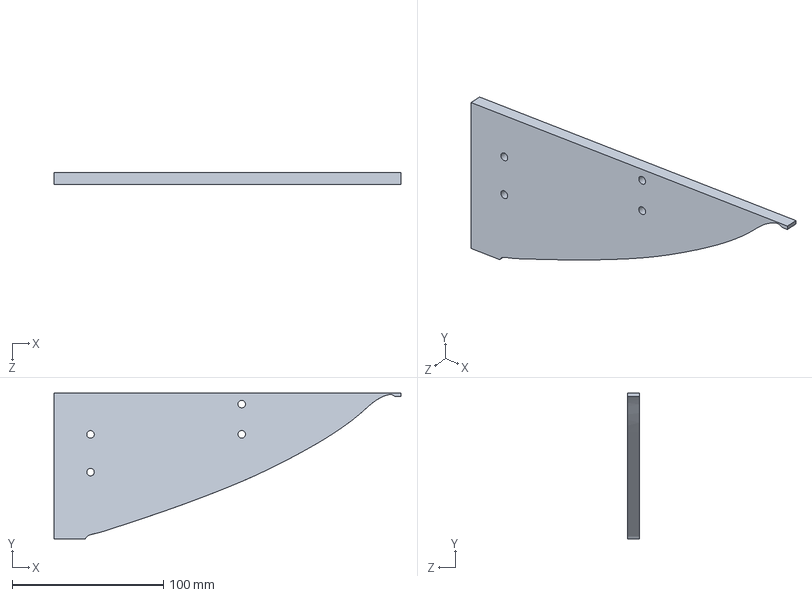
[picture p142: CAD file, 2024-08-06]
SWKS_hydrofoil/MouldSlices/BCRW08_mouldlower-S43.SLDPRT
229.6 x 96.4 x 8.00 mm
