TobyBorland/HydroTurbineBlade/SWKS_hydrofoil/HubSlices/BCRW09_hubCore04-H20.SLDPRT

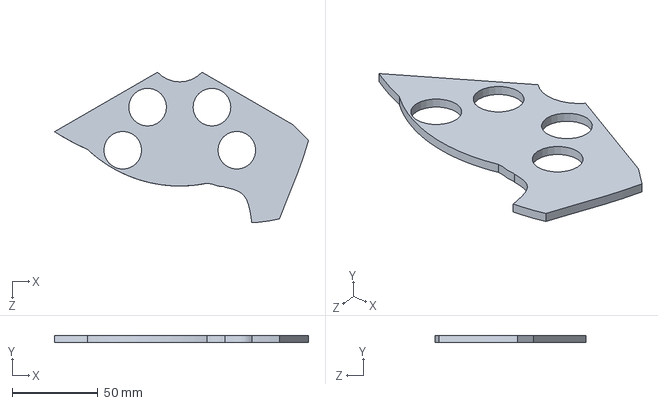
[picture p144: CAD file, 2024-08-06]
SWKS_hydrofoil/HubSlices/BCRW09_hubCore04-H20.SLDPRT
148.1 x 4.00 x 87.8 mm
