TobyBorland/HydroTurbineBlade/SWKS_hydrofoil/MouldSlices/BCRW08_mouldlower-S32.SLDPRT

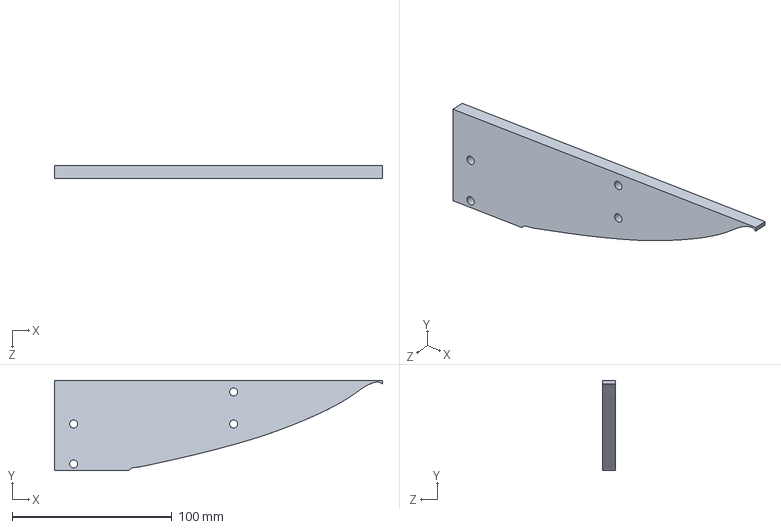
[picture p145: CAD file, 2024-08-06]
SWKS_hydrofoil/MouldSlices/BCRW08_mouldlower-S32.SLDPRT
205.2 x 56.4 x 8.00 mm
