TobyBorland/HydroTurbineBlade/SWKS_hydrofoil/MouldSlices/BCRW08_mouldlower-S45.SLDPRT

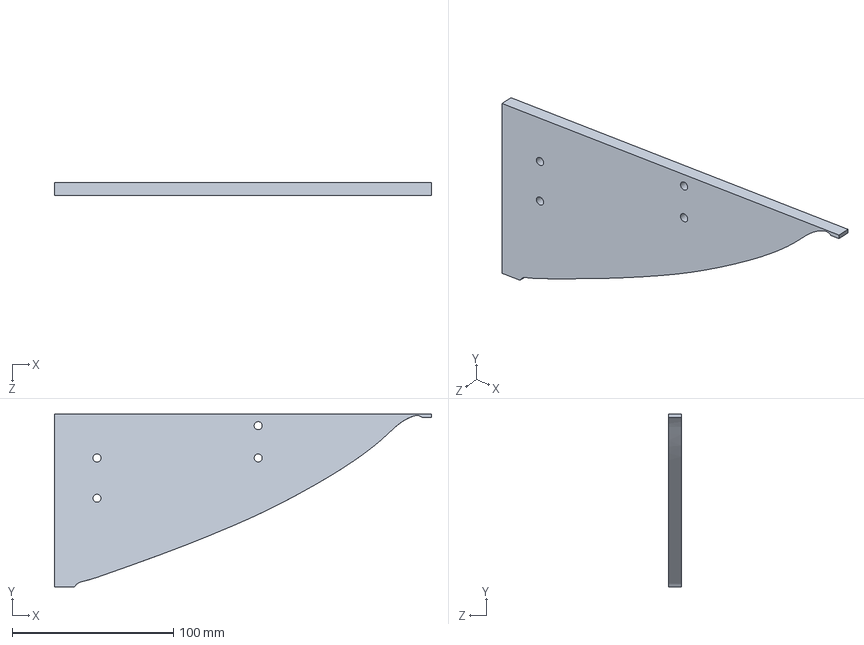
[picture p147: CAD file, 2024-08-06]
SWKS_hydrofoil/MouldSlices/BCRW08_mouldlower-S45.SLDPRT
234.1 x 107.3 x 8.00 mm
