TobyBorland/HydroTurbineBlade/SWKS_hydrofoil/BladeSlices/BCRW08_mouldlowerblade-H53S.SLDPRT

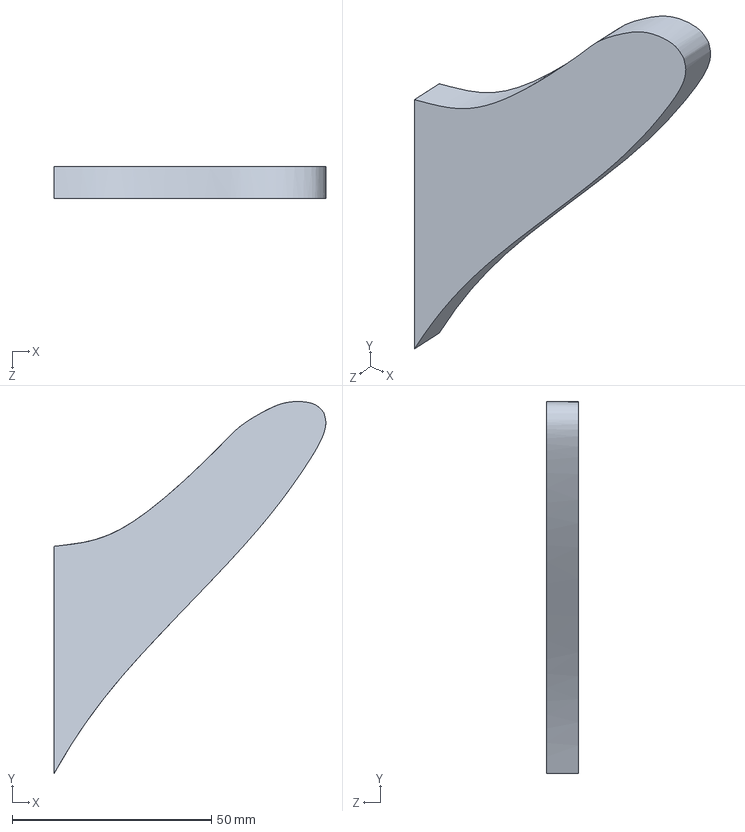
[picture p148: CAD file, 2024-08-06]
SWKS_hydrofoil/BladeSlices/BCRW08_mouldlowerblade-H53S.SLDPRT
68.3 x 93.5 x 8.00 mm
