TobyBorland/HydroTurbineBlade/SWKS_hydrofoil/HubSlices/BCRW09_hubCore04-H27B.SLDPRT

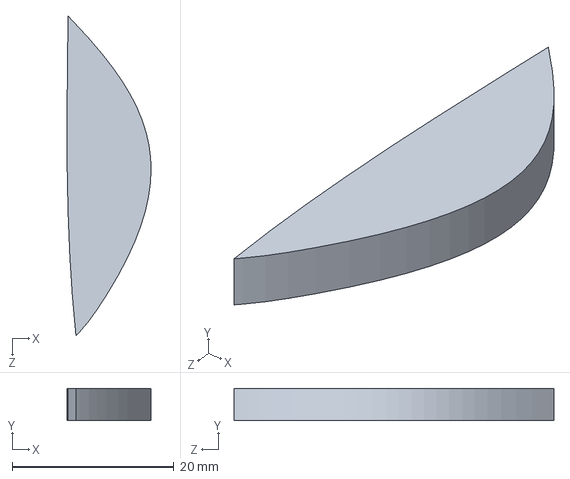
[picture p150: CAD file, 2024-08-06]
SWKS_hydrofoil/HubSlices/BCRW09_hubCore04-H27B.SLDPRT
10.4 x 4.00 x 39.6 mm
