TobyBorland/HydroTurbineBlade/SWKS_hydrofoil/MouldSlices/BCRW08_mouldlower-S27.SLDPRT

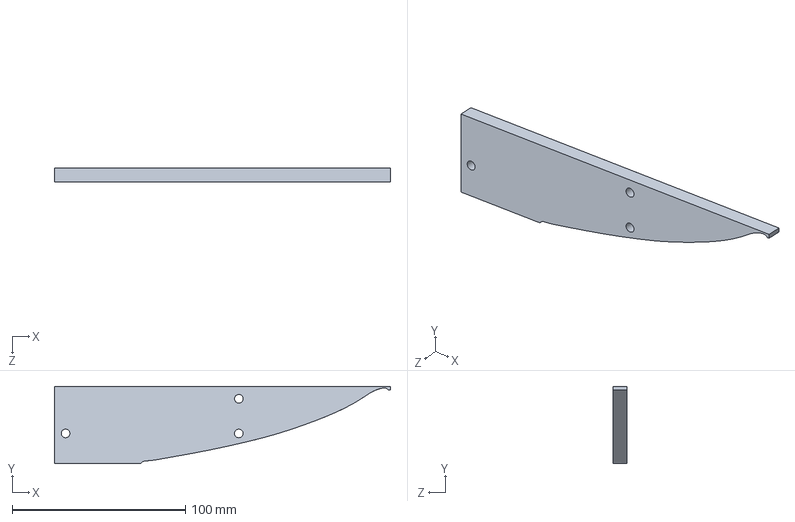
[picture p151: CAD file, 2024-08-06]
SWKS_hydrofoil/MouldSlices/BCRW08_mouldlower-S27.SLDPRT
194.1 x 44.7 x 8.00 mm
