TobyBorland/HydroTurbineBlade/SWKS_hydrofoil/HubSlices/BCRW09_hubCore04-H22.SLDPRT

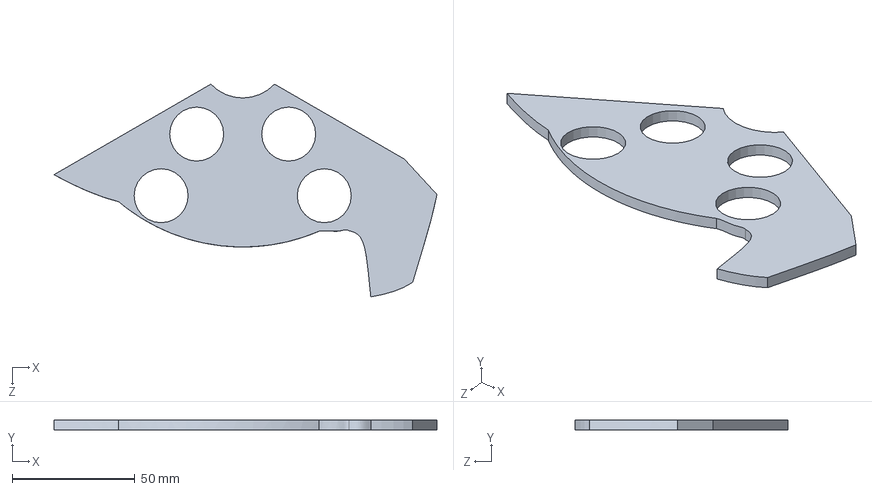
[picture p152: CAD file, 2024-08-06]
SWKS_hydrofoil/HubSlices/BCRW09_hubCore04-H22.SLDPRT
156.1 x 4.00 x 86.7 mm
