TobyBorland/HydroTurbineBlade/SWKS_hydrofoil/HubSlices/BCRW09_hubCore04-H2.SLDPRT

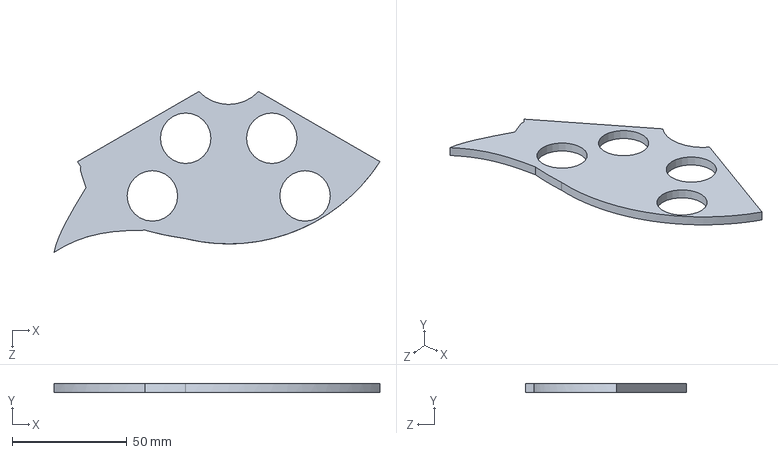
[picture p154: CAD file, 2024-08-06]
SWKS_hydrofoil/HubSlices/BCRW09_hubCore04-H2.SLDPRT
142.0 x 4.00 x 70.1 mm
