TobyBorland/HydroTurbineBlade/SWKS_hydrofoil/MouldSlices/BCRW08_mouldlower-S42.SLDPRT

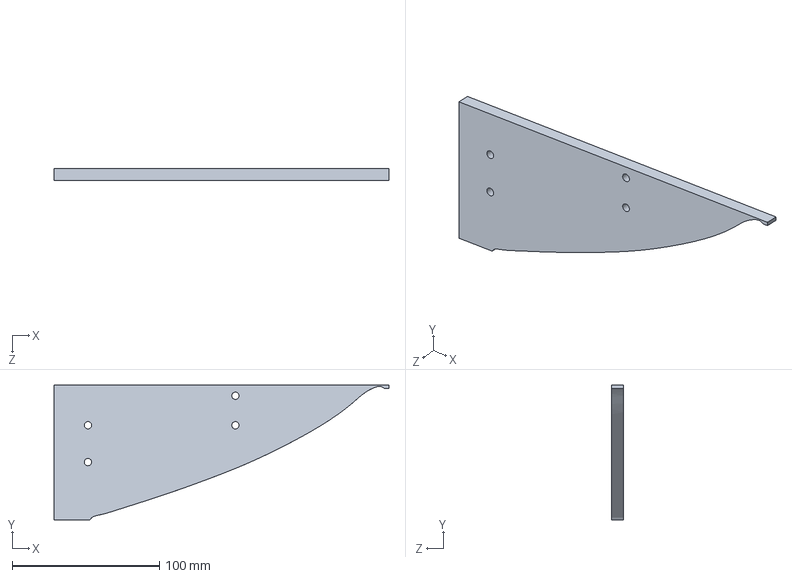
[picture p155: CAD file, 2024-08-06]
SWKS_hydrofoil/MouldSlices/BCRW08_mouldlower-S42.SLDPRT
227.4 x 91.5 x 8.00 mm
