TobyBorland/HydroTurbineBlade/SWKS_hydrofoil/MouldSlices/BCRW08_mouldlower-S14.SLDPRT

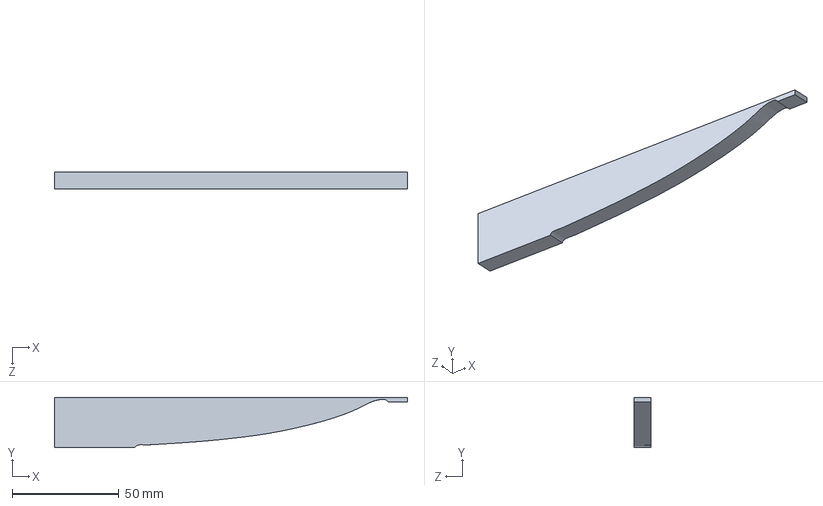
[picture p157: CAD file, 2024-08-06]
SWKS_hydrofoil/MouldSlices/BCRW08_mouldlower-S14.SLDPRT
165.2 x 23.6 x 8.00 mm
