TobyBorland/HydroTurbineBlade/SWKS_hydrofoil/MouldSlices/BCRW08_mouldlower-S12.SLDPRT

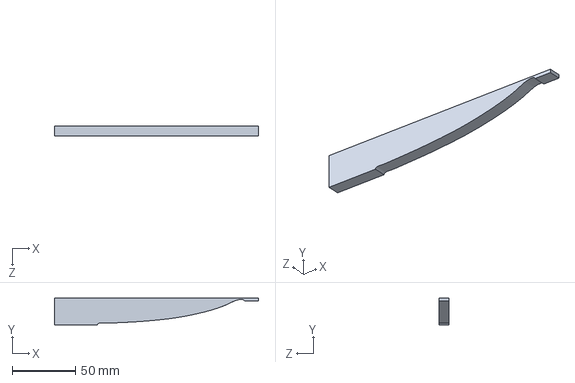
[picture p159: CAD file, 2024-08-06]
SWKS_hydrofoil/MouldSlices/BCRW08_mouldlower-S12.SLDPRT
160.7 x 20.9 x 8.00 mm
