TobyBorland/HydroTurbineBlade/SWKS_hydrofoil/HubSlices/BCRW09_hubCore04-H3.SLDPRT

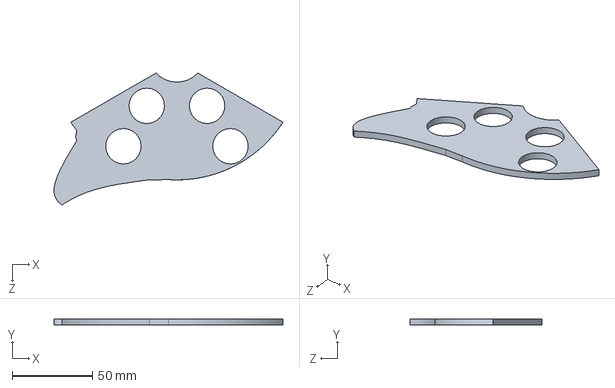
[picture p161: CAD file, 2024-08-06]
SWKS_hydrofoil/HubSlices/BCRW09_hubCore04-H3.SLDPRT
142.3 x 4.00 x 81.9 mm
