TobyBorland/HydroTurbineBlade/SWKS_hydrofoil/MouldSlices/BCRW08_mouldlower-S37.SLDPRT

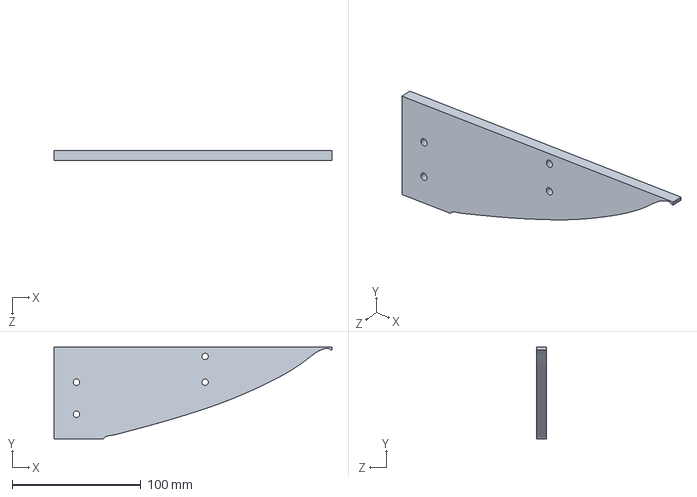
[picture p162: CAD file, 2024-08-06]
SWKS_hydrofoil/MouldSlices/BCRW08_mouldlower-S37.SLDPRT
216.3 x 71.4 x 8.00 mm
