TobyBorland/HydroTurbineBlade/SWKS_hydrofoil/BladeSlices/BCRW08_mouldlowerblade-H57P.SLDPRT

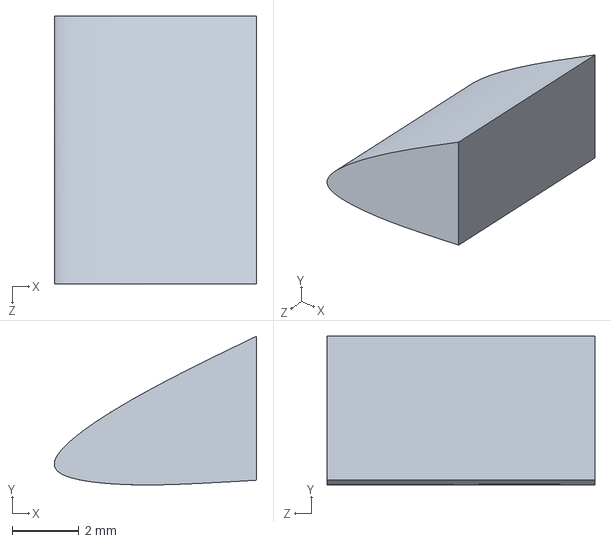
[picture p163: CAD file, 2024-08-06]
SWKS_hydrofoil/BladeSlices/BCRW08_mouldlowerblade-H57P.SLDPRT
6.04 x 4.44 x 8.00 mm
