TobyBorland/HydroTurbineBlade/SWKS_hydrofoil/MouldSlices/BCRW08_mouldlower-S16.SLDPRT

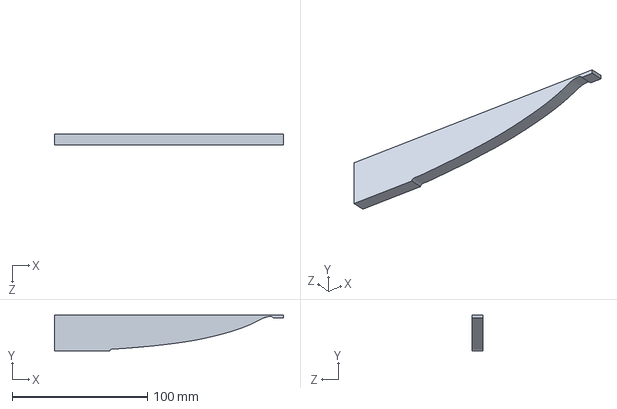
[picture p164: CAD file, 2024-08-06]
SWKS_hydrofoil/MouldSlices/BCRW08_mouldlower-S16.SLDPRT
169.6 x 26.4 x 8.00 mm
