TobyBorland/HydroTurbineBlade/SWKS_hydrofoil/HubSlices/BCRW09_hubCore04-H4.SLDPRT

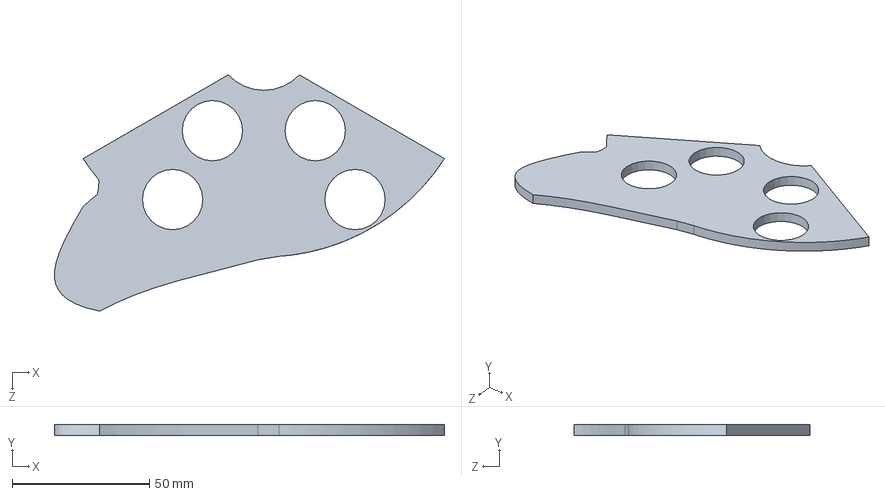
[picture p165: CAD file, 2024-08-06]
SWKS_hydrofoil/HubSlices/BCRW09_hubCore04-H4.SLDPRT
142.2 x 4.00 x 86.2 mm
