TobyBorland/HydroTurbineBlade/SWKS_hydrofoil/MouldSlices/BCRW08_mouldlower-S56P.SLDPRT

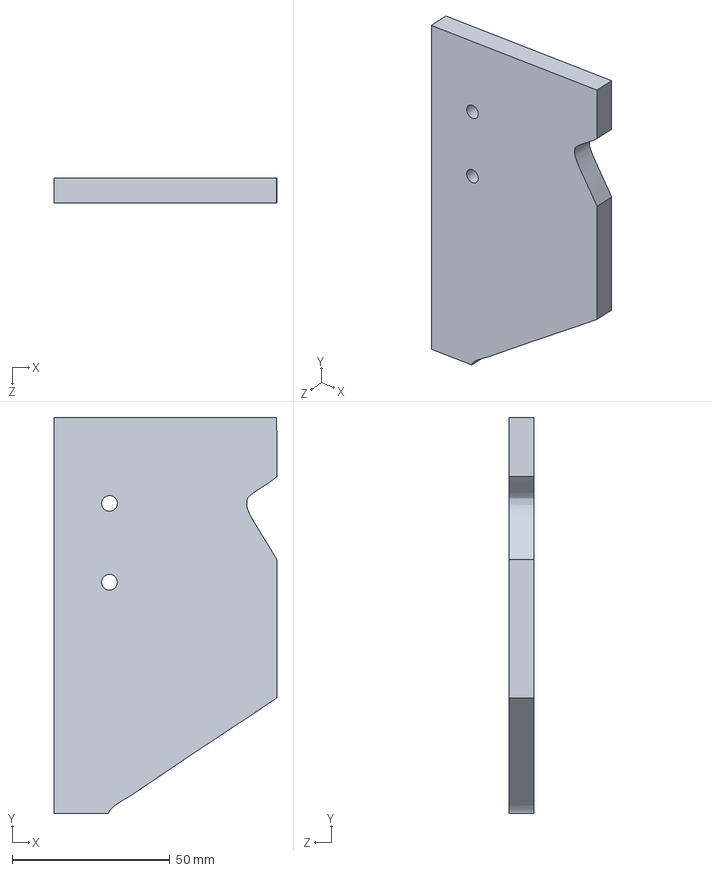
[picture p167: CAD file, 2024-08-06]
SWKS_hydrofoil/MouldSlices/BCRW08_mouldlower-S56P.SLDPRT
70.7 x 125.6 x 8.00 mm
