TobyBorland/HydroTurbineBlade/SWKS_hydrofoil/BladeSlices/BCRW08_mouldlowerblade-H55P.SLDPRT

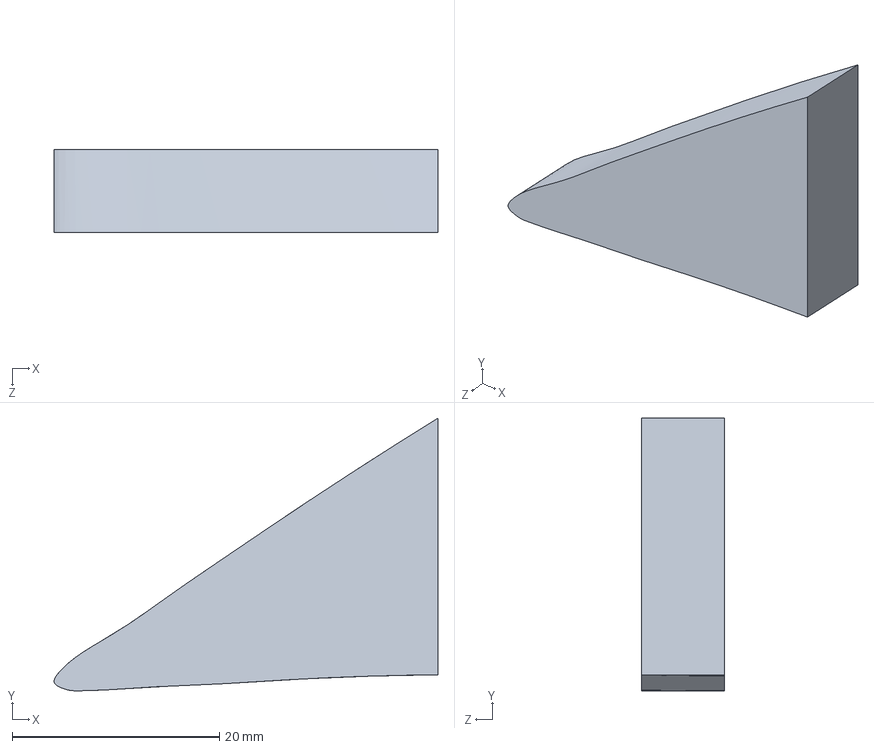
[picture p168: CAD file, 2024-08-06]
SWKS_hydrofoil/BladeSlices/BCRW08_mouldlowerblade-H55P.SLDPRT
37.1 x 26.3 x 8.00 mm
