TobyBorland/HydroTurbineBlade/SWKS_hydrofoil/MouldSlices/BCRW08_mouldlower-S57LP.SLDPRT

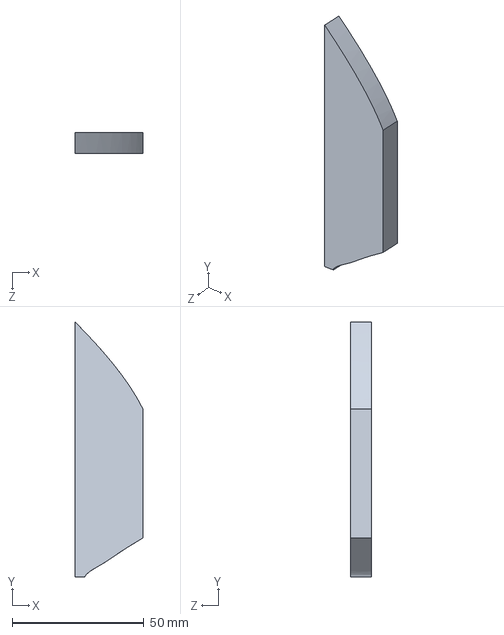
[picture p169: CAD file, 2024-08-06]
SWKS_hydrofoil/MouldSlices/BCRW08_mouldlower-S57LP.SLDPRT
25.7 x 96.6 x 8.00 mm
