TobyBorland/HydroTurbineBlade/SWKS_hydrofoil/HubSlices/BCRW09_hubCore04-H24.SLDPRT

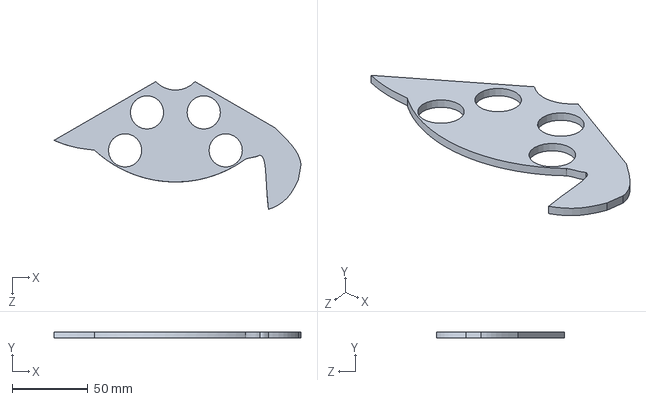
[picture p171: CAD file, 2024-08-06]
SWKS_hydrofoil/HubSlices/BCRW09_hubCore04-H24.SLDPRT
163.3 x 4.00 x 84.5 mm
