TobyBorland/HydroTurbineBlade/SWKS_hydrofoil/MouldSlices/BCRW08_mouldlower-S5.SLDPRT

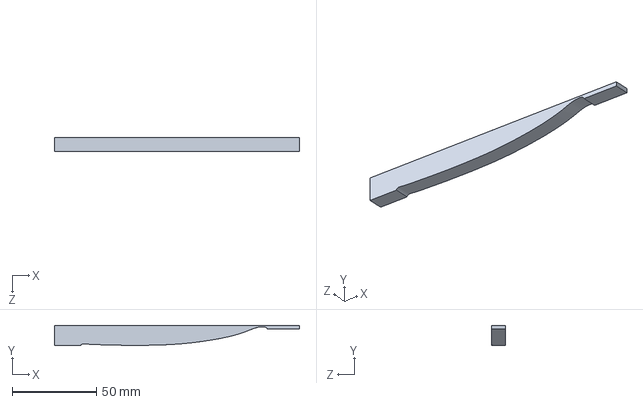
[picture p172: CAD file, 2024-08-06]
SWKS_hydrofoil/MouldSlices/BCRW08_mouldlower-S5.SLDPRT
145.1 x 12.0 x 8.00 mm
