TobyBorland/HydroTurbineBlade/SWKS_hydrofoil/MouldSlices/BCRW08_mouldlower-S53.SLDPRT

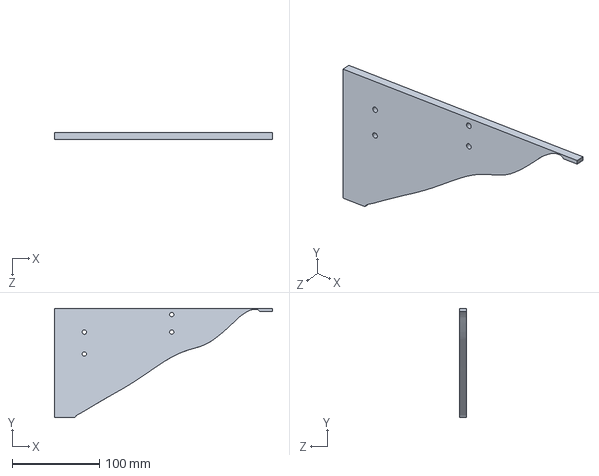
[picture p174: CAD file, 2024-08-06]
SWKS_hydrofoil/MouldSlices/BCRW08_mouldlower-S53.SLDPRT
249.6 x 125.2 x 8.00 mm
