TobyBorland/HydroTurbineBlade/SWKS_hydrofoil/MouldSlices/BCRW08_mouldlower-S40.SLDPRT

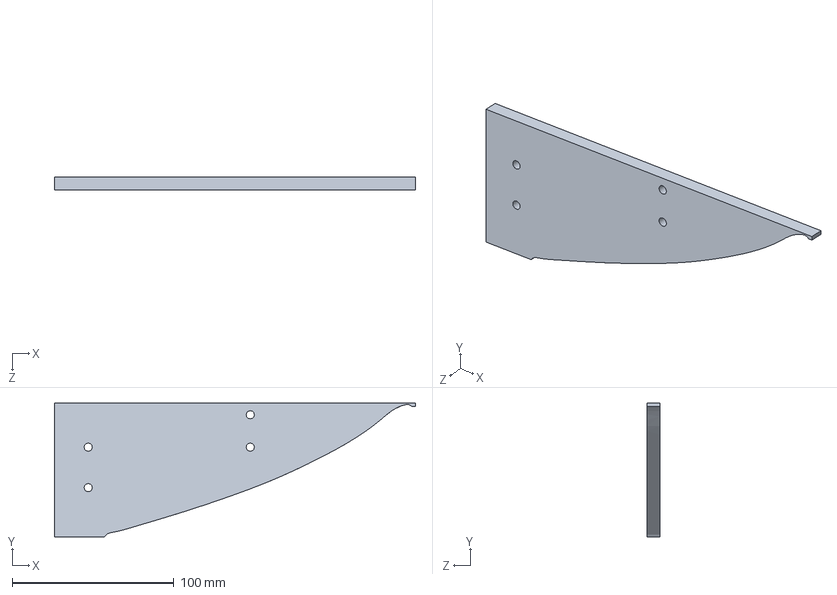
[picture p176: CAD file, 2024-08-06]
SWKS_hydrofoil/MouldSlices/BCRW08_mouldlower-S40.SLDPRT
223.0 x 82.7 x 8.00 mm
