TobyBorland/HydroTurbineBlade/SWKS_hydrofoil/MouldSlices/BCRW08_mouldlower-S28.SLDPRT

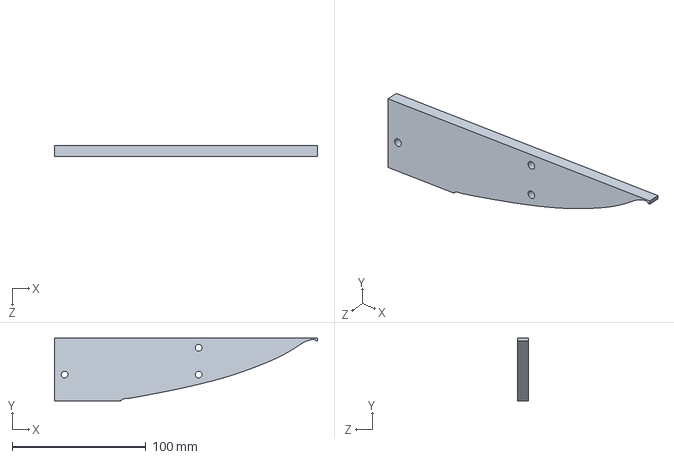
[picture p178: CAD file, 2024-08-06]
SWKS_hydrofoil/MouldSlices/BCRW08_mouldlower-S28.SLDPRT
196.3 x 46.9 x 8.00 mm
