TobyBorland/HydroTurbineBlade/SWKS_hydrofoil/MouldSlices/BCRW08_mouldlower-S10.SLDPRT

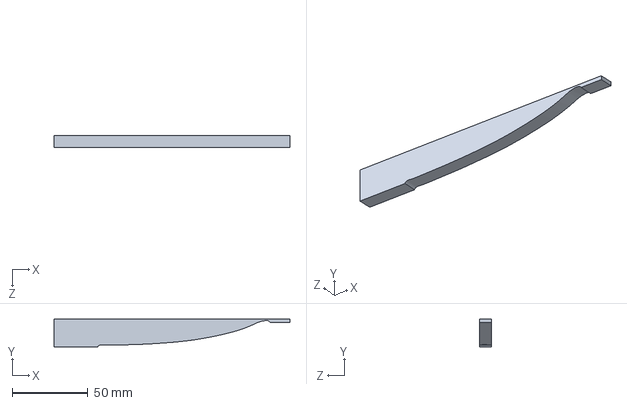
[picture p181: CAD file, 2024-08-06]
SWKS_hydrofoil/MouldSlices/BCRW08_mouldlower-S10.SLDPRT
156.3 x 18.3 x 8.00 mm
