TobyBorland/HydroTurbineBlade/SWKS_hydrofoil/BladeSlices/BCRW08_mouldlowerblade-H54P.SLDPRT

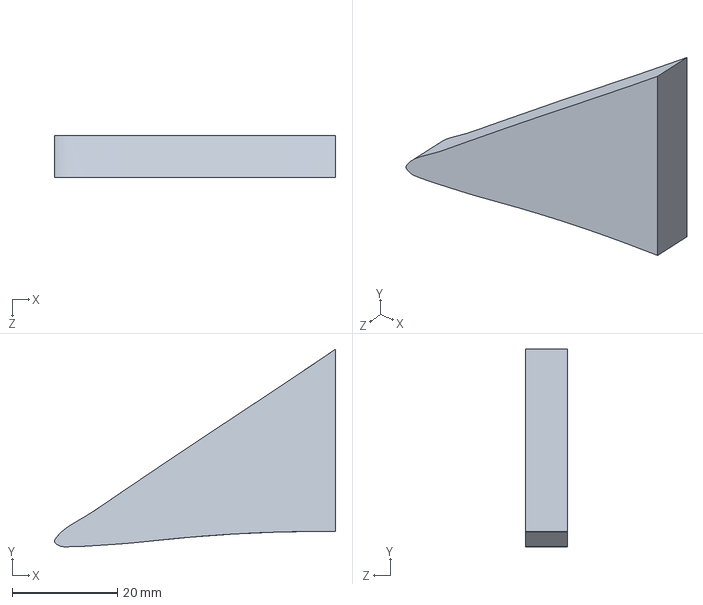
[picture p183: CAD file, 2024-08-06]
SWKS_hydrofoil/BladeSlices/BCRW08_mouldlowerblade-H54P.SLDPRT
53.4 x 37.6 x 8.00 mm
