TobyBorland/HydroTurbineBlade/SWKS_hydrofoil/MouldSlices/BCRW08_mouldlower-S7.SLDPRT

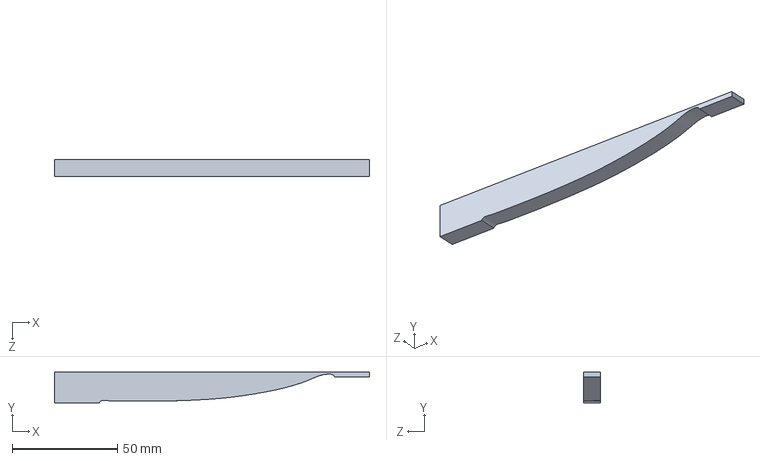
[picture p185: CAD file, 2024-08-06]
SWKS_hydrofoil/MouldSlices/BCRW08_mouldlower-S7.SLDPRT
149.6 x 14.5 x 8.00 mm
