TobyBorland/HydroTurbineBlade/SWKS_hydrofoil/HubSlices/BCRW09_hubCore04-H26.SLDPRT

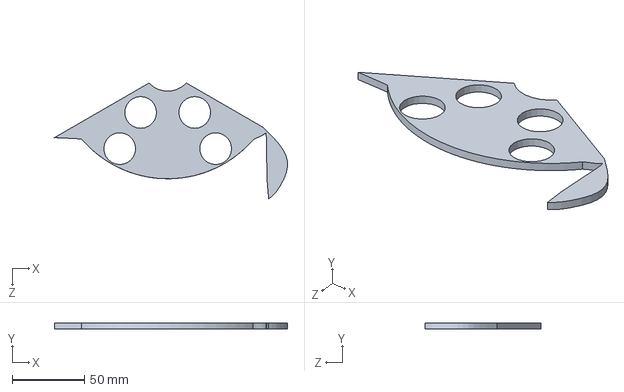
[picture p187: CAD file, 2024-08-06]
SWKS_hydrofoil/HubSlices/BCRW09_hubCore04-H26.SLDPRT
161.5 x 4.00 x 80.3 mm
