TobyBorland/HydroTurbineBlade/(list of files, cad)

Other CAD files:
SWKS_hydrofoil/full_blade_r14.dwg
SWKS_hydrofoil/MouldSlices/Slices_45_46.SLDASM
SWKS_hydrofoil/Shroud.dxf
SWKS_hydrofoil/HubSlices/BCRW09_hubCore04-H18.SLDPRT
SWKS_hydrofoil/Solo_Hub.SLDPRT
SWKS_hydrofoil/Hub00.SLDPRT
SWKS_hydrofoil/HubSlices/BCRW09_hubCore04-H5.SLDPRT
SWKS_hydrofoil/6_hole_flange_third.dwg
SWKS_hydrofoil/HubSlices/BCRW09_hubCore04-H9.SLDPRT
SWKS_hydrofoil/HubSlices/BCRW09_hubCore04-H28A.SLDPRT
SWKS_hydrofoil/HubSlices/BCRW09_hubCore04-H7.SLDPRT
SWKS_hydrofoil/MouldSlices/BCRW08_mouldlower-S48.SLDPRT
SWKS_hydrofoil/BladeSlices/BCRW08_mouldlowerblade-H6.SLDPRT
SWKS_hydrofoil/HubSlices/BCRW09_hubCore04-H12.SLDPRT
SWKS_hydrofoil/HubSlices/BCRW09_hubCore04-H15.SLDPRT
SWKS_hydrofoil/HubSlices/BCRW09_hubCore04-H13.SLDPRT
SWKS_hydrofoil/HubSlices/BCRW09_hubCore04-H10.SLDPRT
SWKS_hydrofoil/HubSlices/BCRW09_hubCore04-H30.SLDPRT
SWKS_hydrofoil/HubSlices/BCRW09_hubCore04-H27A.SLDPRT
SWKS_hydrofoil/HubSlices/BCRW09_hubCore04-H11.SLDPRT
SWKS_hydrofoil/HubSlices/BCRW09_hubCore04-H14.SLDPRT
SWKS_hydrofoil/HubSlices/BCRW09_hubCore04-H8.SLDPRT
SWKS_hydrofoil/BladeSlices/BCRW08_mouldlowerblade-H3.SLDPRT
SWKS_hydrofoil/6_hole_flange.dwg
SWKS_hydrofoil/BCRW08_mouldlowerBox.SLDDRW
SWKS_hydrofoil/BCRW08_mouldlower_guide.SLDDRW
SWKS_hydrofoil/BCRW08_mouldlowerblade-hubface.SLDDRW
SWKS_hydrofoil/BCRW08_mouldlowerblade-hubface1.SLDDRW
SWKS_hydrofoil/BCRW08_mouldlowerblade-hubface2.SLDDRW
SWKS_hydrofoil/BCRW08_mouldlowerblade.SLDDRW
SWKS_hydrofoil/BladeSlices/BCRW08_mouldlowerblade-H10.SLDPRT
SWKS_hydrofoil/BladeSlices/BCRW08_mouldlowerblade-H11.SLDPRT
SWKS_hydrofoil/BladeSlices/BCRW08_mouldlowerblade-H13.SLDPRT
SWKS_hydrofoil/BladeSlices/BCRW08_mouldlowerblade-H14.SLDPRT
SWKS_hydrofoil/BladeSlices/BCRW08_mouldlowerblade-H18.SLDPRT
SWKS_hydrofoil/BladeSlices/BCRW08_mouldlowerblade-H19.SLDPRT
SWKS_hydrofoil/BladeSlices/BCRW08_mouldlowerblade-H20.SLDPRT
SWKS_hydrofoil/BladeSlices/BCRW08_mouldlowerblade-H21.SLDPRT
SWKS_hydrofoil/BladeSlices/BCRW08_mouldlowerblade-H22.SLDPRT
SWKS_hydrofoil/BladeSlices/BCRW08_mouldlowerblade-H26.SLDPRT
SWKS_hydrofoil/BladeSlices/BCRW08_mouldlowerblade-H27.SLDPRT
SWKS_hydrofoil/BladeSlices/BCRW08_mouldlowerblade-H28.SLDPRT
SWKS_hydrofoil/BladeSlices/BCRW08_mouldlowerblade-H29.SLDPRT
SWKS_hydrofoil/BladeSlices/BCRW08_mouldlowerblade-H30.SLDPRT
SWKS_hydrofoil/BladeSlices/BCRW08_mouldlowerblade-H40.SLDPRT
SWKS_hydrofoil/BladeSlices/BCRW08_mouldlowerblade-H47.SLDPRT
SWKS_hydrofoil/BladeSlices/BCRW08_mouldlowerblade-H49.SLDPRT
SWKS_hydrofoil/BladeSlices/BCRW08_mouldlowerblade-H5.SLDPRT
SWKS_hydrofoil/BladeSlices/BCRW08_mouldlowerblade-H51.SLDPRT
SWKS_hydrofoil/BladeSlices/BCRW08_mouldlowerblade-H52.SLDPRT
SWKS_hydrofoil/BladeSlices/BCRW08_mouldlowerblade-H54.SLDDRW
SWKS_hydrofoil/BladeSlices/BCRW08_mouldlowerblade-H54.SLDPRT
SWKS_hydrofoil/BladeSlices/BCRW08_mouldlowerblade-H54S.SLDPRT
SWKS_hydrofoil/BladeSlices/BCRW08_mouldlowerblade-H55.SLDPRT
SWKS_hydrofoil/BladeSlices/BCRW08_mouldlowerblade-H55S.SLDPRT
SWKS_hydrofoil/BladeSlices/BCRW08_mouldlowerblade-H56.SLDPRT
SWKS_hydrofoil/BladeSlices/BCRW08_mouldlowerblade-H56P.SLDPRT
SWKS_hydrofoil/BladeSlices/BCRW08_mouldlowerblade-H57.SLDPRT
SWKS_hydrofoil/BladeSlices/BCRW08_mouldlowerblade-H57S.SLDPRT
SWKS_hydrofoil/BladeSlices/BCRW08_mouldlowerblade-H8.SLDPRT
SWKS_hydrofoil/BladeSlices/BCRW08_mouldlowerblade-H9.SLDPRT
SWKS_hydrofoil/BladeSlices/Blade_17_31.SLDDRW
SWKS_hydrofoil/BladeSlices/Blade_1_16.SLDDRW
SWKS_hydrofoil/BladeSlices/Blade_32_41.SLDDRW
SWKS_hydrofoil/BladeSlices/Blade_42_47.SLDDRW
SWKS_hydrofoil/BladeSlices/Blade_48_51.SLDDRW
SWKS_hydrofoil/BladeSlices/Blade_52_53.SLDDRW
SWKS_hydrofoil/BladeSlices/Blade_55.SLDDRW
SWKS_hydrofoil/BladeSlices/Blade_56.SLDDRW
SWKS_hydrofoil/HubSlices/BCRW09_hubCore04-H1.SLDPRT
SWKS_hydrofoil/HubSlices/Hub_13_16.SLDDRW
SWKS_hydrofoil/HubSlices/Hub_17_20.SLDDRW
SWKS_hydrofoil/HubSlices/Hub_1_4.SLDDRW
SWKS_hydrofoil/HubSlices/Hub_21_24.SLDDRW
SWKS_hydrofoil/HubSlices/Hub_25_27.SLDDRW
SWKS_hydrofoil/HubSlices/Hub_28_30.SLDDRW
SWKS_hydrofoil/HubSlices/Hub_5_8.SLDDRW
SWKS_hydrofoil/HubSlices/Hub_9_12.SLDDRW
SWKS_hydrofoil/MouldSlices/BCRW08_mouldlower-S1.DXF
SWKS_hydrofoil/MouldSlices/BCRW08_mouldlower-S1.SLDDRW
SWKS_hydrofoil/MouldSlices/BCRW08_mouldlower-S1.SLDPRT
SWKS_hydrofoil/MouldSlices/BCRW08_mouldlower-S11.SLDPRT
SWKS_hydrofoil/MouldSlices/BCRW08_mouldlower-S15.SLDPRT
SWKS_hydrofoil/MouldSlices/BCRW08_mouldlower-S17.SLDPRT
SWKS_hydrofoil/MouldSlices/BCRW08_mouldlower-S18.SLDPRT
SWKS_hydrofoil/MouldSlices/BCRW08_mouldlower-S2.SLDPRT
SWKS_hydrofoil/MouldSlices/BCRW08_mouldlower-S20.SLDPRT
SWKS_hydrofoil/MouldSlices/BCRW08_mouldlower-S21.SLDPRT
SWKS_hydrofoil/MouldSlices/BCRW08_mouldlower-S22.SLDPRT
SWKS_hydrofoil/MouldSlices/BCRW08_mouldlower-S23.SLDPRT
SWKS_hydrofoil/MouldSlices/BCRW08_mouldlower-S25.SLDPRT
SWKS_hydrofoil/MouldSlices/BCRW08_mouldlower-S26.SLDPRT
SWKS_hydrofoil/MouldSlices/BCRW08_mouldlower-S3.SLDPRT
SWKS_hydrofoil/MouldSlices/BCRW08_mouldlower-S30.SLDPRT
SWKS_hydrofoil/MouldSlices/BCRW08_mouldlower-S31.SLDPRT
SWKS_hydrofoil/MouldSlices/BCRW08_mouldlower-S34.SLDPRT
SWKS_hydrofoil/MouldSlices/BCRW08_mouldlower-S35.SLDPRT
SWKS_hydrofoil/MouldSlices/BCRW08_mouldlower-S36.SLDPRT
SWKS_hydrofoil/MouldSlices/BCRW08_mouldlower-S38.SLDPRT
SWKS_hydrofoil/MouldSlices/BCRW08_mouldlower-S39.SLDPRT
SWKS_hydrofoil/MouldSlices/BCRW08_mouldlower-S4.SLDPRT
SWKS_hydrofoil/MouldSlices/BCRW08_mouldlower-S44.SLDPRT
SWKS_hydrofoil/MouldSlices/BCRW08_mouldlower-S49.SLDPRT
SWKS_hydrofoil/MouldSlices/BCRW08_mouldlower-S50.SLDPRT
SWKS_hydrofoil/MouldSlices/BCRW08_mouldlower-S51.SLDPRT
SWKS_hydrofoil/MouldSlices/BCRW08_mouldlower-S52.SLDPRT
SWKS_hydrofoil/MouldSlices/BCRW08_mouldlower-S54S.SLDPRT
SWKS_hydrofoil/MouldSlices/BCRW08_mouldlower-S55P.SLDPRT
SWKS_hydrofoil/MouldSlices/BCRW08_mouldlower-S56S.SLDPRT
SWKS_hydrofoil/MouldSlices/BCRW08_mouldlower-S57P.SLDDRW
SWKS_hydrofoil/MouldSlices/BCRW08_mouldlower-S57S.SLDPRT
SWKS_hydrofoil/MouldSlices/BCRW08_mouldlower-S57UP.SLDPRT
SWKS_hydrofoil/MouldSlices/BCRW08_mouldlower-S58LP.SLDPRT
SWKS_hydrofoil/MouldSlices/BCRW08_mouldlower-S58S.SLDPRT
SWKS_hydrofoil/MouldSlices/BCRW08_mouldlower-S58UP.SLDPRT
SWKS_hydrofoil/MouldSlices/BCRW08_mouldlower-S8.SLDPRT
SWKS_hydrofoil/MouldSlices/BCRW08_mouldlower.SLDDRW
SWKS_hydrofoil/MouldSlices/BCRW08_mouldlower2.SLDDRW
SWKS_hydrofoil/MouldSlices/BCRW08_mouldlower3.SLDDRW
SWKS_hydrofoil/MouldSlices/Slices_15_21.SLDDRW
SWKS_hydrofoil/MouldSlices/Slices_1_14.SLDDRW
SWKS_hydrofoil/MouldSlices/Slices_22_26.SLDDRW
SWKS_hydrofoil/MouldSlices/Slices_27_30.SLDDRW
SWKS_hydrofoil/MouldSlices/Slices_31_34.SLDDRW
SWKS_hydrofoil/MouldSlices/Slices_35_38.SLDDRW
SWKS_hydrofoil/MouldSlices/Slices_39_42.SLDDRW
SWKS_hydrofoil/MouldSlices/Slices_43_44.SLDDRW
SWKS_hydrofoil/MouldSlices/Slices_46_47.SLDDRW
SWKS_hydrofoil/MouldSlices/Slices_47_48.SLDDRW
SWKS_hydrofoil/MouldSlices/Slices_48_49.SLDDRW
SWKS_hydrofoil/MouldSlices/Slices_49.SLDDRW
SWKS_hydrofoil/MouldSlices/Slices_50_51.SLDDRW
SWKS_hydrofoil/MouldSlices/Slices_52_53.SLDDRW
SWKS_hydrofoil/MouldSlices/Slices_54_54.SLDDRW
SWKS_hydrofoil/MouldSlices/Slices_56_59.DWG
SWKS_hydrofoil/MouldSlices/Slices_56_59.SLDDRW
