TobyBorland/HydroTurbineBlade/docs/images/•Turbine-installation-x-2.jpg

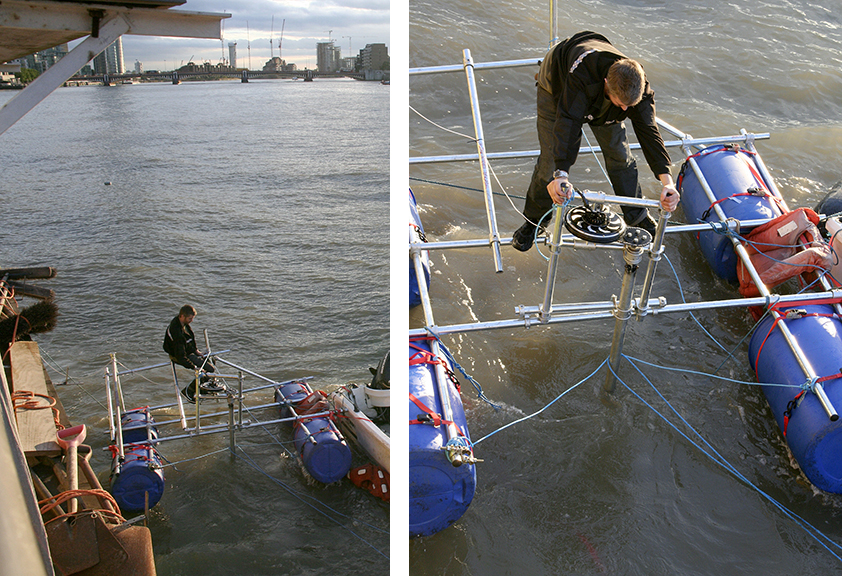
docs/images/•Turbine-installation-x-2.jpg
