TobyBorland/HydroTurbineBlade/SWKS_hydrofoil/BCRW08_mouldlower_guide.PDF

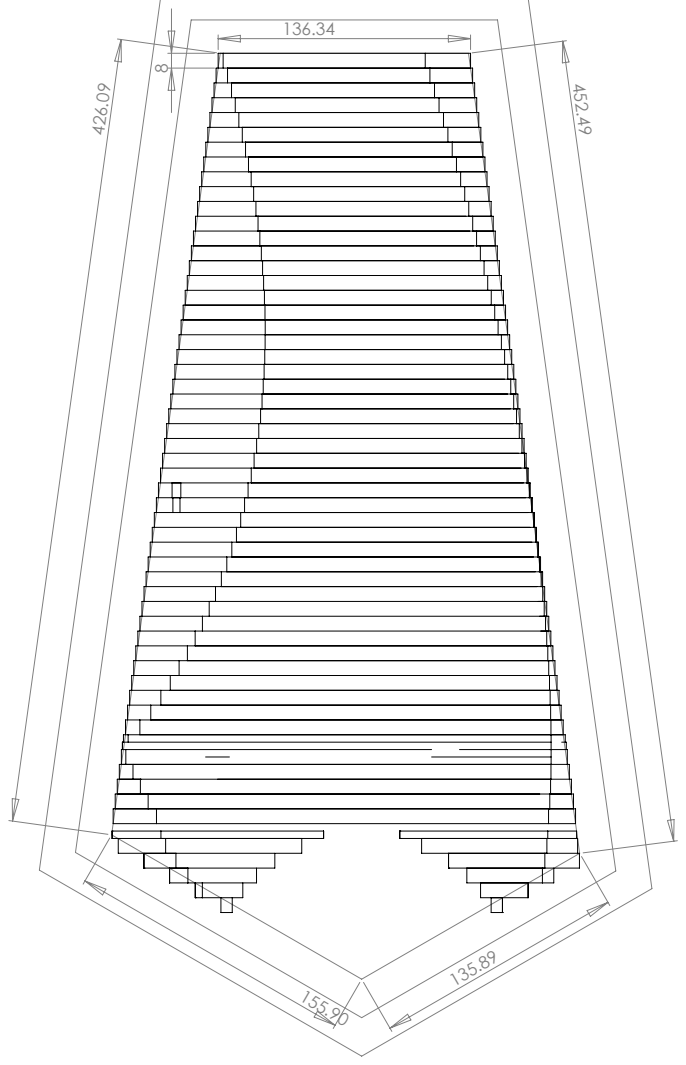
[picture p189: page 1]
